jeshernandez/PiTrac/docs/hardware/hardware.md

---
title: Hardware
layout: default
nav_order: 4
has_children: true
description: Complete hardware build guide for PiTrac golf launch monitor including parts list, PCB assembly, 3D printing enclosure, and final assembly instructions.
keywords: DIY golf hardware, launch monitor parts, raspberry pi golf components, PCB assembly golf, 3D print golf enclosure
og_image: /assets/images/logos/PiTrac_Square.png
last_modified_date: 2026-02-20
---

# Hardware

This section covers all the physical components you'll need to build PiTrac, from individual parts to complete assembly guides.

## What you'll find here:

- **[Parts List]({% link hardware/parts-list.md %})** - Complete list of components and supplies needed
- **[Assembly Guide]({% link hardware/assembly-guide.md %})** - Step-by-step instructions for building the V1 enclosure
- **[3D Printing]({% link hardware/3d-printing.md %})** - Guide to printing the V1 and V2 enclosure components
- **[PCB Assembly]({% link hardware/pcb-assembly.md %})** - Instructions for building the connector and led boards
- **[V3 Enclosure Print and Assembly]({% link hardware/V3 Enclosure.md %})** - Instructions for printing and assembly of the V3 Enclosure

<div style="display: flex; gap: 10px; justify-content: center;">
  <div style="text-align: center;">
    <strong>V1</strong><br>
    
  </div>
  <div style="text-align: center;">
    <strong>V2</strong><br>
    
  </div>
  <div style="text-align: center;">
    <strong>V3</strong><br>
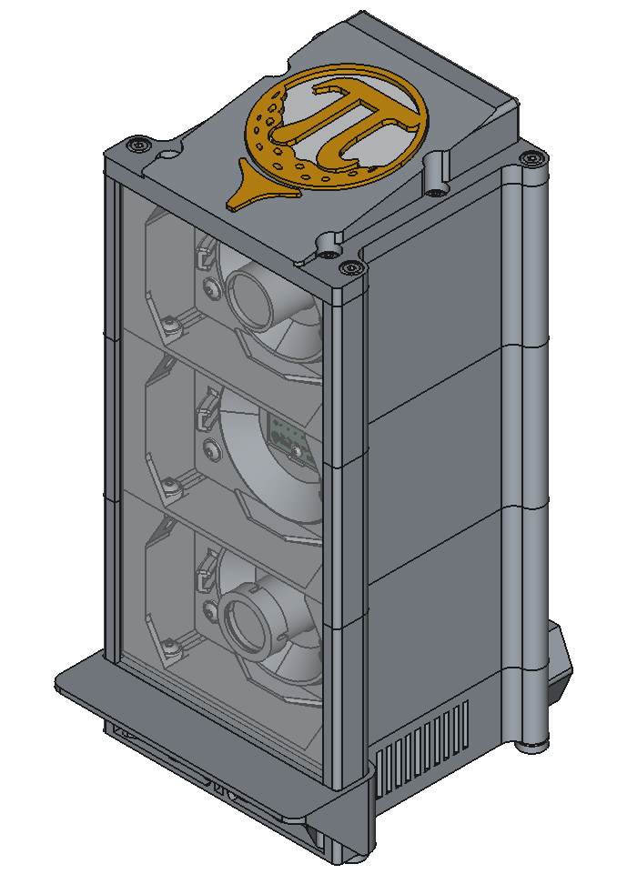
[picture p1: docs/assets/images/V3_Enclosure/PiTrac_V3-Enclosure_crop.png]
    
  </div>
</div>

Before ordering parts, make sure to check the [Roadmap]({% link roadmap.md %}) to understand which version you should build.
