jeshernandez/PiTrac/docs/software/software.md

---
title: Software
layout: default
nav_order: 5
has_children: true
description: Complete software setup guide for PiTrac including Raspberry Pi OS installation, PiTrac software installation, web dashboard configuration, and camera calibration.
keywords: raspberry pi golf software, launch monitor software install, pitrac setup, golf tracker configuration, raspberry pi OS setup
og_image: /assets/images/logos/PiTrac_Square.png
last_modified_date: 2025-01-04
---

# Software

This section covers the software setup and operation of PiTrac, from initial Raspberry Pi configuration to running the system and connecting to simulators.

## What you'll find here:

- **[Raspberry Pi Setup]({% link software/pi-setup.md %})** - Imaging and initial configuration of the Raspberry Pi
- **[PiTrac Installation]({% link software/pitrac-install.md %})** - Building and installing PiTrac software
- **[Using PiTrac]({% link software/using-pitrac.md %})** - Web interface, configuration, and calibration

Before starting software setup, ensure you have completed the [Hardware Assembly]({% link hardware/assembly-guide.md %}) and have all required parts from the [Parts List]({% link hardware/parts-list.md %}).
