jeshernandez/PiTrac/Hardware/Connector Board v2/Design/Pi Connector Strobe Capacitance.xlsx

C | 101.5 | uF
V | 36 | V
Vdroop | 0.25 | V
T | 8 | us
If boost zero duty cycle DOES work
Strobe | Voltage | Joules | DeltaJoules | Power
 | 36 | 0.065772
1 | 35.75 | 0.06486167187 | 0.000910328125 | 113.7910156 | This should be approximately your intended power level
 |  |  |  |  | For example at time of writing we want 36V x 3A = ~108W
If boost zero duty cycle control does NOT work
Strobe | Voltage | Joules | DeltaJoules | Power
 | 36 | 0.065772
1 | 35.75 | 0.06486167187 | 0.000910328125 | 113.7910156
2 | 35.5 | 0.0639576875 | 0.000903984375 | 112.9980469
3 | 35.25 | 0.06306004687 | 0.000897640625 | 112.2050781
4 | 35 | 0.06216875 | 0.000891296875 | 111.4121094
5 | 34.75 | 0.06128379687 | 0.000884953125 | 110.6191406
6 | 34.5 | 0.0604051875 | 0.000878609375 | 109.8261719
7 | 34.25 | 0.05953292187 | 0.000872265625 | 109.0332031
8 | 34 | 0.058667 | 0.000865921875 | 108.2402344
9 | 33.75 | 0.05780742188 | 0.000859578125 | 107.4472656
10 | 33.5 | 0.0569541875 | 0.000853234375 | 106.6542969
