jeshernandez/PiTrac/Hardware/Connector Board v2/Design/Pi Connector Boost Converter.xlsx

Vin | 5 | V
Vout | 42 | V
D | 0.8928571429 | %
Iout | 0.1 | A
Fs | 750 | kHz
deltaI | 0.252 | A
Lest | 2.330561854e-05 | H
L | 33 | uH
deltaIL | 0.1803751804 | A
Ipk | 1.023520924 | A
Vrip | 0.1 | V
Coutmin | 1.19047619e-06 | F
Coutmin2 | 2.836879433e-05 | F
Cout | 101.5 | uF
ESR | 3.3 | mohm | 0.004 || 0.02
Voutesr | 0.003377619048 | V
Mc | 7.637558938
Rcs | 0.2 | ohm
Sn | 30.3030303 | mV/us
Se | 201.1381496 | mV/us
SRC | 1800 | mV/us
Rcsf | 3.132440695 | kohm
wesrz | 2985520.227 | rad/s
fesrz | 475.1603018 | khz
CFB | 3.3495e-05 | uF
