jeshernandez/PiTrac/Hardware/Archive/Connector Board v0.2/README.md

**Description:**

A small PCB that supports:

1. high-speed (up to 1MHz), isolated switching of a high-power signal (12V, 100W) to a device such as an LED strobe; and
2. connecting a GPIO camera shutter signal from one Raspberry Pi to the external trigger (XTR) of a Pi Global Shutter (GS) Camera that is connected to a _second_ Raspberry Pi.

The board uses high-speed opto-isolators to keep the power plane of the two Pi’s isolated from each other and from the 12V switching circuit.

The PCB itself can be manufactured fairly inexpensively from the fabrication outputs at place like <https://jlcpcb.com/> and <https://pcbway.com> .

The [PiTrac DIY golf launch monitor project](https://hackaday.io/project/195042-diy-golf-launch-monitor) is using this board to drive its infrared strobe light and to allow one Pi to trigger the shutter of a second Pi. This is all used to capture the stop-motion images for the monitor.

Please consider supporting this work and the DIY LM project here: <https://ko-fi.com/PiTrac>  

**Parts Needed for Assembly:**

| **Item** | **Qty** | **Reference(s)** | **Value** | **LibPart** | **Footprint / Details** |
| --- | --- | --- | --- | --- | --- |
| 1 | 1 | J3  | ~ | [USB B Micro Female Pinboard](https://www.amazon.com/Pinboard-MELIFE-Interface-Adapter-Breakout/dp/B07W6T97HZ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) | The included pin headers can be used for the parts below |
| 2 | 2 | R1, R4 | 330 ohm R | Resistor (1/4 Watt)<br><br>A decent assortment kit is [here](https://www.amazon.com/gp/product/B003UC4FSS/ref=ppx_yo_dt_b_search_asin_title?ie=UTF8&psc=1) | Resistor_THT:R_Axial_DIN0207_L6.3mm_D2.5mm_P10.16mm_Horizontal |
| 3 | 2 | R2, R3 | 270 ohm R | Resistor (1/4 Watt)| Resistor_THT:R_Axial_DIN0207_L6.3mm_D2.5mm_P10.16mm_Horizontal |
| 4 | 3 | Shutter1, Strobe1, Sys1_GND1 | ~ | &lt;These are just test-point holes to solder test wires into&gt; | TestPoint:TestPoint_THTPad_2.5x2.5mm_Drill1.2mm |
| 5 | 1 | Sys1_Conn1 | ~ | 4 Pin Header | Connector_PinHeader_2.54mm:PinHeader_1x04_P2.54mm_Vertical |
| 6 | 1 | Sys2_Conn1 | ~ | 3 Pin Header | Connector_PinHeader_2.54mm:PinHeader_1x03_P2.54mm_Vertical |
| 7 | 2 | U2, U3 | H11L1 | [Isolator:H11L1](https://www.amazon.com/dp/B09KM2BJCF?ref_=pe_386300_442618370_TE_sc_as_ri_0) | Package_DIP:DIP-6_W7.62mm |
| 8 | 1 | U4  | 74HC04 | 74xx:74HC04 | Package_DIP:DIP-14_W7.62mm_Socket |
| 9 | 1 | U5  | ~ | [Dual_Mos_Driver_Module](https://www.amazon.com/Anmbest-High-Power-Adjustment-Electronic-Brightness/dp/B07NWD8W26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) | Verdant_Custom_Footprint_Library:PCB Dual MOS Driver Module |
| | 2 | 2.5M Bolt<br><br>2.5M Nut | | | These help mechanically tie down the USB-B power connector to the board |
| | 2 | 6 - pin DIP socket | | &lt;Optional&gt;<br><br>A decent assortment kit is [here](https://www.amazon.com/dp/B01GOLSUAU?ref=ppx_yo2ov_dt_b_fed_asin_title) | The opto-isolators and the hex inverter chip are the most likely to be blown up or injured by solder over-temps.  So best to put them in sockets. |
| | 1 | 14 - pin DIP socket<br><br>&lt;Optional&gt; | | &lt;Optional&gt; | |

**Note:** A 5V USB-B power supply with a male micro-USB connector is currently necessary to run the board. The supply is used as an isolated, independent (downstream of a transformer) power plane to try to keep the Pi’s and the Pi Camera safe.

**Final view of top/bottom of completed PCB:**





**NOTE:** Don’t be like the people who made the above boards. For example, use flux-cleaner to get rid of the excess flux when you are done!

**Assembly Notes (see supporting images of the board):**

1. If desired (we suggest it), solder the two 6-Pin DIP sockets and one 14 pin DIP socket for the H11 opto-isolators and the 740s4 hex inverter.
2. Use the two 2.5M bolts and nuts (nuts on the bottom of the PCB) to secure the USB board to the lower-left corner. Strip 1” of a thin wire bare and cut in two half-inch pieces that will fit through the VCC and GND holes of the USB board and through the back of the Connector Board PCB. Bend the ends to hold the wires in place and solder and trim.
3. Solder a header pin post (see picture) into the GND and TRIG holes on the left side of the Dual MOS Driver Module so that at least 2mm of pin sticks out the bottom. Using these headers makes it easier to test-probe the trigger signal. Then insert the lower parts of the pins (as well as the four parts of the pins sticking out below the screw terminals) into the Connector Board PCB and solder. Alternatively, the same wire-through-the component-and-board technique used for the USB board can be used here. The four terminals below the screw terminals are not electrically important for the PCB, but soldering them helps mechanically secure the Dual-MOS switching component.
4. It is useful (but not necessary) to solder three wires to the test ports on the left of the PCB. When something is not working, the ability to hook an oscilloscope up to these ports is important. If you strip the wires on the other end away from the board, make sure you protect them from accidentally contacting other component. [These plugs](https://github.com/jamespilgrim/Wire-end-Plug) can be used for that purpose.
5. Attach the 12V input and output wire pairs to the Dual MOS component’s screw terminals. It’s best NOT to tin the ends, as the terminals seem to make better contact that way. Add some plugs (e.g.,  [Ideal Industries 30-102 Power Plug](https://www.amazon.com/Ideal-Industries-30-102-Power-72427/dp/B01LYF1WV9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).) to the ends of the leads to make it easier to connect/disconnect them later to the strobe and the LED power supply. The use of different ends for input and output (e.g., one male, one female) may make it more difficult to later plug these in wrong (output to input)!
