jeshernandez/PiTrac/Dev/img/menu.png

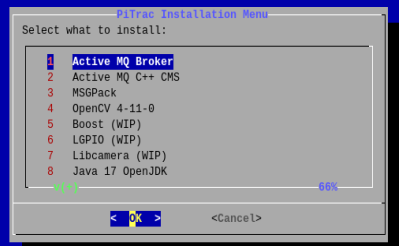
Dev/img/menu.png
