jeshernandez/PiTrac/docs/assets/images/hardware/0805.png

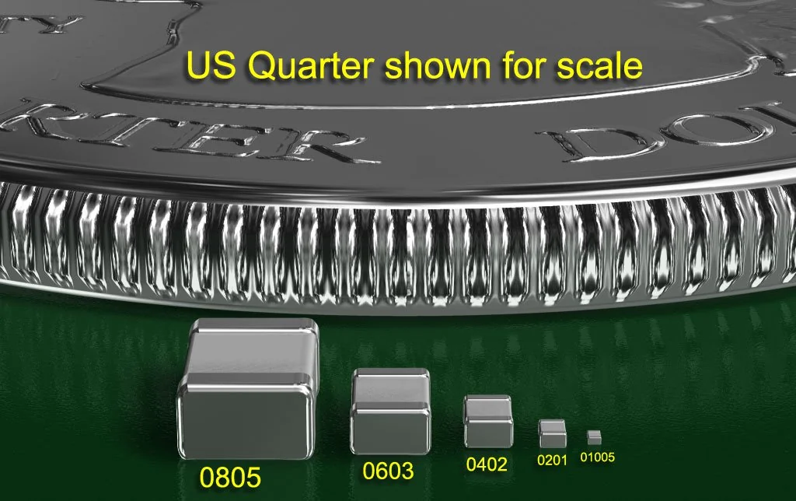
docs/assets/images/hardware/0805.png
