jeshernandez/PiTrac/docs/assets/images/index_replace_name.png

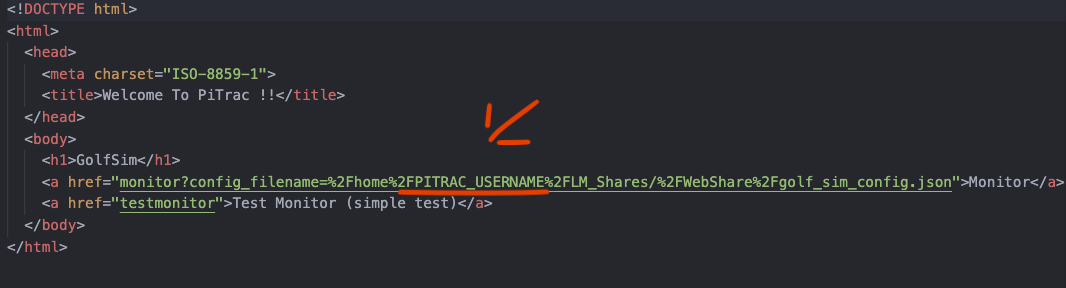
docs/assets/images/index_replace_name.png
