jeshernandez/PiTrac/docs/assets/images/interface/dashboard_dark.png

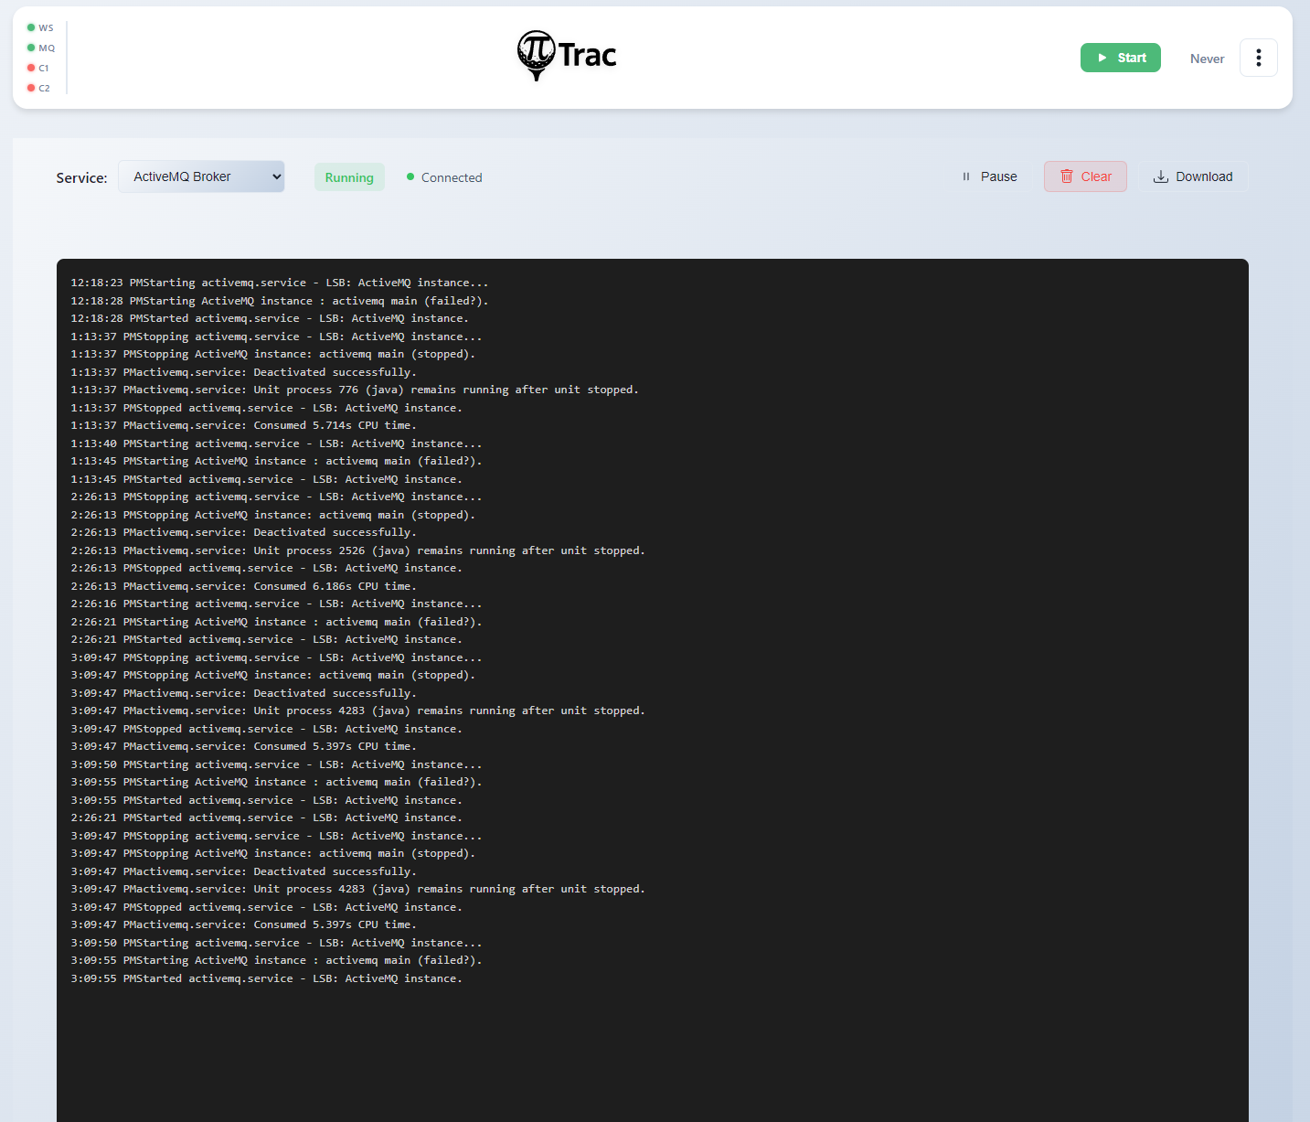
docs/assets/images/interface/dashboard_dark.png
