jeshernandez/PiTrac/Hardware/Connector Board v2/Board Bottomside.png

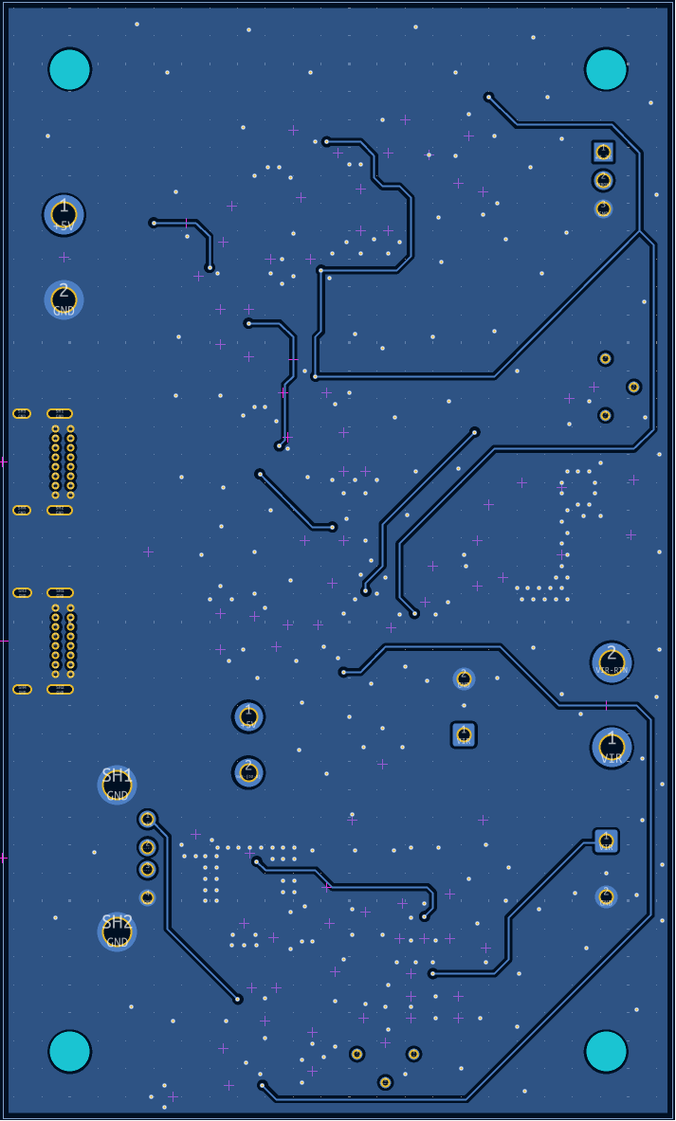
Hardware/Connector Board v2/Board Bottomside.png
