jeshernandez/PiTrac/Hardware/Connector Board v2/Board Topside.png

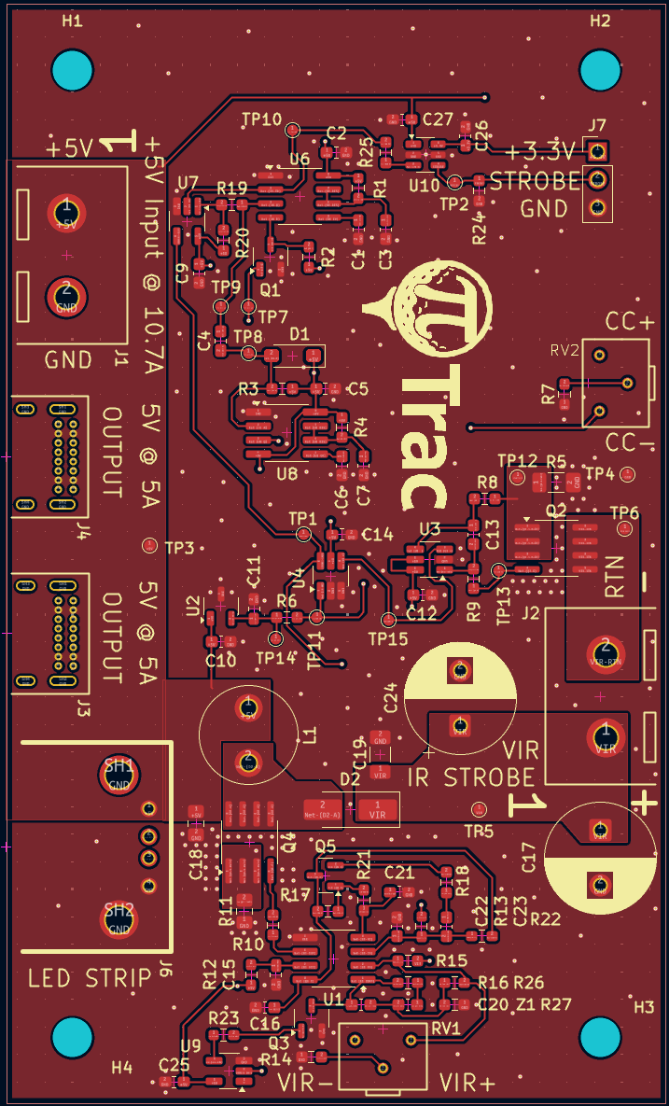
Hardware/Connector Board v2/Board Topside.png
