jeshernandez/PiTrac/Software/LMSourceCode/Images/strobed.png

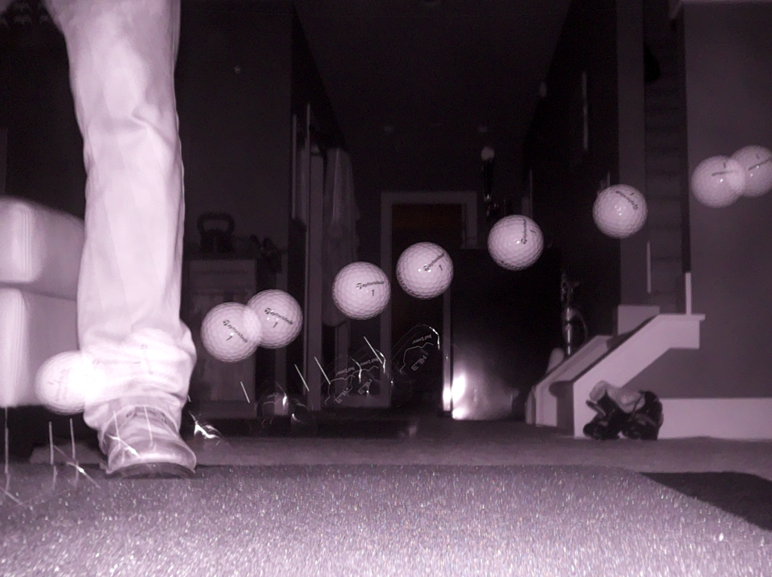
Software/LMSourceCode/Images/strobed.png
