jeshernandez/PiTrac/Software/LMSourceCode/Images/teed-ball.png

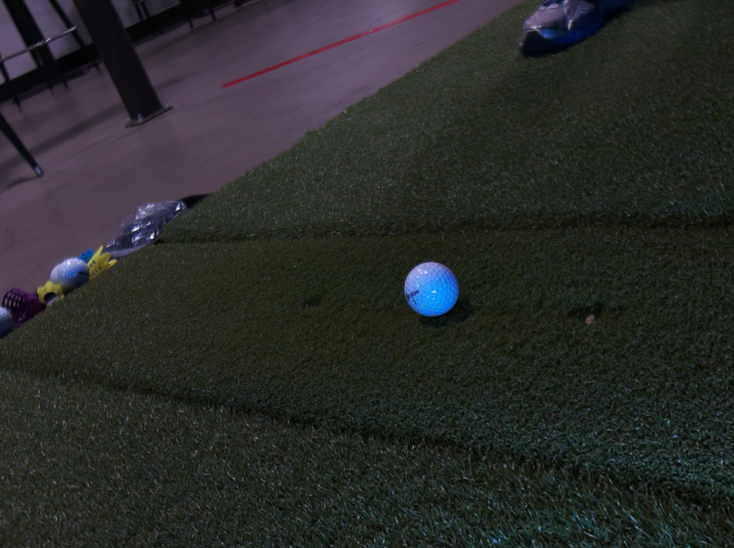
Software/LMSourceCode/Images/teed-ball.png
