jeshernandez/PiTrac/Hardware/Assembly Files/IRLED2 Only PCB/IRLED2 Only Assembly/IRLED2 Only Bill of Materials.csv

Reference | Qty | Manufacturer | Part Number | Footprint
D6,D7,D8,D9,D10,D11,D12,D13,D14,D15 | 10 | Vishay Semiconductor Opto Division | VSMA1085400 | Pi Connector Parts:VSMA1085400
