jeshernandez/PiTrac/Hardware/Connector Board v2/Design/Pi Connector Adjustable Constant Current.xlsx

Vin | 2.5 | V
R1 | 24 | kohm
R2 | 0.25 | kohm | This is the adjustable resistor
R3 | 0.75 | kohm
Vout | 0.1 | V
Rcs | 33 | mohm
Iout | 3.03030303 | A
PR | 0.303030303 | W
