jeshernandez/PiTrac/Hardware/Connector Board v2/Design/Pi Connector Adjustable Strobe Voltage.xlsx

Vfb | 2 | V
Ifbmin | 0.0002 | A
R1 | 4990 | ohm
R2 | 44 | ohm | This is the adjustable resistor
R3 | 249 | ohm
Vout | 36.06143345 | V
Ifbr | 0.0003972983711 | A | Must be greater than Ifbmin
