jeshernandez/PiTrac/3D Printed Parts/Enclosure Version 3/Assets/Part pictures/5x2IRLED_Eyeball.png

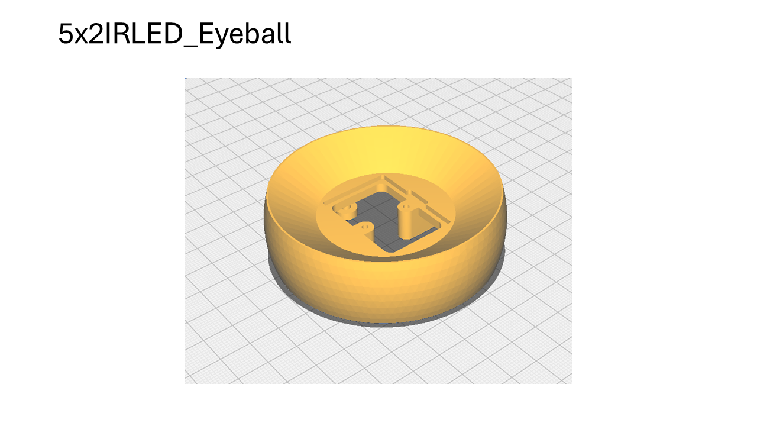
3D Printed Parts/Enclosure Version 3/Assets/Part pictures/5x2IRLED_Eyeball.png
