jeshernandez/PiTrac/3D Printed Parts/Enclosure Version 3/Assets/Part pictures/Ambient_LED_Screen.PNG

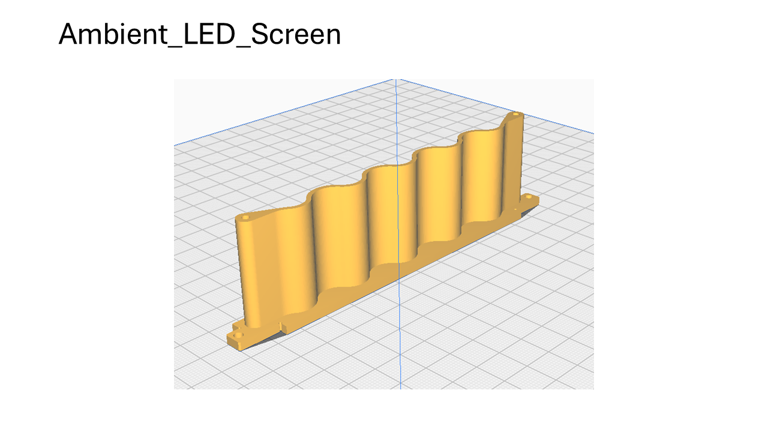
3D Printed Parts/Enclosure Version 3/Assets/Part pictures/Ambient_LED_Screen.PNG
