jeshernandez/PiTrac/3D Printed Parts/Enclosure Version 3/Assets/Part pictures/Ambient_Led_Visor.PNG

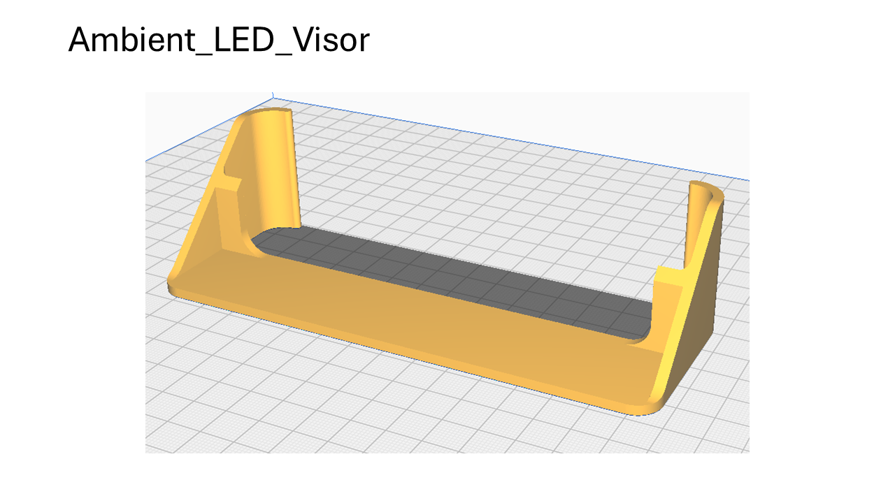
3D Printed Parts/Enclosure Version 3/Assets/Part pictures/Ambient_Led_Visor.PNG
