jeshernandez/PiTrac/3D Printed Parts/Enclosure Version 3/Assets/Part pictures/Back_Interface_Plate.PNG

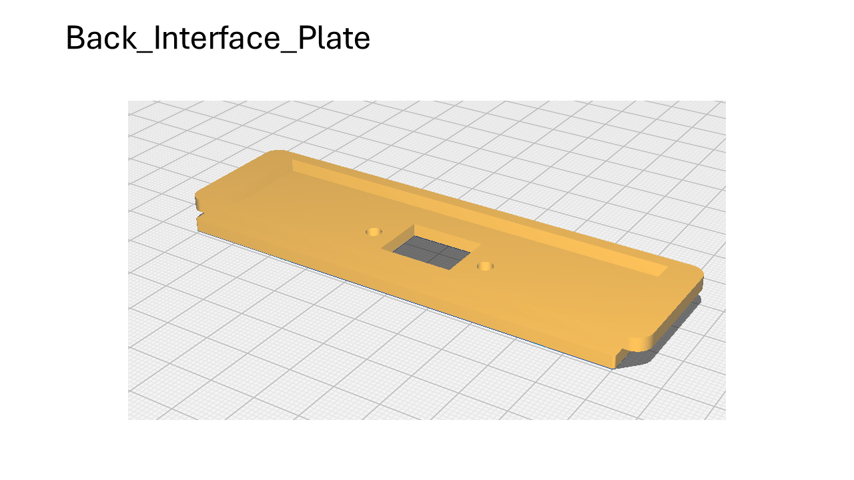
3D Printed Parts/Enclosure Version 3/Assets/Part pictures/Back_Interface_Plate.PNG
