jeshernandez/PiTrac/3D Printed Parts/Enclosure Version 3/Assets/Part pictures/Carrier_Clamps.PNG

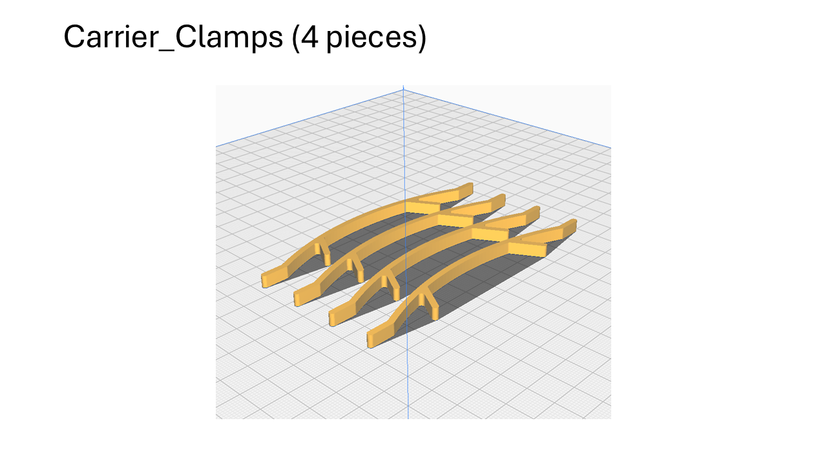
3D Printed Parts/Enclosure Version 3/Assets/Part pictures/Carrier_Clamps.PNG
