jeshernandez/PiTrac/3D Printed Parts/Enclosure Version 3/Assets/Part pictures/ConnectorBoardv2-Mod_Carrier.PNG

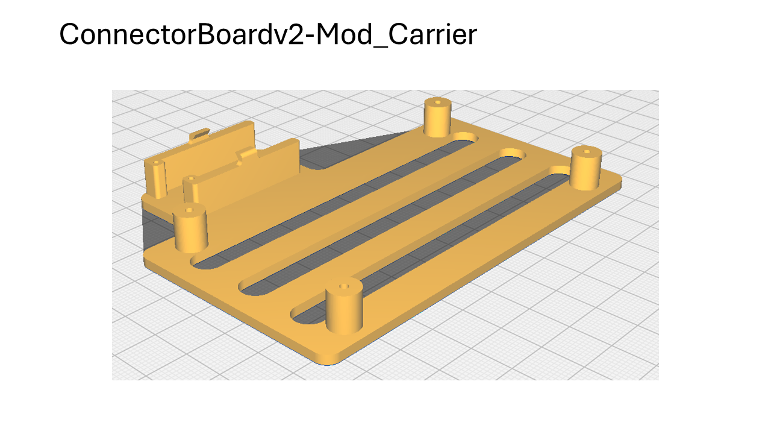
3D Printed Parts/Enclosure Version 3/Assets/Part pictures/ConnectorBoardv2-Mod_Carrier.PNG
