jeshernandez/PiTrac/3D Printed Parts/Enclosure Version 3/Assets/Part pictures/ConnectorBoardv3_Carrier.png

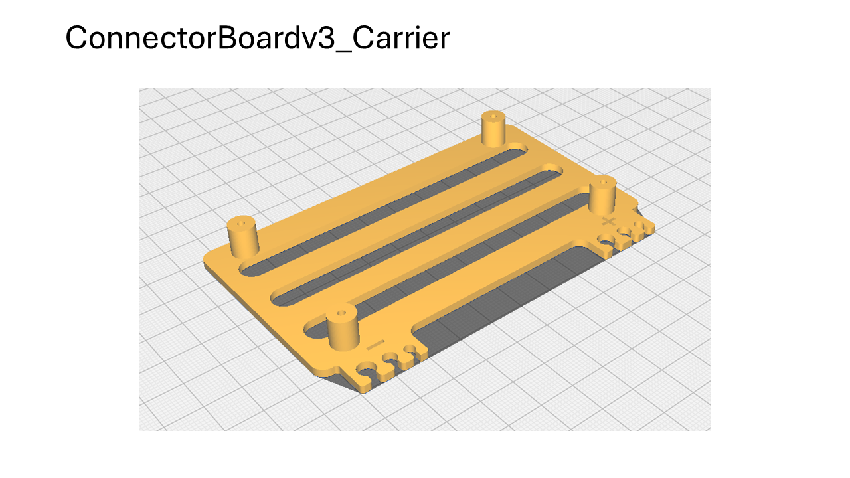
3D Printed Parts/Enclosure Version 3/Assets/Part pictures/ConnectorBoardv3_Carrier.png
