jeshernandez/PiTrac/3D Printed Parts/Enclosure Version 3/Assets/Part pictures/EyeScreen.PNG

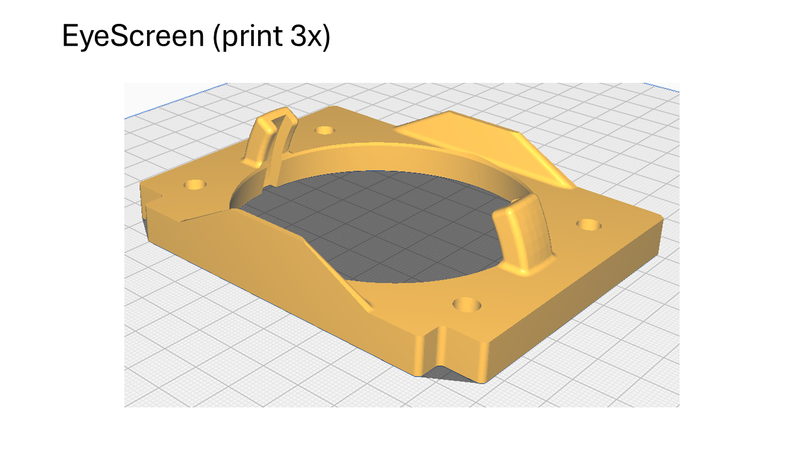
3D Printed Parts/Enclosure Version 3/Assets/Part pictures/EyeScreen.PNG
