jeshernandez/PiTrac/3D Printed Parts/Enclosure Version 3/Assets/Part pictures/Foot.PNG

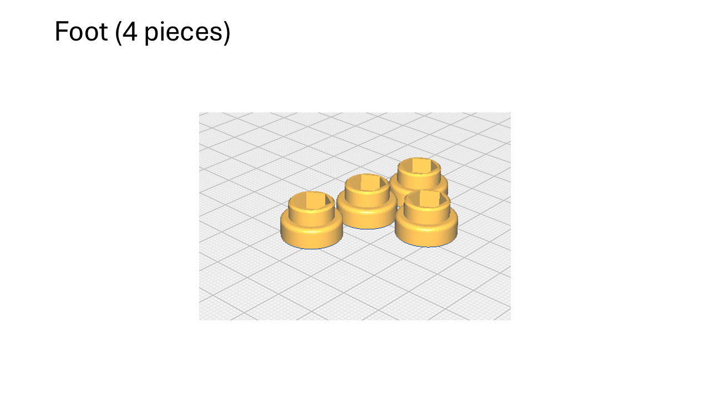
3D Printed Parts/Enclosure Version 3/Assets/Part pictures/Foot.PNG
