jeshernandez/PiTrac/3D Printed Parts/Enclosure Version 3/Assets/Part pictures/IMX296-MPI_Eyeball_6mm.PNG

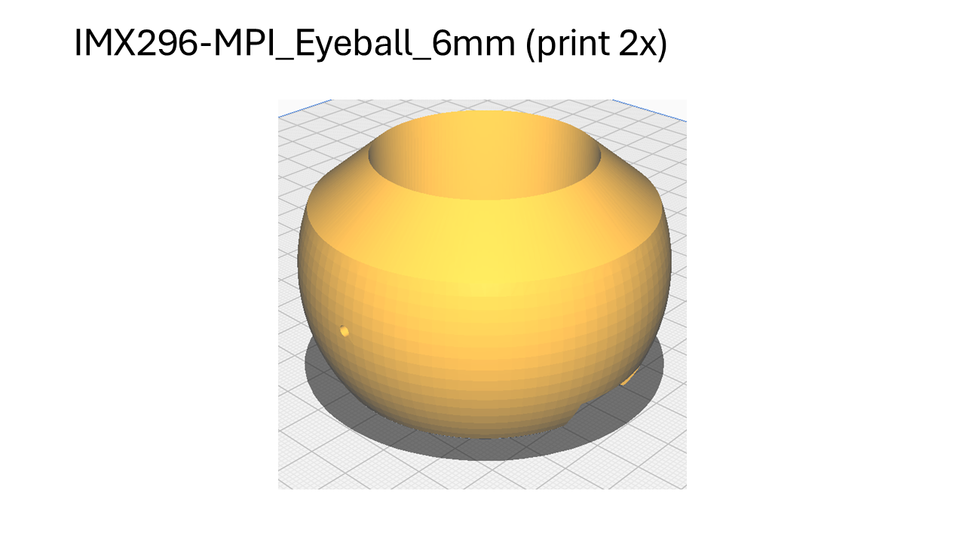
3D Printed Parts/Enclosure Version 3/Assets/Part pictures/IMX296-MPI_Eyeball_6mm.PNG
