jeshernandez/PiTrac/3D Printed Parts/Enclosure Version 3/Assets/Part pictures/LED_Clamp.PNG

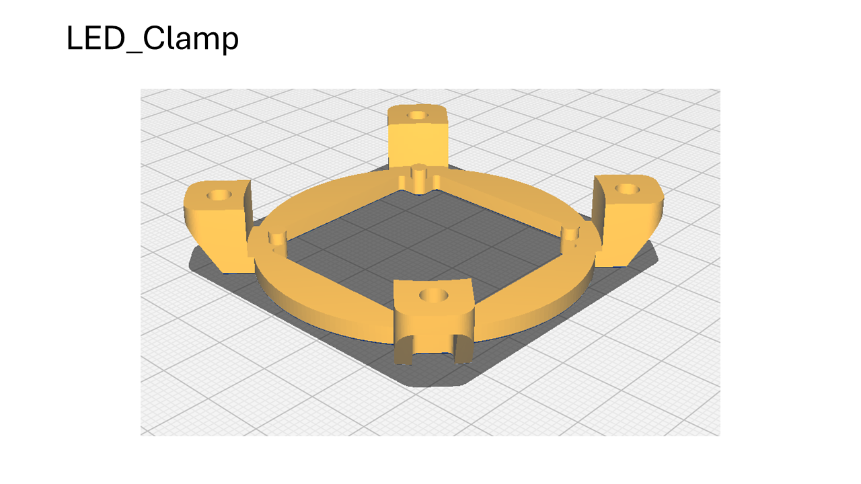
3D Printed Parts/Enclosure Version 3/Assets/Part pictures/LED_Clamp.PNG
