jeshernandez/PiTrac/3D Printed Parts/Enclosure Version 3/Assets/Part pictures/LED_Eyeball.PNG

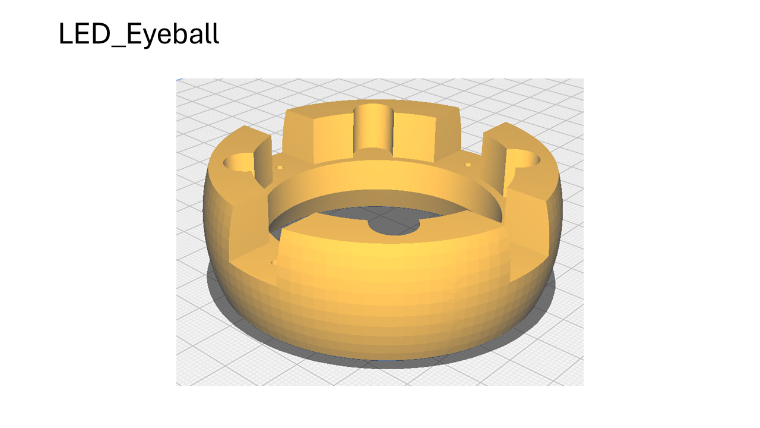
3D Printed Parts/Enclosure Version 3/Assets/Part pictures/LED_Eyeball.PNG
