jeshernandez/PiTrac/3D Printed Parts/Enclosure Version 3/Assets/Part pictures/LinePower_Cover.PNG

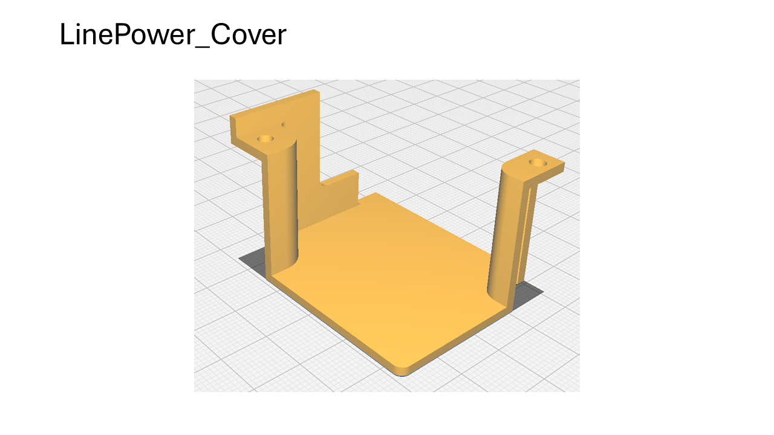
3D Printed Parts/Enclosure Version 3/Assets/Part pictures/LinePower_Cover.PNG
