jeshernandez/PiTrac/3D Printed Parts/Enclosure Version 3/Assets/Part pictures/Pi5_Bagpack _top _bottom.png

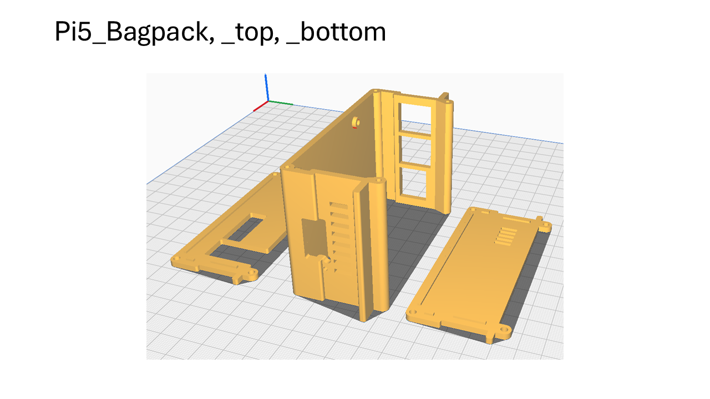
3D Printed Parts/Enclosure Version 3/Assets/Part pictures/Pi5_Bagpack _top _bottom.png
