jeshernandez/PiTrac/3D Printed Parts/Enclosure Version 3/Assets/Part pictures/Pi5_Carrier_vertical_3mm.PNG

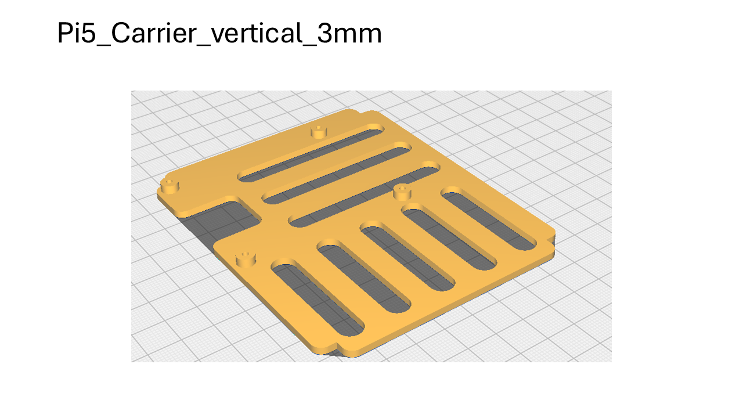
3D Printed Parts/Enclosure Version 3/Assets/Part pictures/Pi5_Carrier_vertical_3mm.PNG
