jeshernandez/PiTrac/3D Printed Parts/Enclosure Version 3/Assets/Part pictures/Spacer.PNG

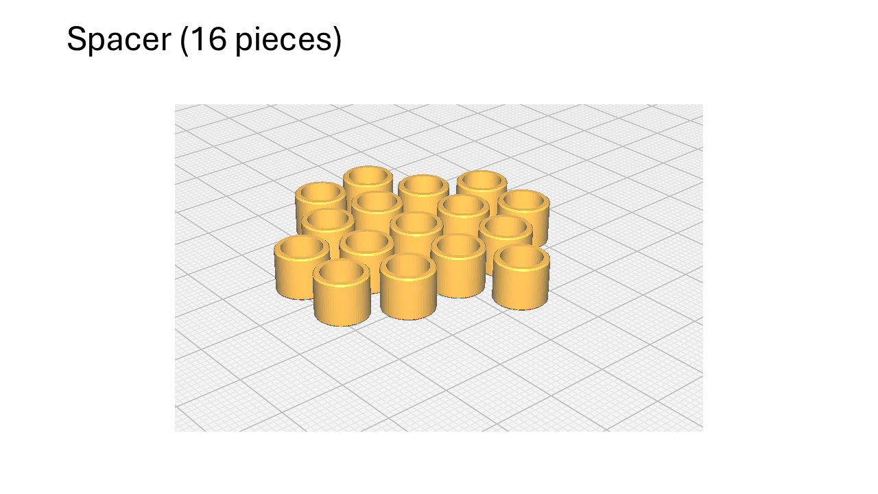
3D Printed Parts/Enclosure Version 3/Assets/Part pictures/Spacer.PNG
