jeshernandez/PiTrac/3D Printed Parts/Enclosure Version 3/Assets/Part pictures/Stack_Module_PSU.PNG

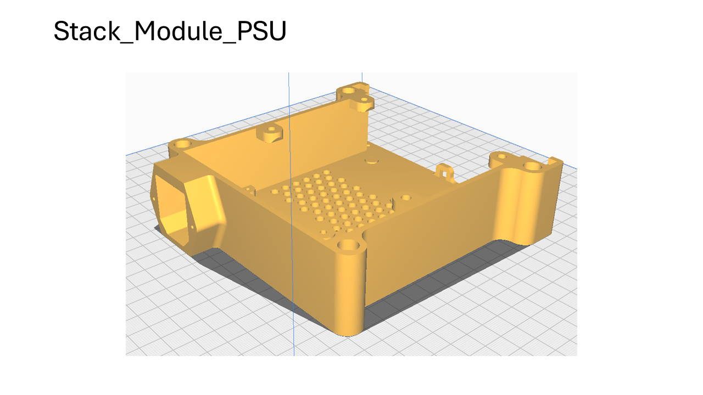
3D Printed Parts/Enclosure Version 3/Assets/Part pictures/Stack_Module_PSU.PNG
