jeshernandez/PiTrac/3D Printed Parts/Enclosure Version 3/Assembly/Assembly4/Assy_Camera_Eyeball.FCStd

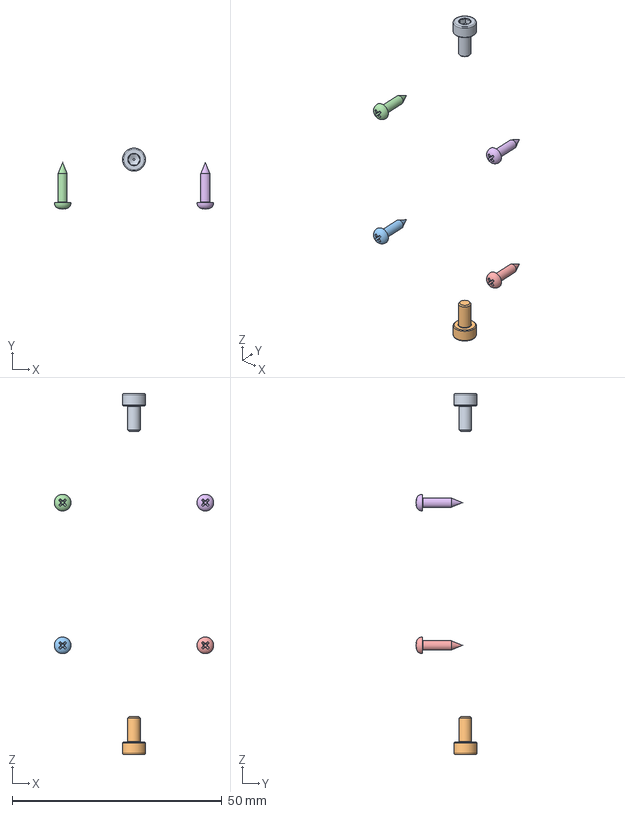
[picture p55: CAD file, 2026-04-10]
3D Printed Parts/Enclosure Version 3/Assembly/Assembly4/Assy_Camera_Eyeball.FCStd
38.0 x 14.5 x 86.0 mm
M3x6-Screw
M3x6-Screw001
ST2.2x9.5-Screw013
ST2.2x9.5-Screw
ST2.2x9.5-Screw014
ST2.2x9.5-Screw015
