jeshernandez/PiTrac/3D Printed Parts/Enclosure Version 3/Assembly/Assembly4/Assy_PiTracIRLED.FCStd

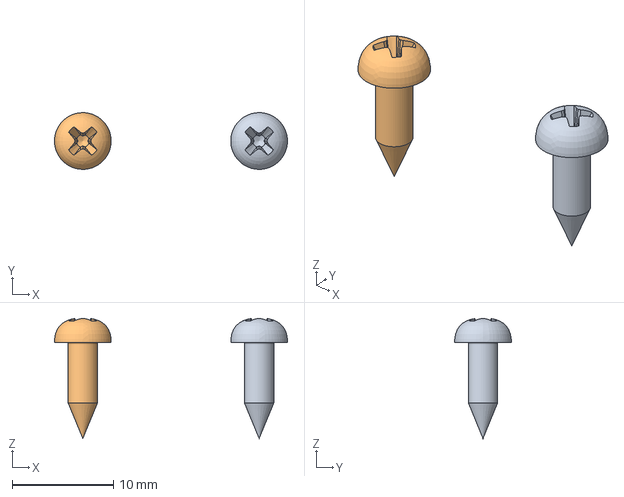
[picture p56: CAD file, 2026-04-10]
3D Printed Parts/Enclosure Version 3/Assembly/Assembly4/Assy_PiTracIRLED.FCStd
23.0 x 5.60 x 11.8 mm
ST2.9x9.5-Screw
ST2.9x9.5-Screw001
