jeshernandez/PiTrac/3D Printed Parts/Enclosure Version 3/Assembly/Assembly4/Assy_Stack_Module.FCStd

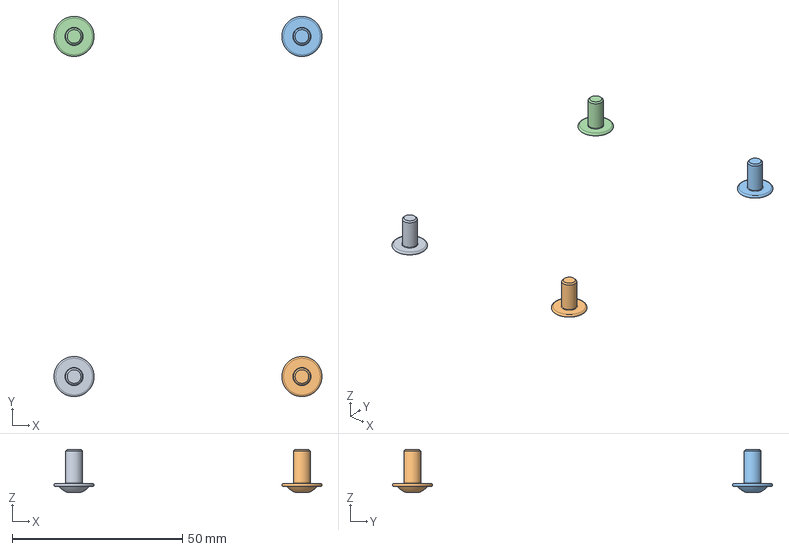
[picture p57: CAD file, 2026-04-10]
3D Printed Parts/Enclosure Version 3/Assembly/Assembly4/Assy_Stack_Module.FCStd
78.8 x 111.8 x 12.8 mm
M5x10-Screw
M5x10-Screw007
M5x10-Screw008
M5x10-Screw009
