jeshernandez/PiTrac/3D Printed Parts/Enclosure Version 3/Assembly/Assembly4/Assy_EyeScreen_Clamp.FCStd

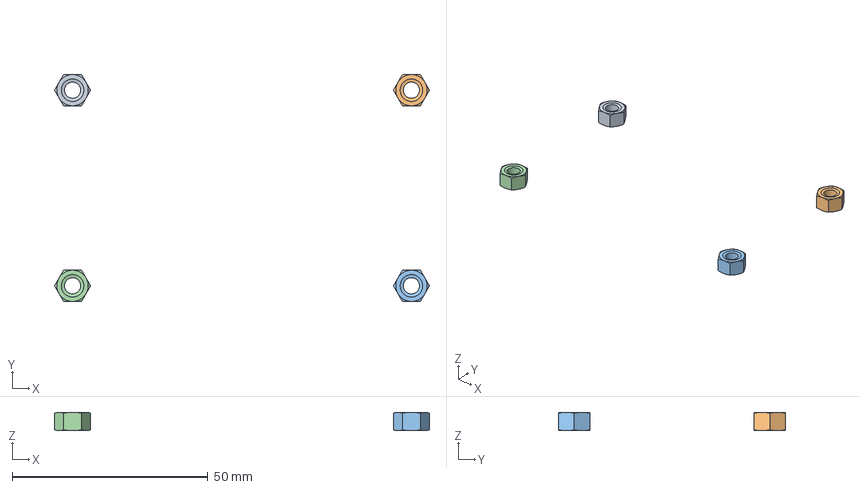
[picture p58: CAD file, 2026-04-10]
3D Printed Parts/Enclosure Version 3/Assembly/Assembly4/Assy_EyeScreen_Clamp.FCStd
95.8 x 58.0 x 4.70 mm
M5-Nut
M5-Nut004
M5-Nut005
M5-Nut006
