jeshernandez/PiTrac/3D Printed Parts/Enclosure Version 3/Assembly/Assembly4/Assy_RaspberryPi5_carrier.FCStd

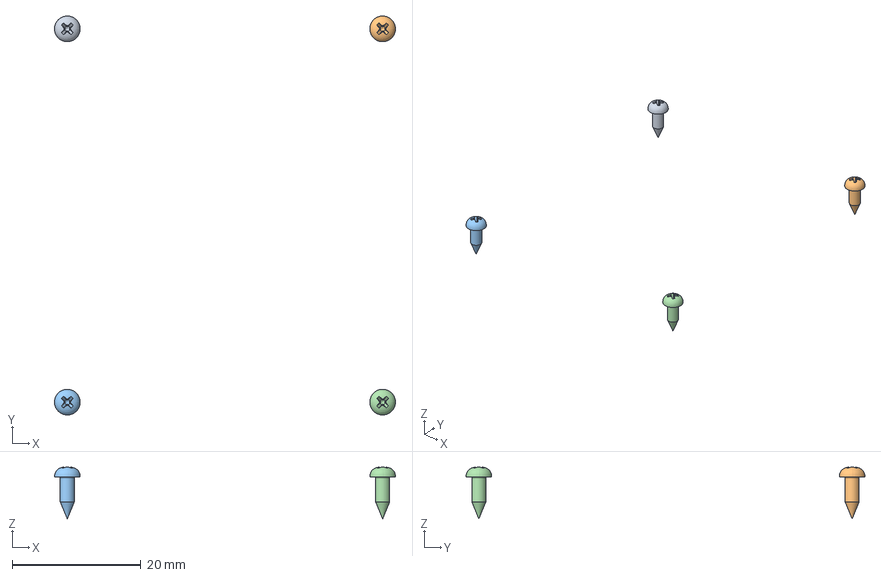
[picture p59: CAD file, 2026-04-10]
3D Printed Parts/Enclosure Version 3/Assembly/Assembly4/Assy_RaspberryPi5_carrier.FCStd
53.0 x 62.0 x 8.07 mm
ST2.2x6.5-Screw
ST2.2x6.5-Screw004
ST2.2x6.5-Screw005
ST2.2x6.5-Screw006
