jeshernandez/PiTrac/3D Printed Parts/Enclosure Version 3/Assembly/Assembly_Pi_Bagpack.FCStd

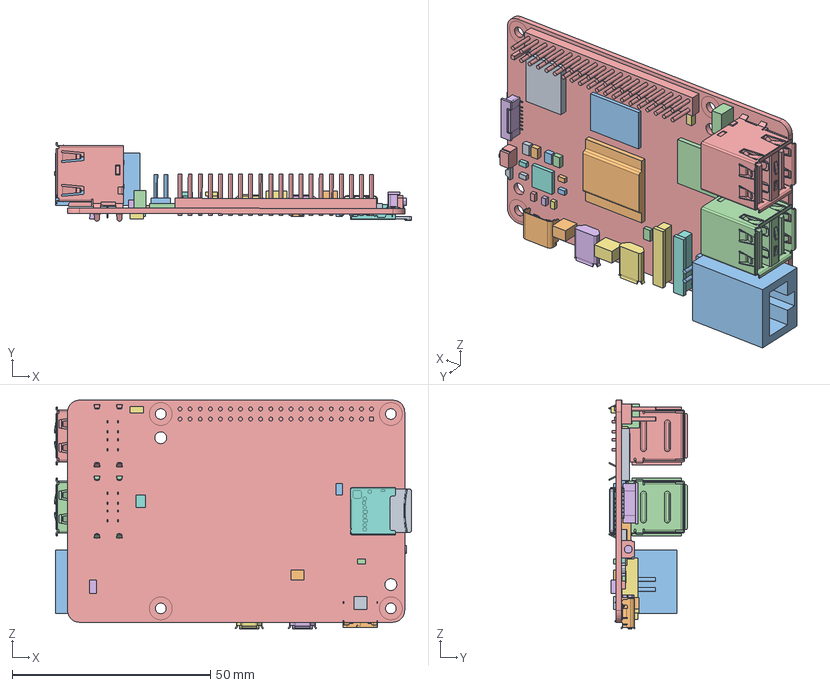
[picture p60: CAD file, 2026-04-10]
3D Printed Parts/Enclosure Version 3/Assembly/Assembly_Pi_Bagpack.FCStd
90.0 x 19.8 x 57.7 mm
PCB_for REF 060923
PCB_for REF 060924
PCB_for REF 060925
PCB_for REF 060926
PCB_for REF 060927
PCB_for REF 060928
PCB_for REF 060929
PCB_for REF 060930
PCB_for REF 060931
PCB_for REF 060932
PCB_for REF 060933
PCB_for REF 060934
PCB_for REF 060935
PCB_for REF 060936
PCB_for REF 060937
PCB_for REF 060938
PCB_for REF 060939
PCB_for REF 060940
PCB_for REF 060941
PCB_for REF 060942
PCB_for REF 060943
PCB_for REF 060944
PCB_for REF 060945
PCB_for REF 060946
PCB_for REF 060947
PCB_for REF 060948
PCB_for REF 060949
PCB_for REF 060950
GPIO Header for REF
Micro HDMI for REF
Micro HDMI for REF001
SD CARD for REF
SD CARD for REF001
USB-C for REF
RJ45 for REF
USB for REF
USB for REF001
PCIe for REF
CAM-DISP for REF
CAM-DISP for REF001
LED for REF
BAT Header for REF
PoE Header for REF
FAN Header for REF
SWITCH for REF
SWITCH for REF001
UART for REF
