jeshernandez/PiTrac/3D Printed Parts/Enclosure Version 3/Assembly/Assembly4/Assy_EyeScreen.FCStd

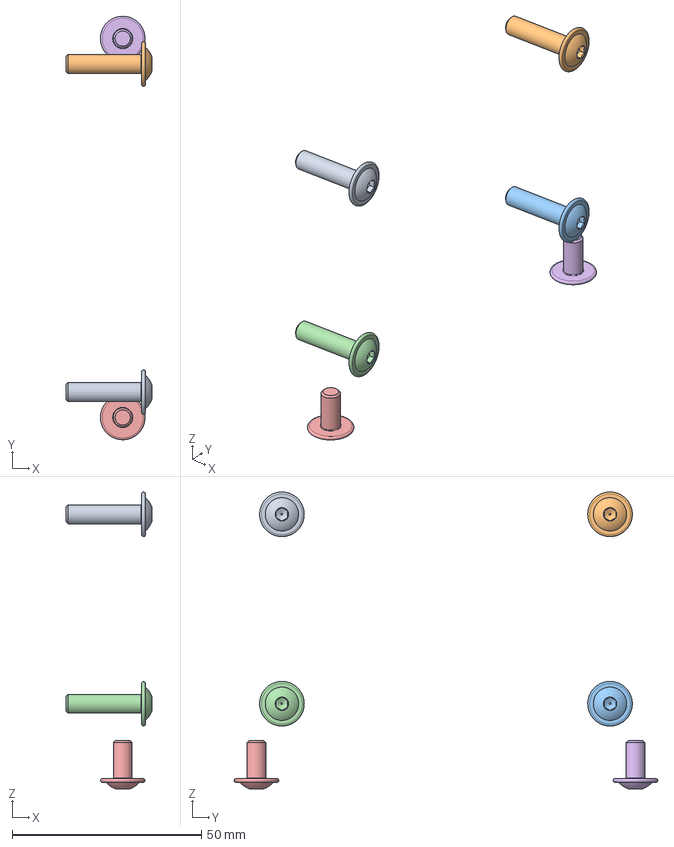
[picture p61: CAD file, 2026-04-10]
3D Printed Parts/Enclosure Version 3/Assembly/Assembly4/Assy_EyeScreen.FCStd
22.8 x 111.8 x 78.4 mm
M5x20-Screw
M5x20-Screw012
M5x20-Screw013
M5x20-Screw014
M5x10-Screw
M5x10-Screw001
