jeshernandez/PiTrac/3D Printed Parts/Enclosure Version 3/Assembly/Assembly4/Assy_M5_rod.FCStd

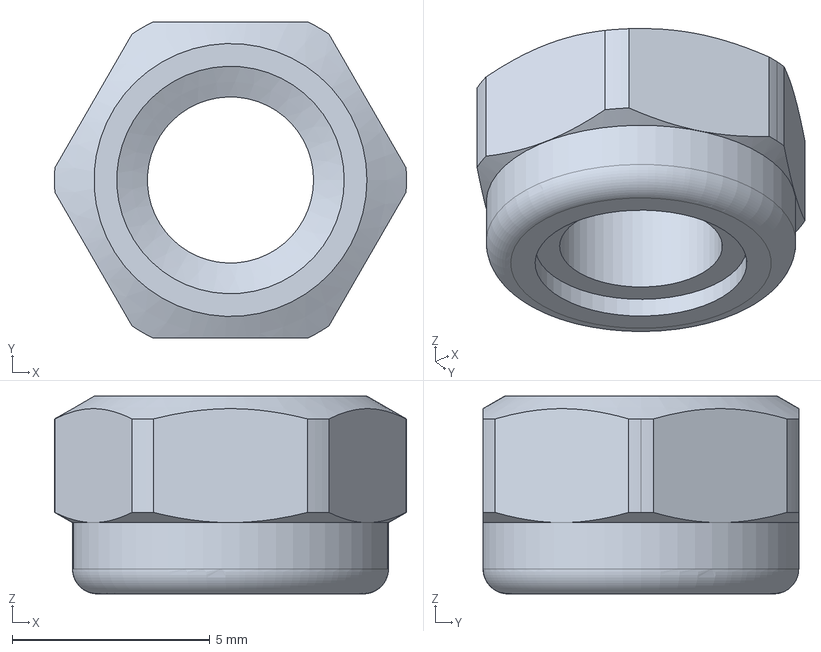
[picture p62: CAD file, 2026-04-10]
3D Printed Parts/Enclosure Version 3/Assembly/Assembly4/Assy_M5_rod.FCStd
8.90 x 8.00 x 5.00 mm
