jeshernandez/PiTrac/3D Printed Parts/Enclosure Version 3/Assembly/Assembly4/Assy_Stack_Module_PSU.FCStd

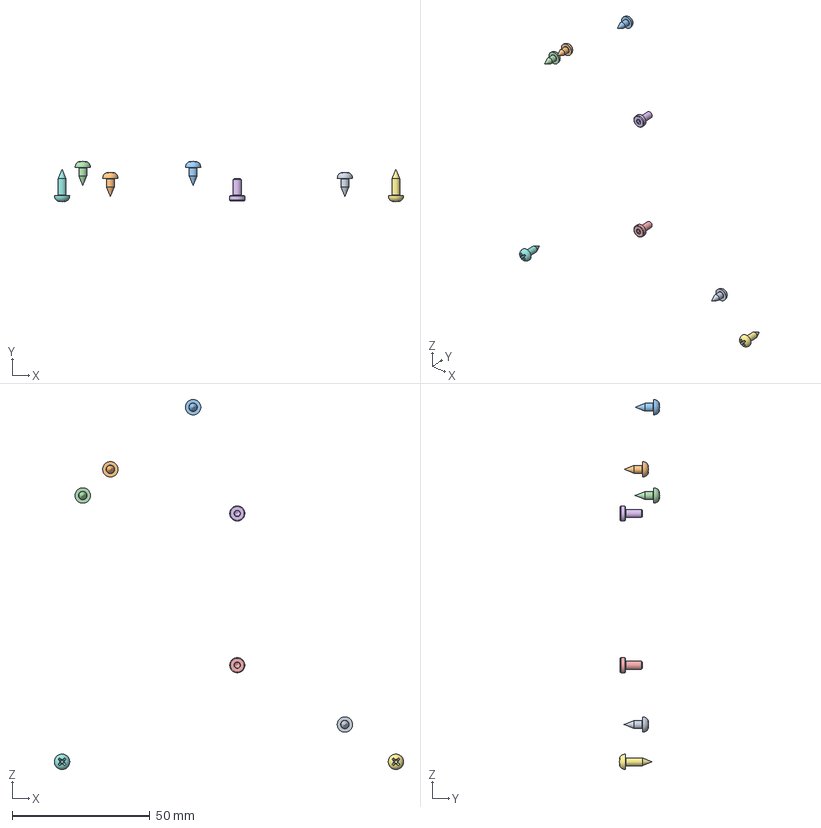
[picture p63: CAD file, 2026-04-10]
3D Printed Parts/Enclosure Version 3/Assembly/Assembly4/Assy_Stack_Module_PSU.FCStd
126.6 x 14.7 x 134.1 mm
ST2.9x6.5-Screw013
ST2.9x6.5-Screw
ST2.9x6.5-Screw014
ST2.9x6.5-Screw015
M3x6-Screw
M3x6-Screw001
ST2.9x9.5-Screw
ST2.9x9.5-Screw001
