jeshernandez/PiTrac/3D Printed Parts/Enclosure Version 3/Assembly/Assembly4/Assy_V3Connector_Board.FCStd

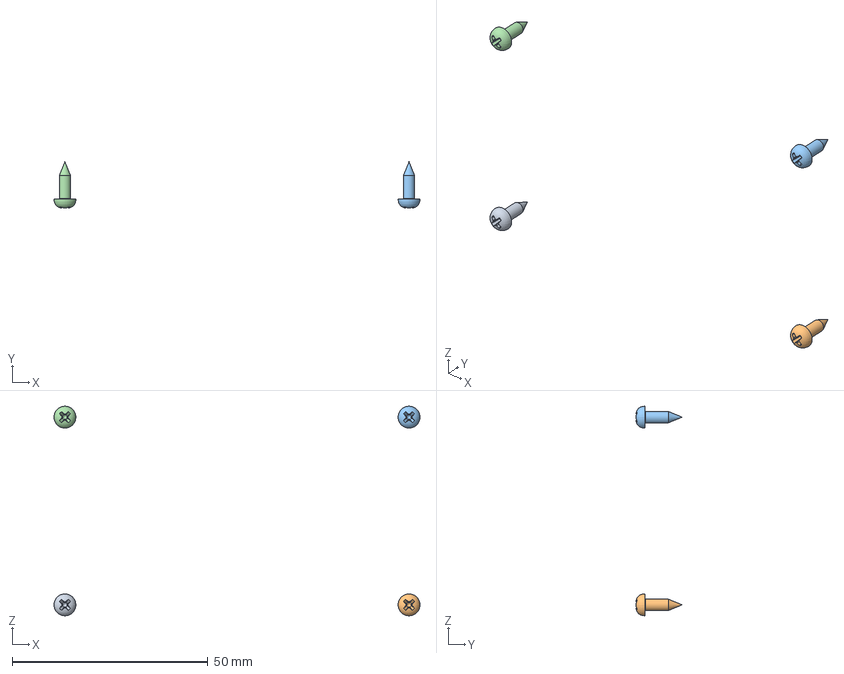
[picture p64: CAD file, 2026-04-10]
3D Printed Parts/Enclosure Version 3/Assembly/Assembly4/Assy_V3Connector_Board.FCStd
93.6 x 11.8 x 53.6 mm
ST2.9x9.5-Screw
ST2.9x9.5-Screw004
ST2.9x9.5-Screw005
ST2.9x9.5-Screw006
