jeshernandez/PiTrac/3D Printed Parts/Enclosure Version 3/Assembly/Assembly4/Assy_Foot.FCStd

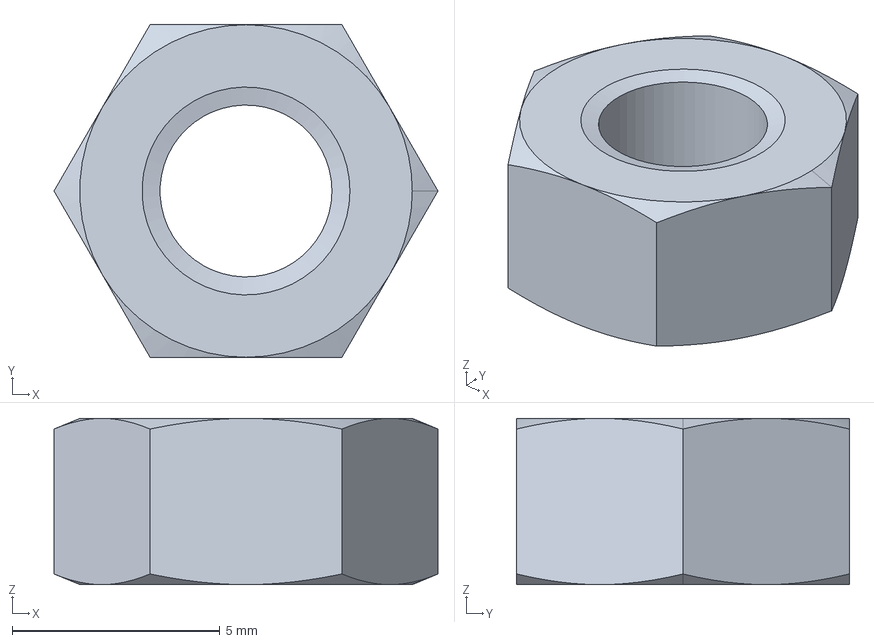
[picture p65: CAD file, 2026-04-10]
3D Printed Parts/Enclosure Version 3/Assembly/Assembly4/Assy_Foot.FCStd
9.24 x 8.00 x 4.00 mm
