jeshernandez/PiTrac/3D Printed Parts/Enclosure Version 3/Assembly/Assembly4/Assy_Stack_Module_Cover_forInserts.FCStd

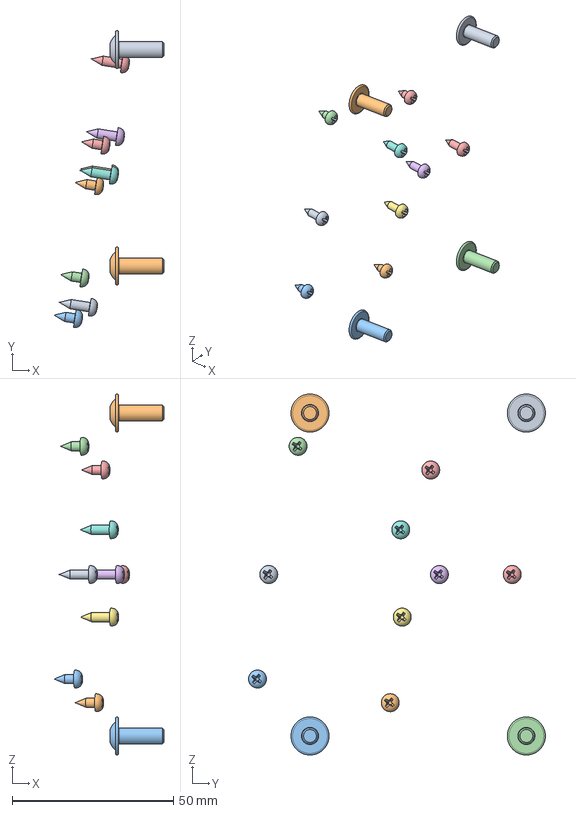
[picture p66: CAD file, 2026-04-10]
3D Printed Parts/Enclosure Version 3/Assembly/Assembly4/Assy_Stack_Module_Cover_forInserts.FCStd
34.0 x 91.9 x 111.8 mm
M5x14-Screw
M5x14-Screw007
M5x14-Screw008
M5x14-Screw009
ST2.9x9.5-Screw
ST2.9x9.5-Screw009
ST2.9x9.5-Screw010
ST2.9x9.5-Screw011
ST2.9x9.5-Screw012
ST2.9x6.5-Screw
ST2.9x6.5-Screw012
ST2.9x6.5-Screw013
ST2.9x6.5-Screw014
