jeshernandez/PiTrac/3D Printed Parts/Enclosure Version 3/Assets/PiTrac_Square_R14_simplified.dxf

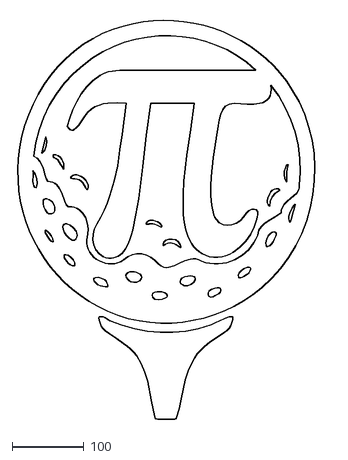
[picture p67: CAD file, 2026-04-10]
3D Printed Parts/Enclosure Version 3/Assets/PiTrac_Square_R14_simplified.dxf
440.1 x 562.7
