jeshernandez/PiTrac/3D Printed Parts/Enclosure Version 3/Part/Calibration Rig/Z Axis Leg.step

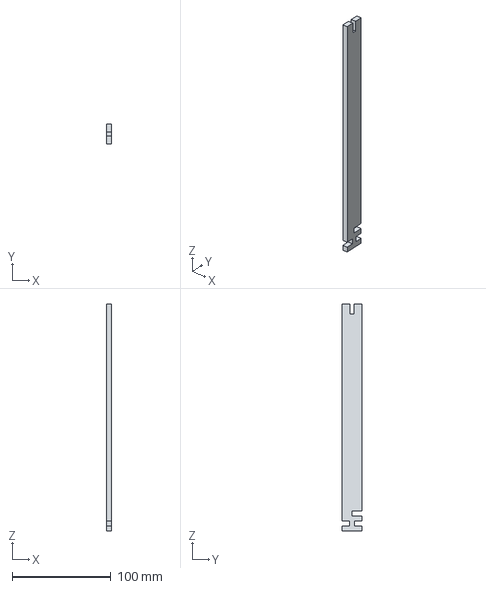
[picture p68: CAD file, 2026-04-10]
3D Printed Parts/Enclosure Version 3/Part/Calibration Rig/Z Axis Leg.step
5.00 x 20.0 x 230.0 mm
