jeshernandez/PiTrac/3D Printed Parts/Enclosure Version 3/Part/Misc/Golfball.FCStd

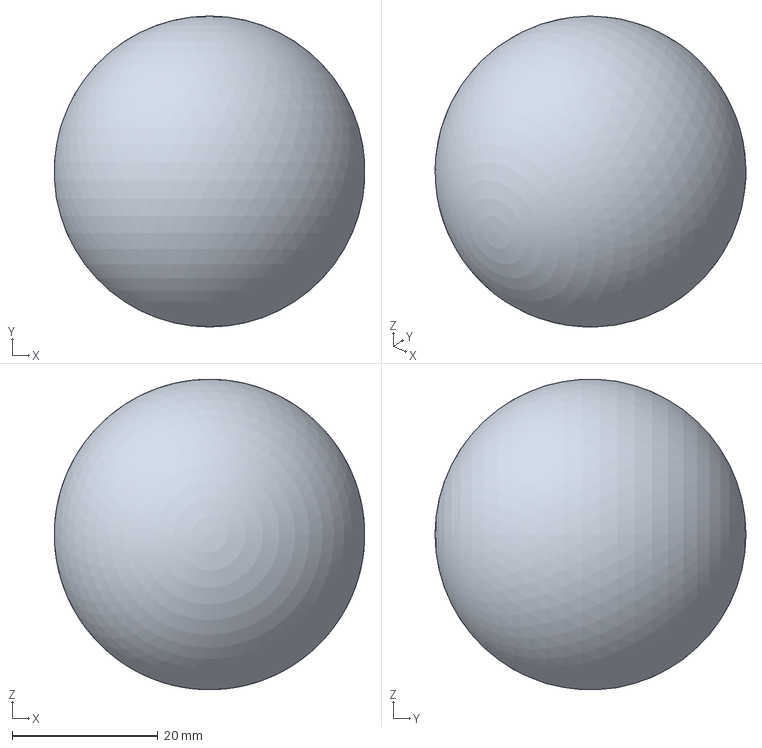
[picture p69: CAD file, 2026-04-10]
3D Printed Parts/Enclosure Version 3/Part/Misc/Golfball.FCStd
42.6 x 42.7 x 42.6 mm
