jeshernandez/PiTrac/3D Printed Parts/Enclosure Version 3/Part/Print/Stack_Module_PSU_vent.step

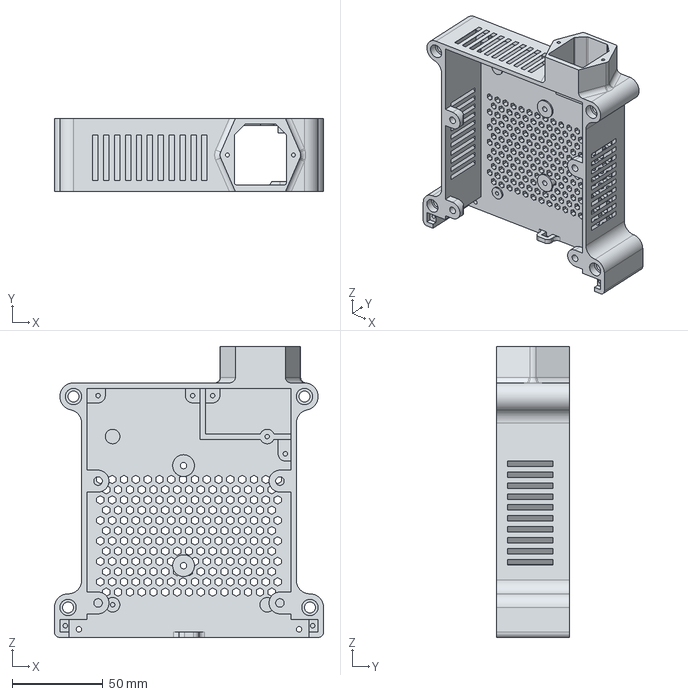
[picture p70: CAD file, 2026-04-10]
3D Printed Parts/Enclosure Version 3/Part/Print/Stack_Module_PSU_vent.step
148.0 x 40.3 x 160.0 mm
