jeshernandez/PiTrac/3D Printed Parts/Enclosure Version 3/Part/Purchase/LRS-75.FCStd

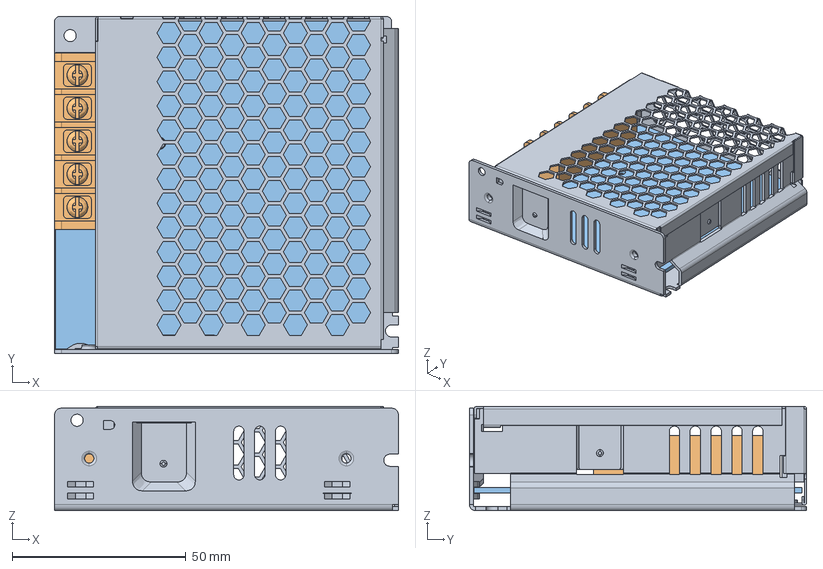
[picture p72: CAD file, 2026-04-10]
3D Printed Parts/Enclosure Version 3/Part/Purchase/LRS-75.FCStd
99.0 x 97.0 x 30.0 mm
TY_2
TN_1_1_1_1_1
PCB
