jeshernandez/PiTrac/3D Printed Parts/Enclosure Version 3/Assets/Stack_Module_Cover_Logo.FCStd

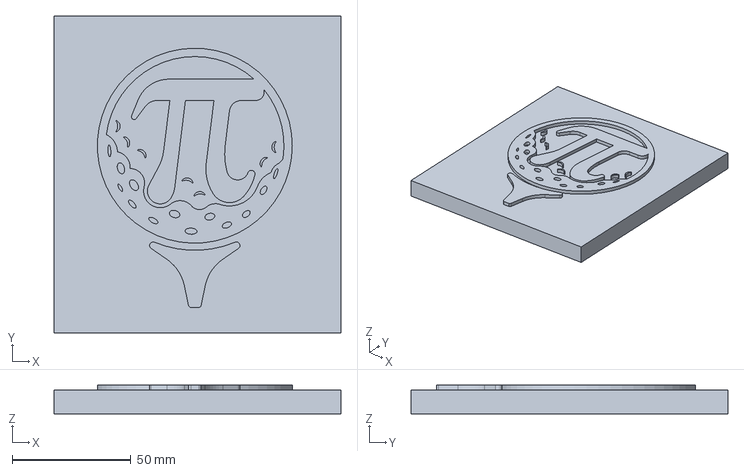
[picture p73: CAD file, 2026-04-10]
3D Printed Parts/Enclosure Version 3/Assets/Stack_Module_Cover_Logo.FCStd
120.7 x 133.4 x 12.0 mm
