jeshernandez/PiTrac/3D Printed Parts/Enclosure Version 3/Part/Calibration Rig/X Axis Far Leg.step

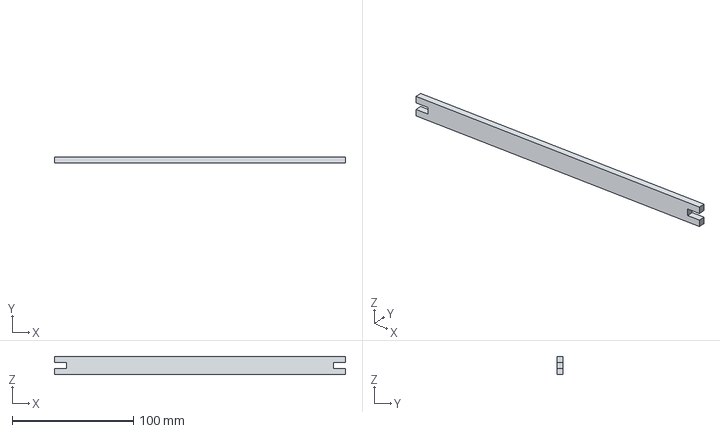
[picture p74: CAD file, 2026-04-10]
3D Printed Parts/Enclosure Version 3/Part/Calibration Rig/X Axis Far Leg.step
240.0 x 5.00 x 15.0 mm
