jeshernandez/PiTrac/3D Printed Parts/Enclosure Version 3/Part/Misc/Floor.FCStd

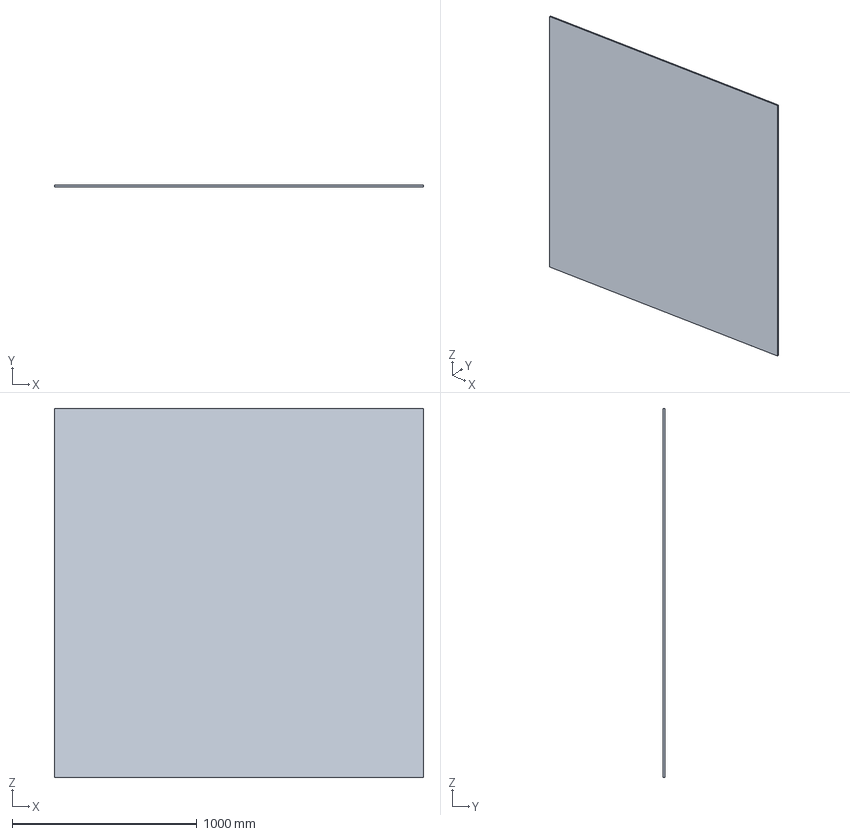
[picture p75: CAD file, 2026-04-10]
3D Printed Parts/Enclosure Version 3/Part/Misc/Floor.FCStd
2000.0 x 10.0 x 2000.0 mm
