jeshernandez/PiTrac/3D Printed Parts/Enclosure Version 3/Part/Print/IMX296-MPI_Eyeball_6mm_camfered.step

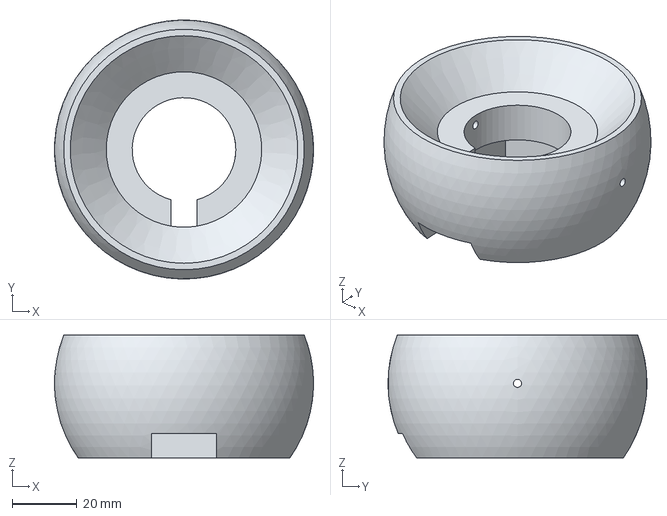
[picture p76: CAD file, 2026-04-10]
3D Printed Parts/Enclosure Version 3/Part/Print/IMX296-MPI_Eyeball_6mm_camfered.step
80.0 x 80.0 x 37.9 mm
