jeshernandez/PiTrac/3D Printed Parts/Enclosure Version 3/Part/Print/Variants/Pi5_Carrier_9mm.stp

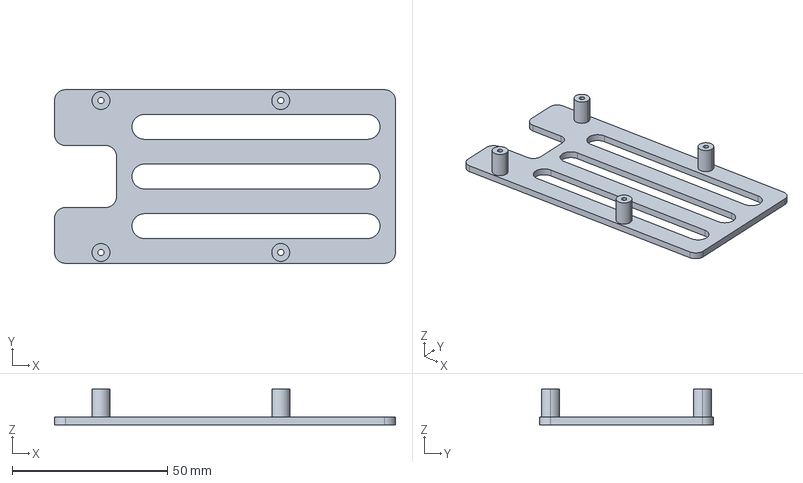
[picture p77: CAD file, 2026-04-10]
3D Printed Parts/Enclosure Version 3/Part/Print/Variants/Pi5_Carrier_9mm.stp
110.0 x 56.0 x 11.5 mm
