jeshernandez/PiTrac/3D Printed Parts/Enclosure Version 3/Part/Purchase/V3_Connector_board.FCStd

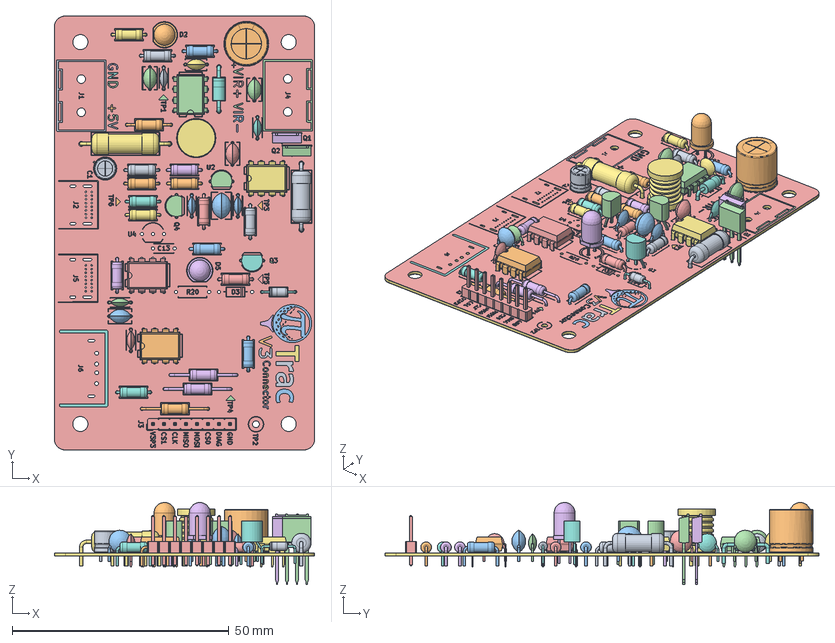
[picture p78: CAD file, 2026-04-10]
3D Printed Parts/Enclosure Version 3/Part/Purchase/V3_Connector_board.FCStd
60.0 x 100.0 x 18.9 mm
CP_Radial_D5.0mm_P2.00mm
LED_D5.0mm
R_Axial_DIN0207_L6.3mm_D2.5mm_P7.62mm_Horizontal
DIP-8_W7.62mm
DIP-8_W7.62mm001
R_Axial_DIN0207_L6.3mm_D2.5mm_P7.62mm_Horizontal001
R_Axial_DIN0207_L6.3mm_D2.5mm_P7.62mm_Horizontal002
D_DO-35_SOD27_P7.62mm_Horizontal
D_DO-35_SOD27_P7.62mm_Horizontal001
R_Axial_DIN0207_L6.3mm_D2.5mm_P7.62mm_Horizontal003
C_Disc_D5.1mm_W3.2mm_P5.00mm
TO-251-3_Vertical
C_Disc_D5.1mm_W3.2mm_P5.00mm001
R_Axial_DIN0207_L6.3mm_D2.5mm_P7.62mm_Horizontal004
C_Disc_D4.7mm_W2.5mm_P5.00mm
D_DO-41_SOD81_P10.16mm_Horizontal
R_Axial_DIN0207_L6.3mm_D2.5mm_P7.62mm_Horizontal005
R_Axial_DIN0207_L6.3mm_D2.5mm_P10.16mm_Horizontal
C_Disc_D4.3mm_W1.9mm_P5.00mm
TO-92_Inline_Wide
R_Axial_DIN0207_L6.3mm_D2.5mm_P7.62mm_Horizontal006
R_Axial_DIN0207_L6.3mm_D2.5mm_P15.24mm_Horizontal
R_Axial_DIN0516_L15.5mm_D5.0mm_P20.32mm_Horizontal
TO-92_Inline_Wide001
R_Axial_DIN0414_L11.9mm_D4.5mm_P15.24mm_Horizontal
R_Axial_DIN0207_L6.3mm_D2.5mm_P7.62mm_Horizontal007
R_Axial_DIN0207_L6.3mm_D2.5mm_P7.62mm_Horizontal008
TO-92_Inline_Wide002
C_Disc_D4.3mm_W1.9mm_P5.00mm001
R_Axial_DIN0207_L6.3mm_D2.5mm_P15.24mm_Horizontal001
L_Radial_D8.7mm_P5.00mm_Fastron_07HCP
R_Axial_DIN0207_L6.3mm_D2.5mm_P7.62mm_Horizontal009
R_Axial_DIN0207_L6.3mm_D2.5mm_P7.62mm_Horizontal010
R_Axial_DIN0207_L6.3mm_D2.5mm_P15.24mm_Horizontal002
C_Disc_D4.3mm_W1.9mm_P5.00mm002
C_Disc_D5.1mm_W3.2mm_P5.00mm002
PinHeader_1x08_P2.54mm_Vertical
TO-251-3_Vertical001
DIP-8_W7.62mm002
R_Axial_DIN0207_L6.3mm_D2.5mm_P7.62mm_Horizontal011
R_Axial_DIN0207_L6.3mm_D2.5mm_P7.62mm_Horizontal012
DIP-8_W7.62mm003
C_Disc_D6.0mm_W4.4mm_P5.00mm
C_Disc_D5.1mm_W3.2mm_P5.00mm003
R_Axial_DIN0207_L6.3mm_D2.5mm_P7.62mm_Horizontal013
LED_D5.0mm001
R_Axial_DIN0207_L6.3mm_D2.5mm_P7.62mm_Horizontal014
C_Disc_D4.3mm_W1.9mm_P5.00mm003
C_Disc_D4.3mm_W1.9mm_P5.00mm004
CP_Radial_D10.0mm_P5.00mm
R_Axial_DIN0207_L6.3mm_D2.5mm_P7.62mm_Horizontal015
C_Disc_D4.3mm_W1.9mm_P5.00mm005
V3 Connector Only_silkscreen
V3 Connector Only_silkscreen001
V3 Connector Only_silkscreen002
V3 Connector Only_silkscreen003
V3 Connector Only_silkscreen004
V3 Connector Only_silkscreen005
V3 Connector Only_silkscreen006
V3 Connector Only_silkscreen007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
