jeshernandez/PiTrac/3D Printed Parts/Enclosure Version 3/Part/Calibration Rig/X Axis Near Leg.step

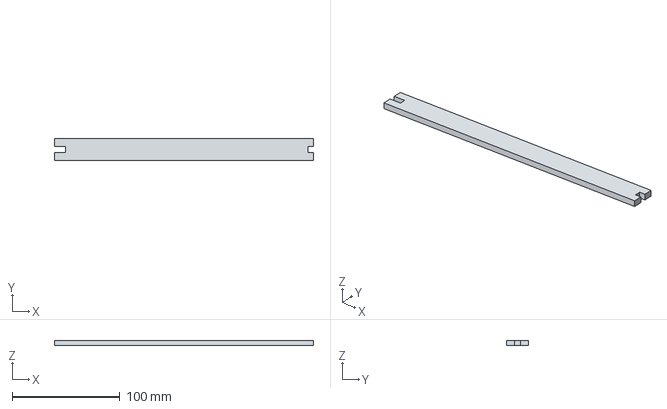
[picture p79: CAD file, 2026-04-10]
3D Printed Parts/Enclosure Version 3/Part/Calibration Rig/X Axis Near Leg.step
240.0 x 20.0 x 5.00 mm
