jeshernandez/PiTrac/3D Printed Parts/Enclosure Version 3/Part/Misc/CalibrationRig.FCStd

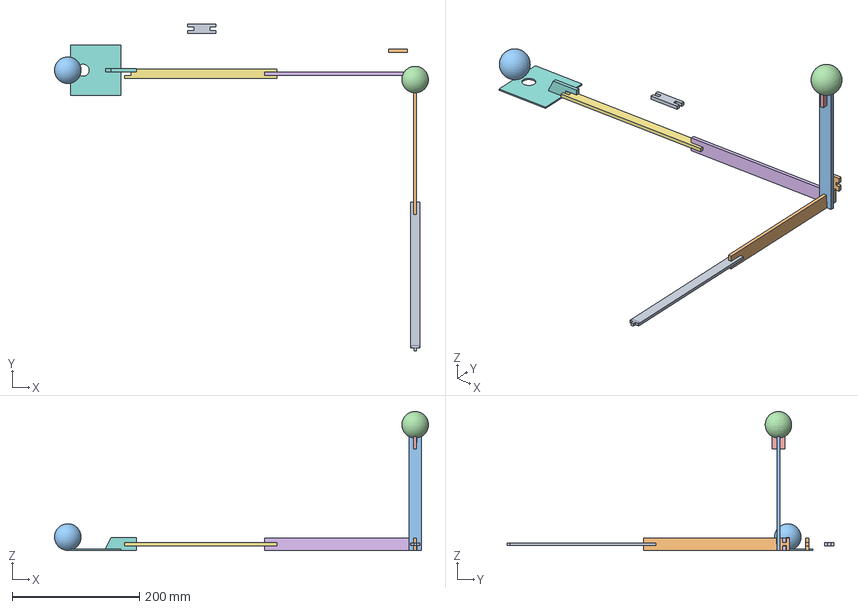
[picture p80: CAD file, 2026-04-10]
3D Printed Parts/Enclosure Version 3/Part/Misc/CalibrationRig.FCStd
588.7 x 514.5 x 218.9 mm
Base Connection Leg Body
Z-Axis Leg Body
High Ball Holder Body
Test Golf Ball 1
High Ball Holder Cross Body
X Axis Near Leg
X Axis Far Leg
X-Axis Ball Holder Body
X Axis Far Leg Short Version
X Axis Near Leg Short Version
Test Golf Ball 2
