jeshernandez/PiTrac/3D Printed Parts/Enclosure Version 3/Part/Print/LinePower_Cover.stp

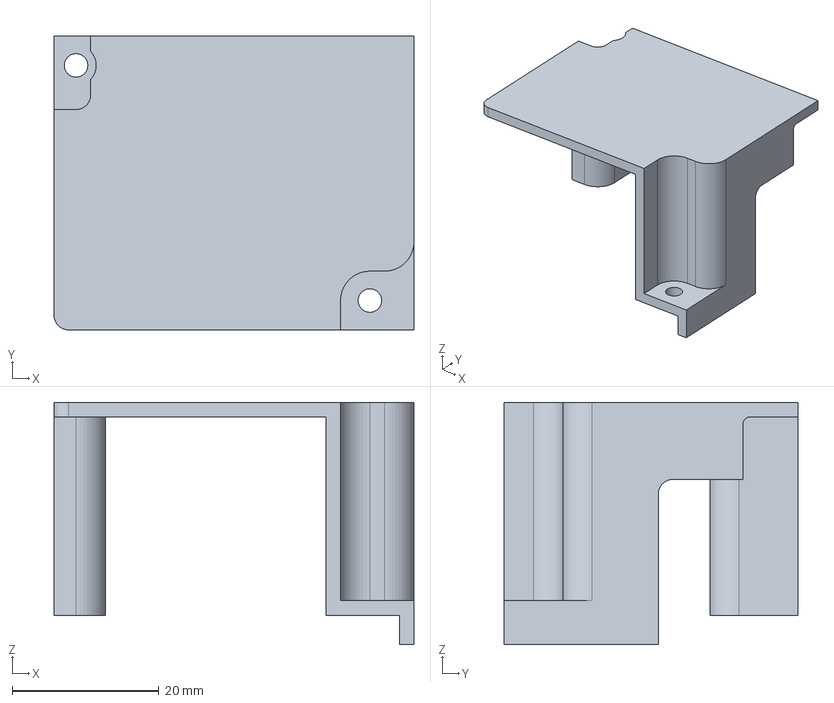
[picture p81: CAD file, 2026-04-10]
3D Printed Parts/Enclosure Version 3/Part/Print/LinePower_Cover.stp
49.0 x 40.0 x 33.0 mm
