jeshernandez/PiTrac/3D Printed Parts/Enclosure Version 3/Part/Print/Variants/IRFilter_Mount_1inchround.stp

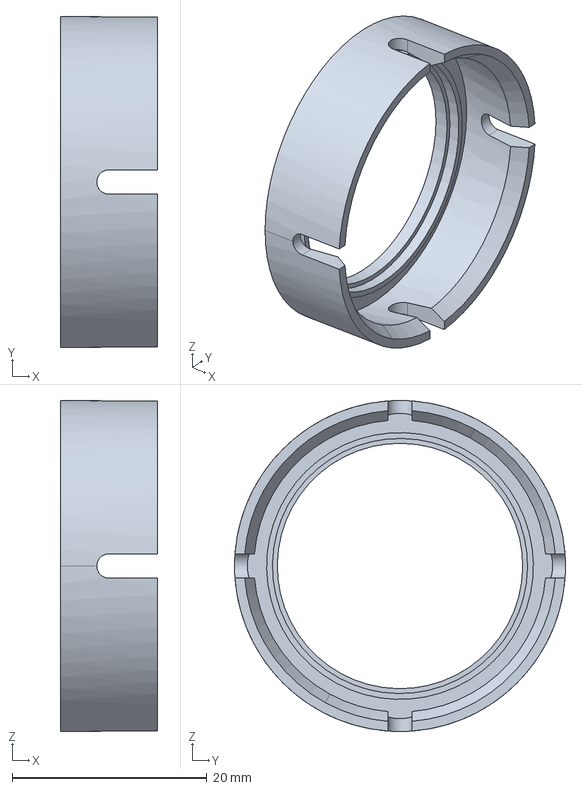
[picture p82: CAD file, 2026-04-10]
3D Printed Parts/Enclosure Version 3/Part/Print/Variants/IRFilter_Mount_1inchround.stp
10.0 x 34.0 x 34.0 mm
