jeshernandez/PiTrac/3D Printed Parts/Enclosure Version 3/Part/Purchase/IMX296 With CS.stp

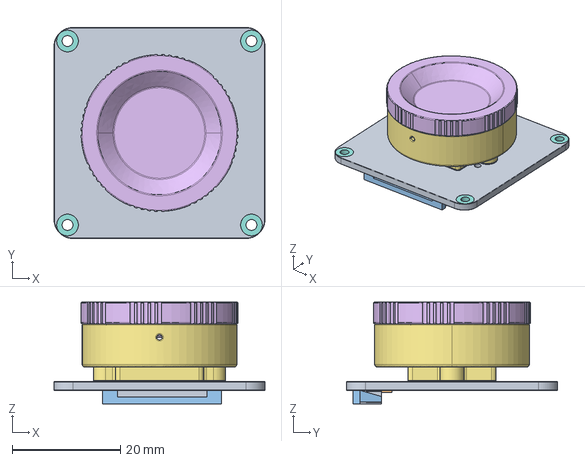
[picture p83: CAD file, 2026-04-10]
3D Printed Parts/Enclosure Version 3/Part/Purchase/IMX296 With CS.stp
39.0 x 39.0 x 18.8 mm
