jeshernandez/PiTrac/3D Printed Parts/Enclosure Version 3/Part/Calibration Rig/Base Connection Leg.step

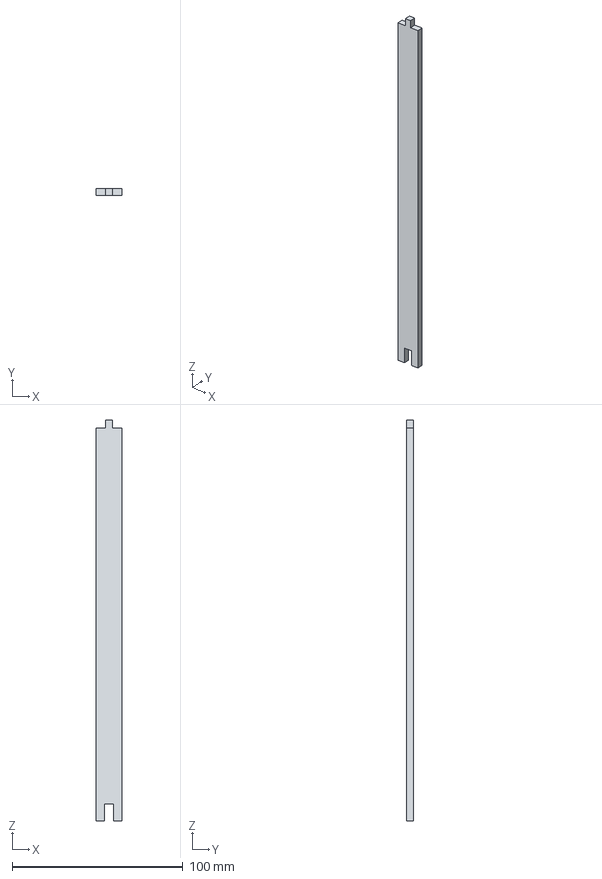
[picture p84: CAD file, 2026-04-10]
3D Printed Parts/Enclosure Version 3/Part/Calibration Rig/Base Connection Leg.step
15.0 x 4.00 x 234.8 mm
