jeshernandez/PiTrac/3D Printed Parts/Enclosure Version 3/Part/Print/5x2IRLED_Eyeball.step

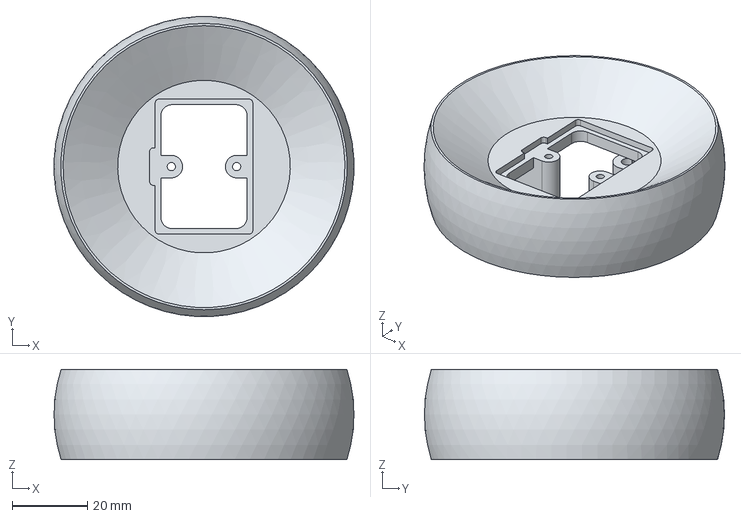
[picture p85: CAD file, 2026-04-10]
3D Printed Parts/Enclosure Version 3/Part/Print/5x2IRLED_Eyeball.step
79.9 x 79.9 x 24.0 mm
