jeshernandez/PiTrac/3D Printed Parts/Enclosure Version 3/Part/Print/Variants/Pi5_Carrier_vertical_0p2mmTroughHole.step

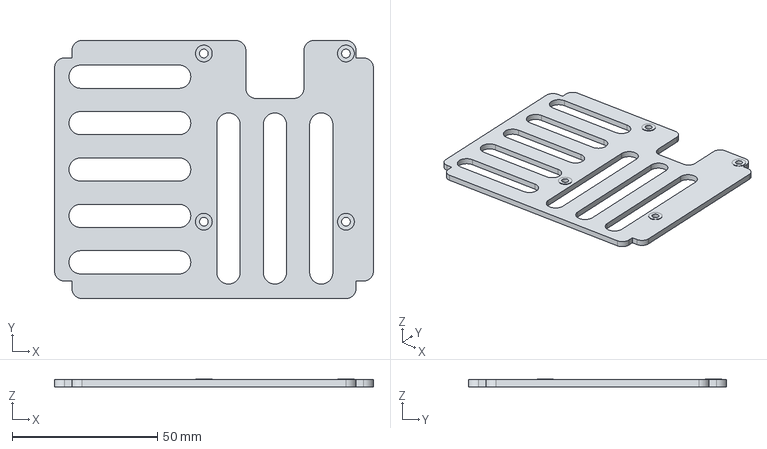
[picture p86: CAD file, 2026-04-10]
3D Printed Parts/Enclosure Version 3/Part/Print/Variants/Pi5_Carrier_vertical_0p2mmTroughHole.step
110.0 x 89.0 x 2.70 mm
