jeshernandez/PiTrac/3D Printed Parts/Enclosure Version 3/Part/Purchase/M5_rod.FCStd

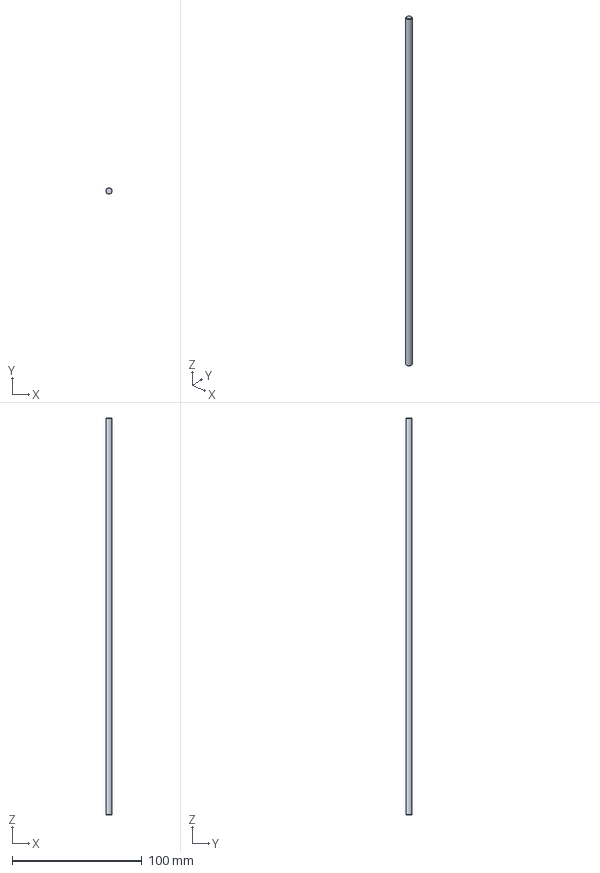
[picture p87: CAD file, 2026-04-10]
3D Printed Parts/Enclosure Version 3/Part/Purchase/M5_rod.FCStd
5.00 x 5.00 x 306.0 mm
