jeshernandez/PiTrac/3D Printed Parts/Enclosure Version 3/Part/Calibration Rig/High Ball Holder Cross.step

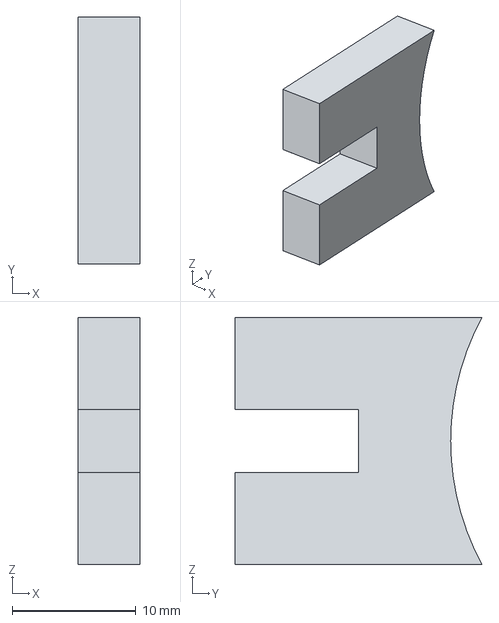
[picture p88: CAD file, 2026-04-10]
3D Printed Parts/Enclosure Version 3/Part/Calibration Rig/High Ball Holder Cross.step
5.00 x 20.0 x 20.0 mm
