jeshernandez/PiTrac/3D Printed Parts/Enclosure Version 3/Part/Print/Spacer.stp

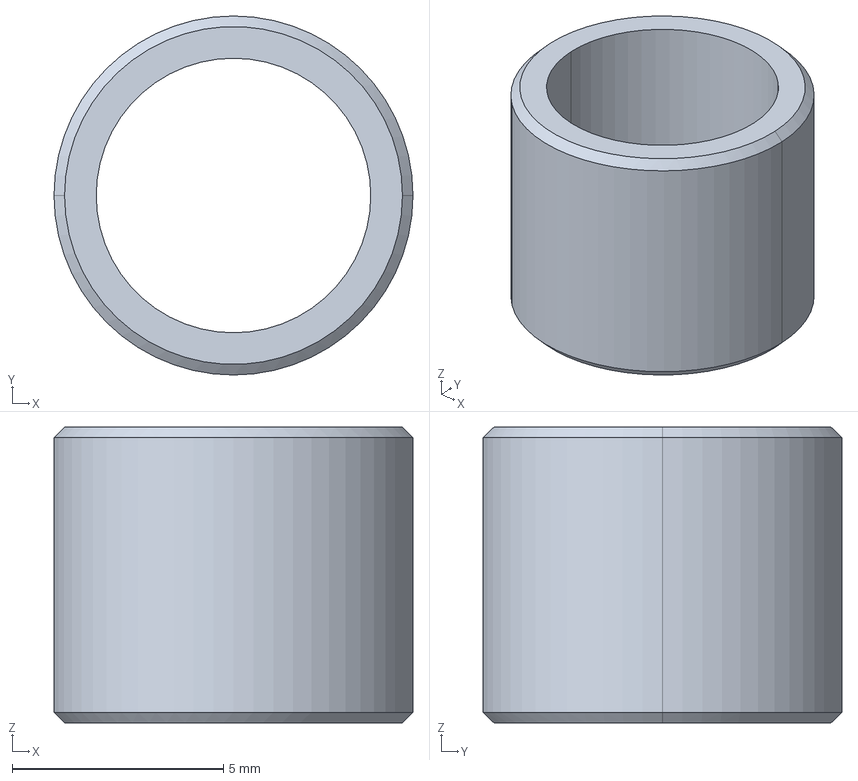
[picture p89: CAD file, 2026-04-10]
3D Printed Parts/Enclosure Version 3/Part/Print/Spacer.stp
8.50 x 8.50 x 7.00 mm
