jeshernandez/PiTrac/3D Printed Parts/Enclosure Version 3/Part/Print/Variants/Stack_Module_PSU.step

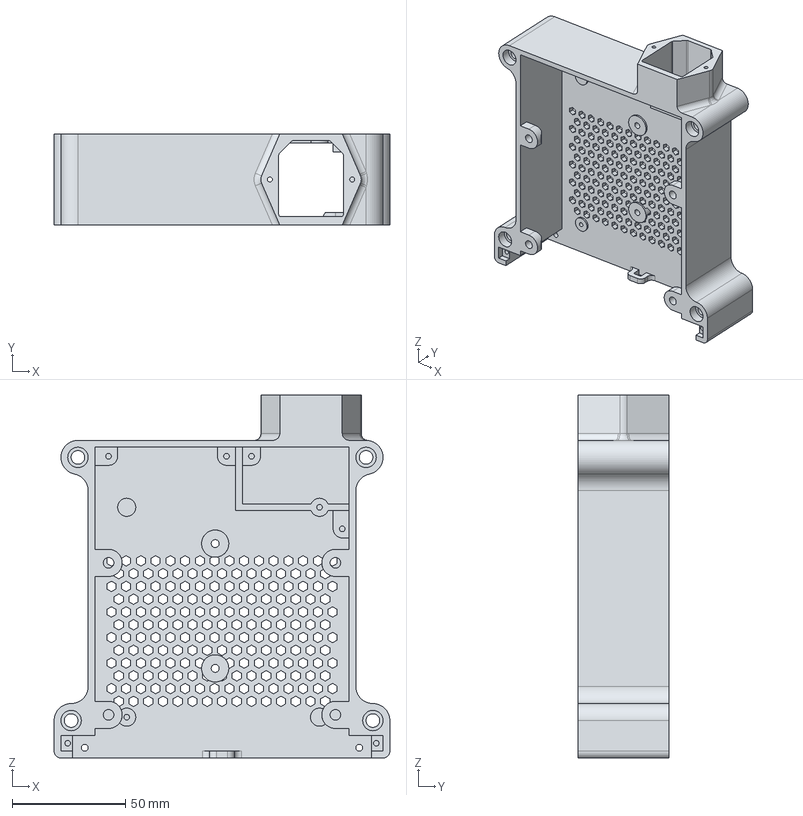
[picture p90: CAD file, 2026-04-10]
3D Printed Parts/Enclosure Version 3/Part/Print/Variants/Stack_Module_PSU.step
148.0 x 40.3 x 160.0 mm
