jeshernandez/PiTrac/3D Printed Parts/Enclosure Version 3/Part/Purchase/IRLED Only.step

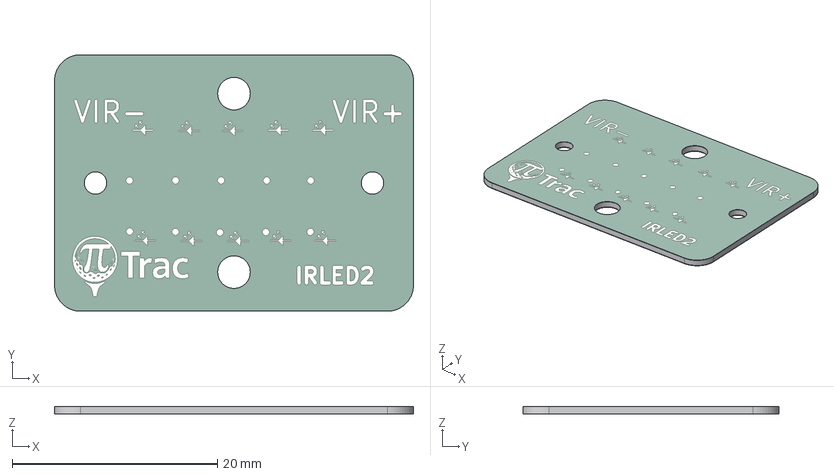
[picture p91: CAD file, 2026-04-10]
3D Printed Parts/Enclosure Version 3/Part/Purchase/IRLED Only.step
35.0 x 25.0 x 0.837 mm
IRLED Only_silkscreen
IRLED Only_soldermask x 2
IRLED Only_PCB
