jeshernandez/PiTrac/3D Printed Parts/Enclosure Version 3/Part/Calibration Rig/X Axis Far Leg Short Version.step

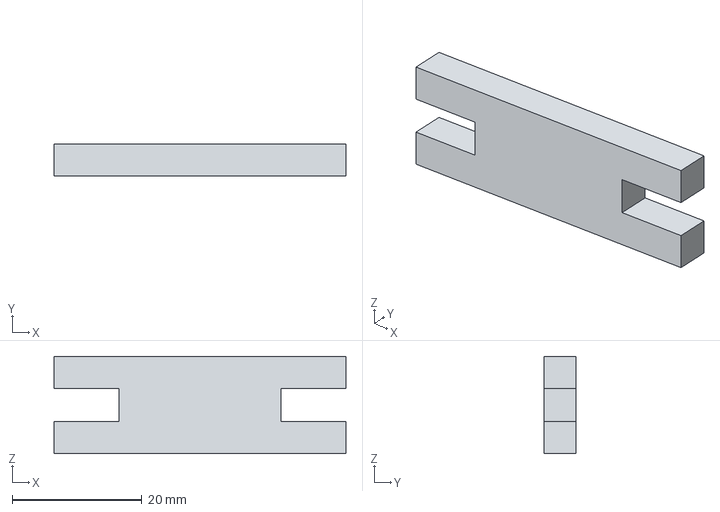
[picture p92: CAD file, 2026-04-10]
3D Printed Parts/Enclosure Version 3/Part/Calibration Rig/X Axis Far Leg Short Version.step
45.0 x 5.00 x 15.0 mm
