jeshernandez/PiTrac/3D Printed Parts/Enclosure Version 3/Part/Print/EyeScreen_Clamp.stp

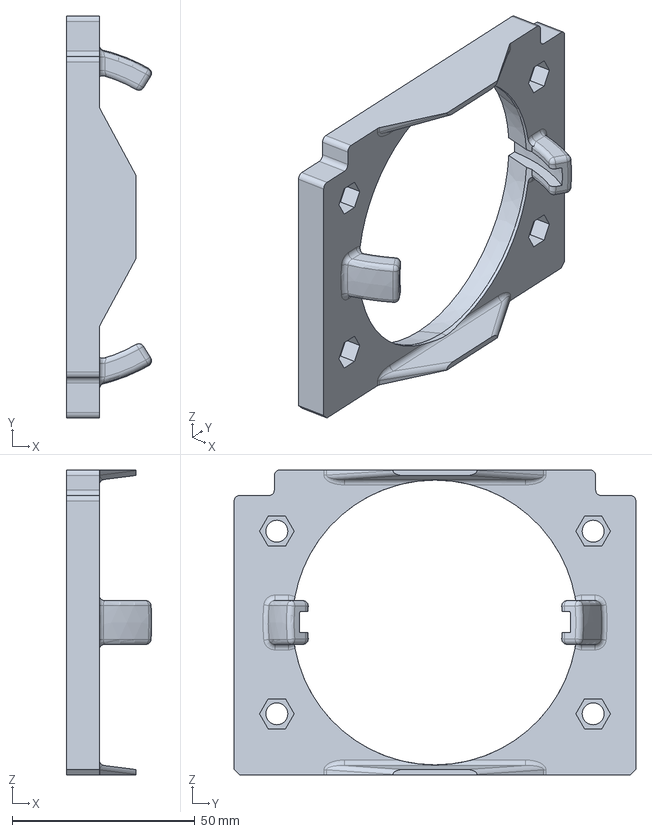
[picture p93: CAD file, 2026-04-10]
3D Printed Parts/Enclosure Version 3/Part/Print/EyeScreen_Clamp.stp
23.3 x 110.0 x 83.5 mm
