jeshernandez/PiTrac/3D Printed Parts/Enclosure Version 3/Part/Print/Variants/Pi5_Bagpack_bottom.step

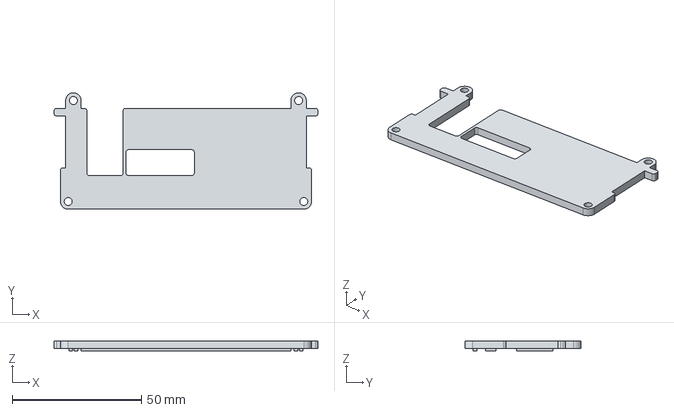
[picture p94: CAD file, 2026-04-10]
3D Printed Parts/Enclosure Version 3/Part/Print/Variants/Pi5_Bagpack_bottom.step
102.0 x 45.0 x 4.00 mm
