jeshernandez/PiTrac/3D Printed Parts/Enclosure Version 3/Part/Calibration Rig/X-Axis Ball Holder.step

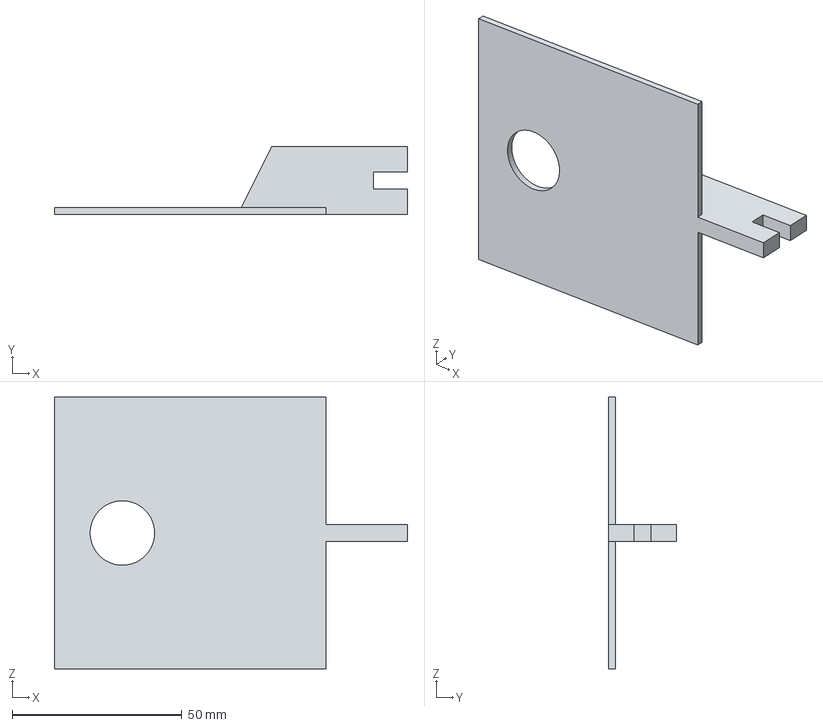
[picture p95: CAD file, 2026-04-10]
3D Printed Parts/Enclosure Version 3/Part/Calibration Rig/X-Axis Ball Holder.step
104.0 x 20.0 x 80.0 mm
