jeshernandez/PiTrac/3D Printed Parts/Enclosure Version 3/Part/Print/Variants/IMX296-MPI_Eyeball_6mm.stp

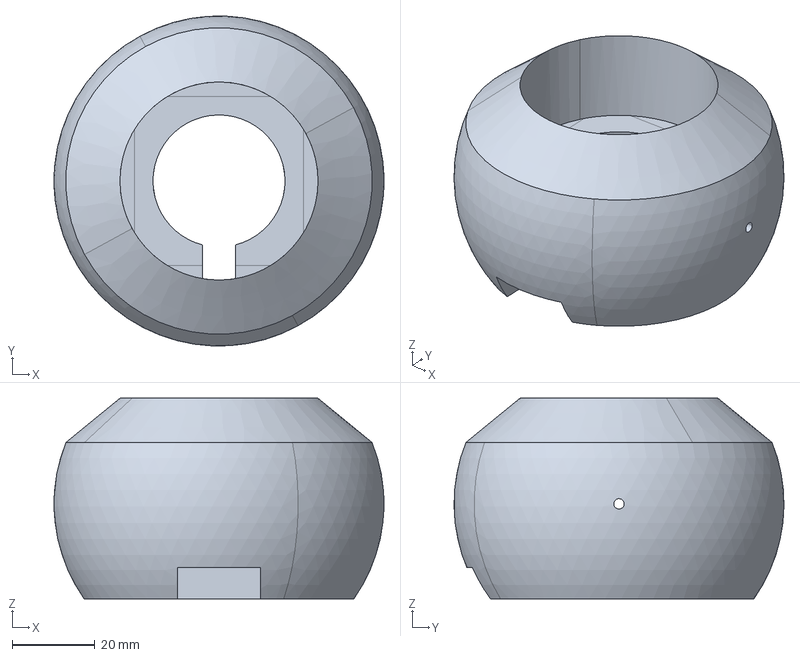
[picture p96: CAD file, 2026-04-10]
3D Printed Parts/Enclosure Version 3/Part/Print/Variants/IMX296-MPI_Eyeball_6mm.stp
80.0 x 79.9 x 48.6 mm
