jeshernandez/PiTrac/3D Printed Parts/Enclosure Version 3/Part/Calibration Rig/X Axis Near Leg Short Version.step

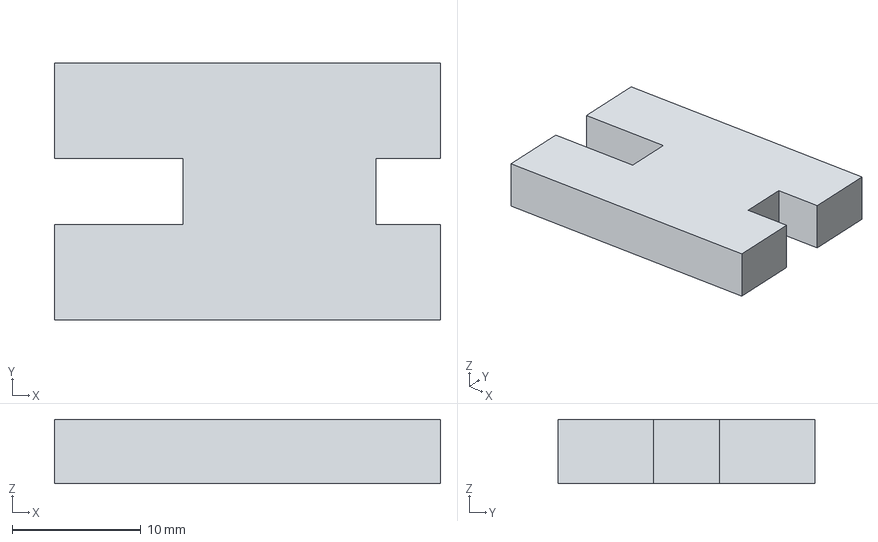
[picture p97: CAD file, 2026-04-10]
3D Printed Parts/Enclosure Version 3/Part/Calibration Rig/X Axis Near Leg Short Version.step
30.0 x 20.0 x 5.00 mm
