jeshernandez/PiTrac/3D Printed Parts/Enclosure Version 3/Part/Print/Stack_Module_Cover_insert.step

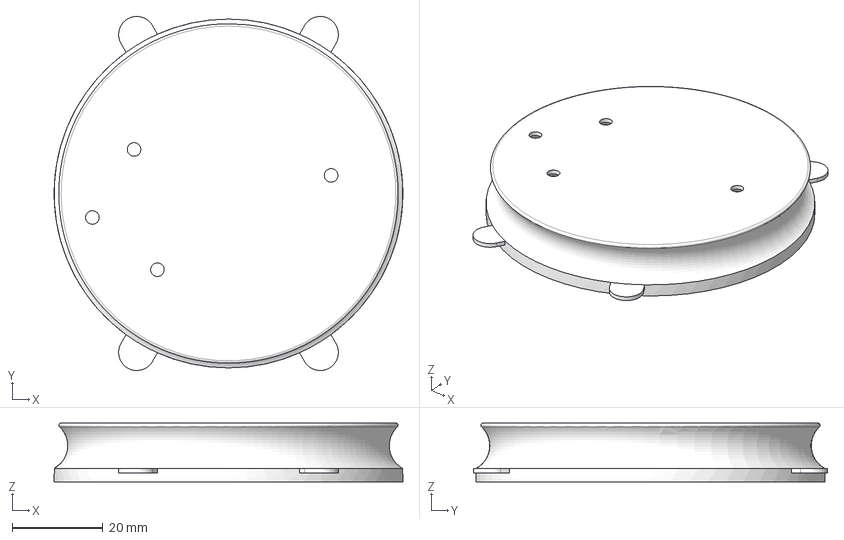
[picture p98: CAD file, 2026-04-10]
3D Printed Parts/Enclosure Version 3/Part/Print/Stack_Module_Cover_insert.step
77.0 x 78.1 x 13.0 mm
