jeshernandez/PiTrac/3D Printed Parts/Enclosure Version 3/Part/Print/Variants/Stack_Module_Cover_light.step

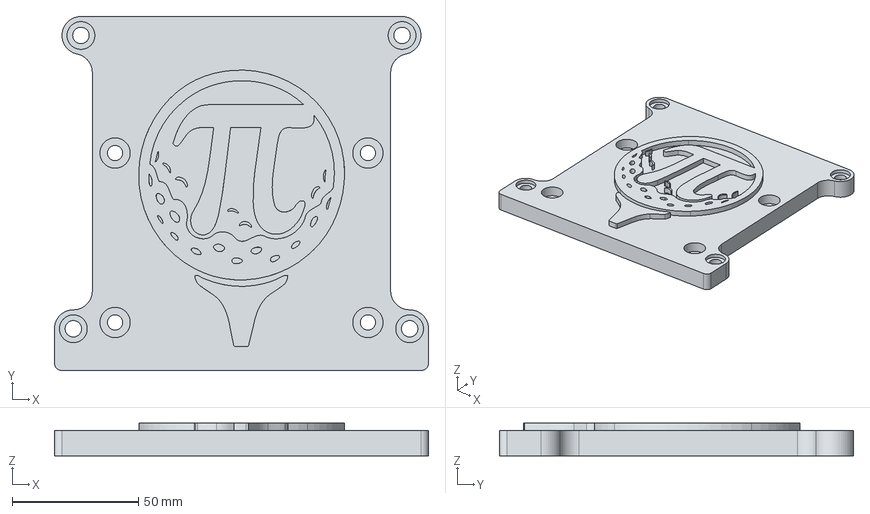
[picture p99: CAD file, 2026-04-10]
3D Printed Parts/Enclosure Version 3/Part/Print/Variants/Stack_Module_Cover_light.step
148.0 x 140.0 x 13.0 mm
