jeshernandez/PiTrac/3D Printed Parts/Enclosure Version 3/Part/Calibration Rig/High Ball Holder.step

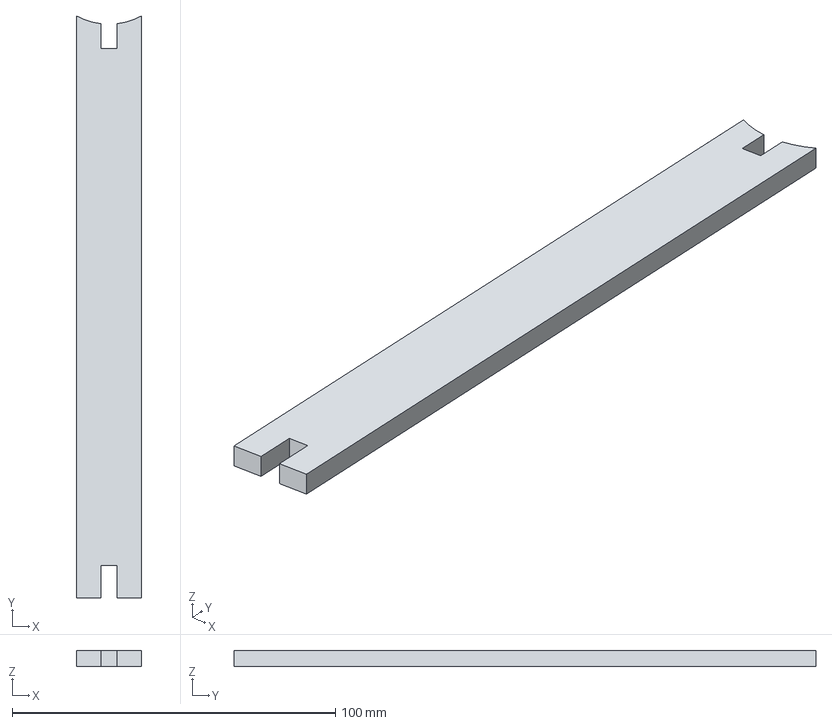
[picture p100: CAD file, 2026-04-10]
3D Printed Parts/Enclosure Version 3/Part/Calibration Rig/High Ball Holder.step
20.0 x 180.0 x 5.00 mm
