jeshernandez/PiTrac/3D Printed Parts/Enclosure Version 3/Part/Print/Stack_Module.stp

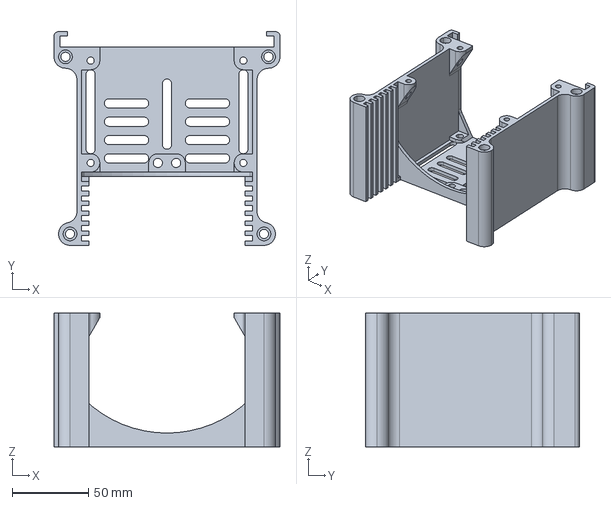
[picture p101: CAD file, 2026-04-10]
3D Printed Parts/Enclosure Version 3/Part/Print/Stack_Module.stp
148.0 x 140.0 x 87.5 mm
