jeshernandez/PiTrac/3D Printed Parts/Enclosure Version 3/Part/Print/Variants/pan-tilt_Innomaker-mount-6mm.step

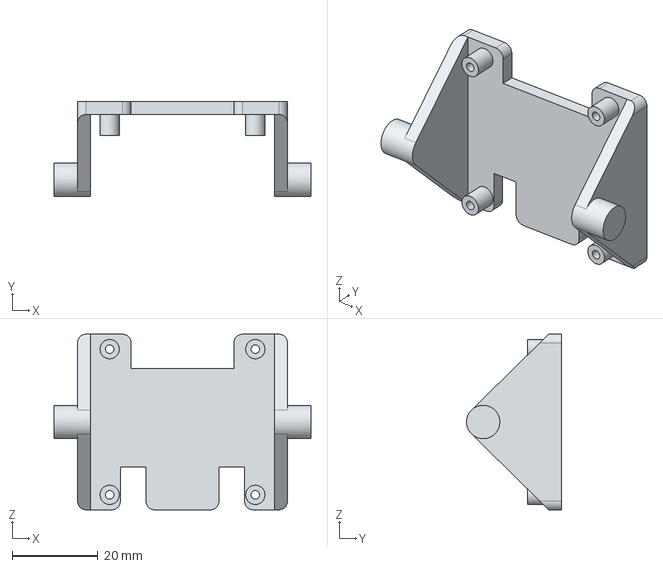
[picture p102: CAD file, 2026-04-10]
3D Printed Parts/Enclosure Version 3/Part/Print/Variants/pan-tilt_Innomaker-mount-6mm.step
60.0 x 22.2 x 41.0 mm
