jeshernandez/PiTrac/3D Printed Parts/Enclosure Version 3/Part/Purchase/Lens_PT361060M3MP12.FCStd

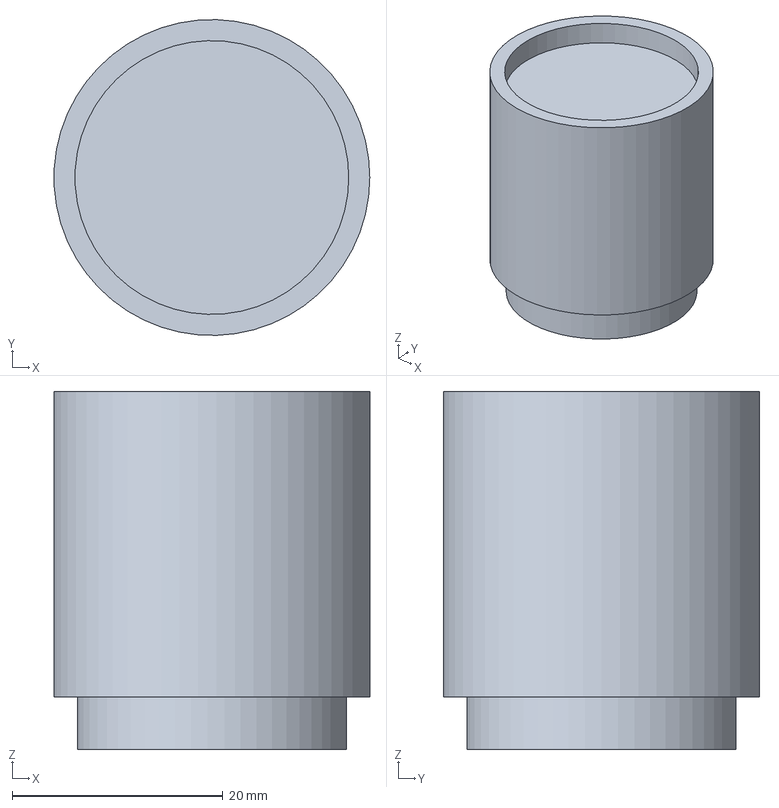
[picture p103: CAD file, 2026-04-10]
3D Printed Parts/Enclosure Version 3/Part/Purchase/Lens_PT361060M3MP12.FCStd
30.0 x 30.0 x 34.0 mm
