jeshernandez/PiTrac/3D Printed Parts/Enclosure Version 3/Part/Print/Carrier_Clamp.FCStd

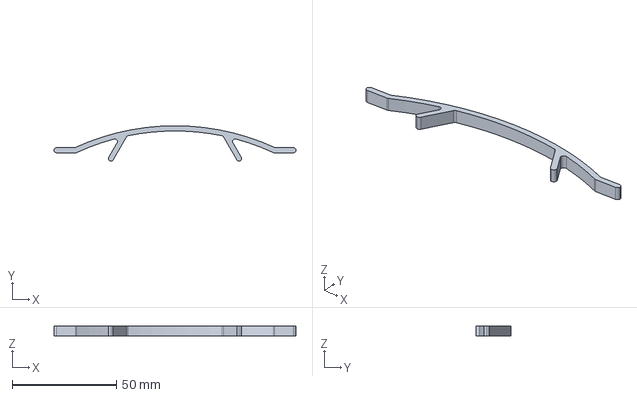
[picture p104: CAD file, 2026-04-10]
3D Printed Parts/Enclosure Version 3/Part/Print/Carrier_Clamp.FCStd
116.0 x 17.0 x 5.00 mm
