jeshernandez/PiTrac/3D Printed Parts/Enclosure Version 3/Part/Print/Variants/Stack_Module_Cover.step

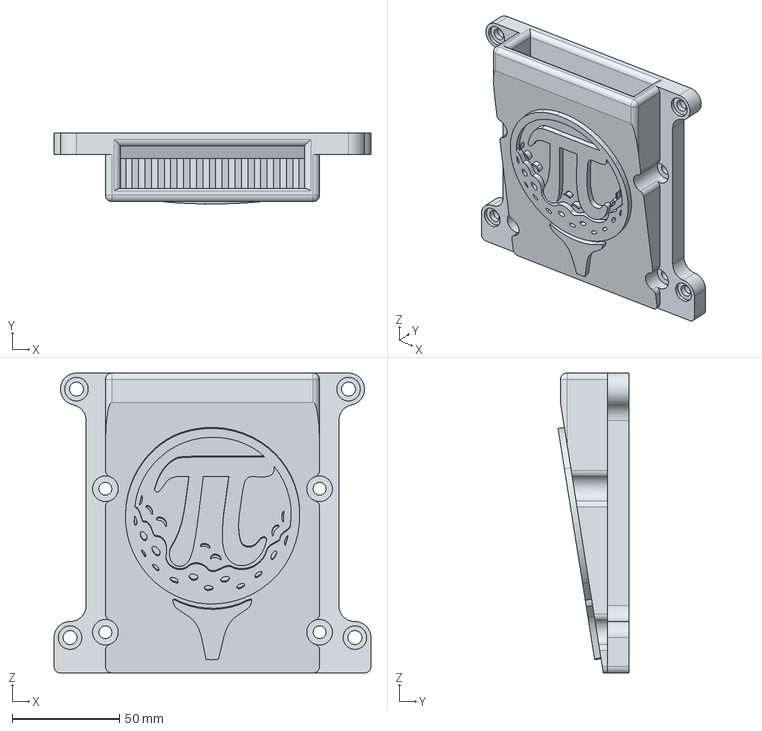
[picture p105: CAD file, 2026-04-10]
3D Printed Parts/Enclosure Version 3/Part/Print/Variants/Stack_Module_Cover.step
148.0 x 33.1 x 140.0 mm
