jeshernandez/PiTrac/3D Printed Parts/Enclosure Version 3/Part/Purchase/Acrylic_Backplate.FCStd

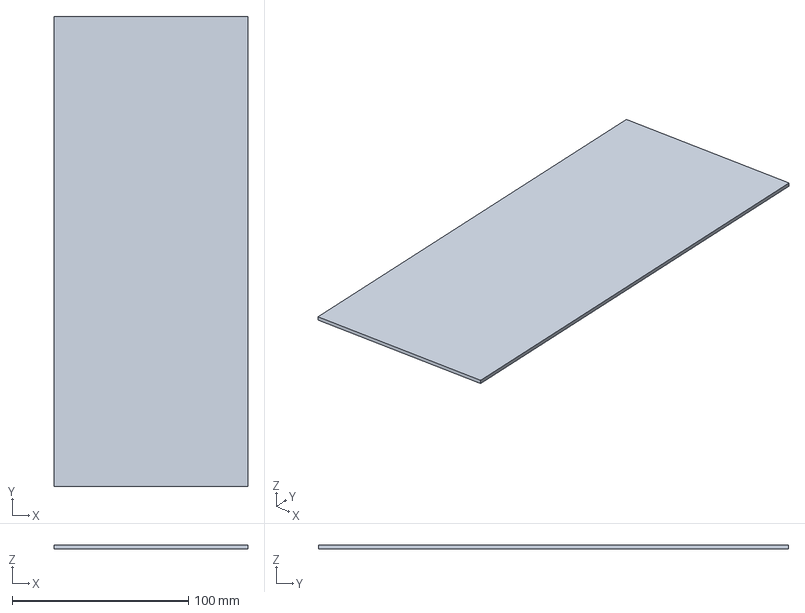
[picture p106: CAD file, 2026-04-10]
3D Printed Parts/Enclosure Version 3/Part/Purchase/Acrylic_Backplate.FCStd
110.0 x 267.0 x 2.00 mm
