jeshernandez/PiTrac/3D Printed Parts/Enclosure Version 3/Part/Print/Ambient_LED_Visor.step

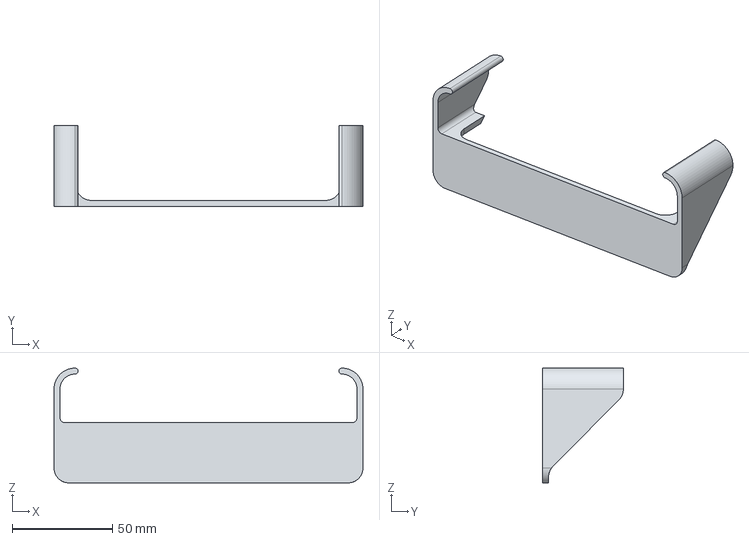
[picture p107: CAD file, 2026-04-10]
3D Printed Parts/Enclosure Version 3/Part/Print/Ambient_LED_Visor.step
154.0 x 40.3 x 57.2 mm
