jeshernandez/PiTrac/3D Printed Parts/Enclosure Version 3/Part/Print/Variants/Pi5_Bagpack.step

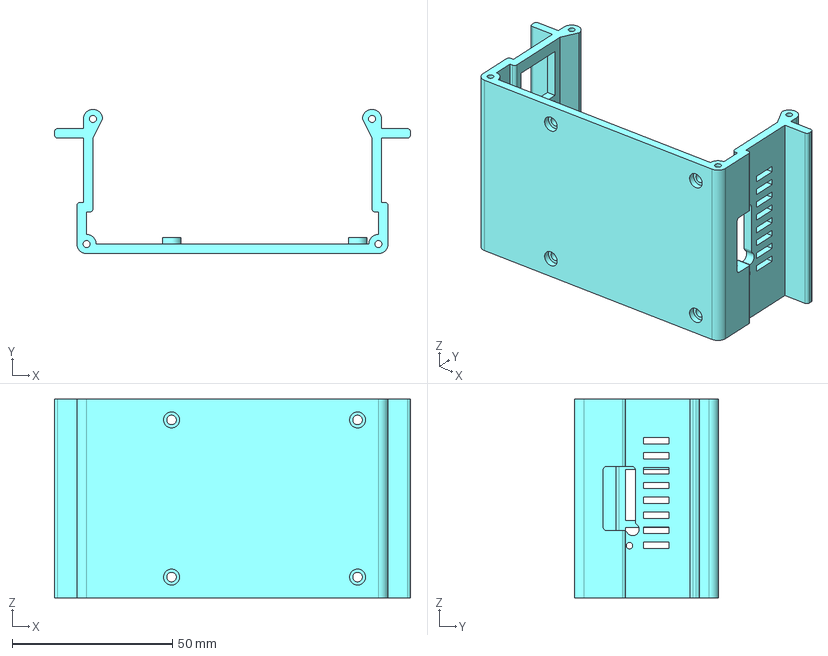
[picture p108: CAD file, 2026-04-10]
3D Printed Parts/Enclosure Version 3/Part/Print/Variants/Pi5_Bagpack.step
111.0 x 45.0 x 62.0 mm
