jeshernandez/PiTrac/3D Printed Parts/Enclosure Version 3/Part/Print/Stack_Module_Cover_forInserts.step

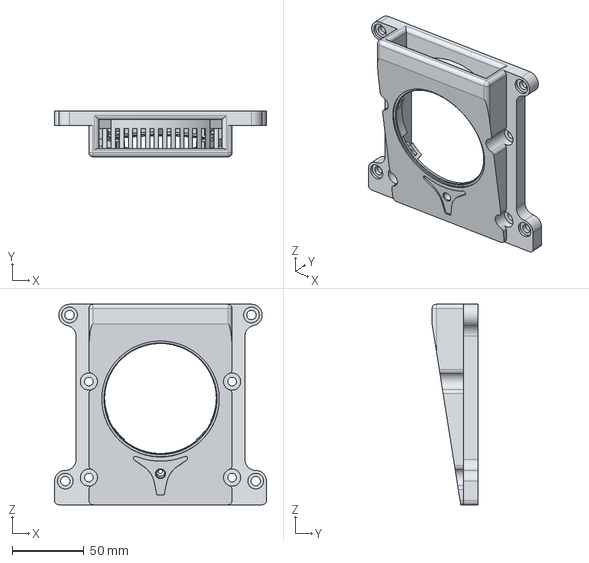
[picture p109: CAD file, 2026-04-10]
3D Printed Parts/Enclosure Version 3/Part/Print/Stack_Module_Cover_forInserts.step
148.0 x 32.0 x 140.0 mm
