jeshernandez/PiTrac/3D Printed Parts/Enclosure Version 3/Part/Purchase/Shank_Shield.FCStd

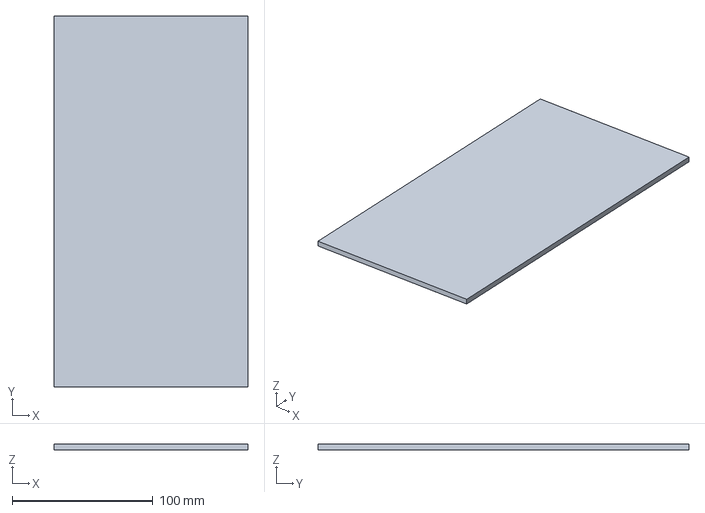
[picture p110: CAD file, 2026-04-10]
3D Printed Parts/Enclosure Version 3/Part/Purchase/Shank_Shield.FCStd
138.0 x 264.0 x 4.00 mm
