jeshernandez/PiTrac/3D Printed Parts/Enclosure Version 3/Part/Print/Foot.stp

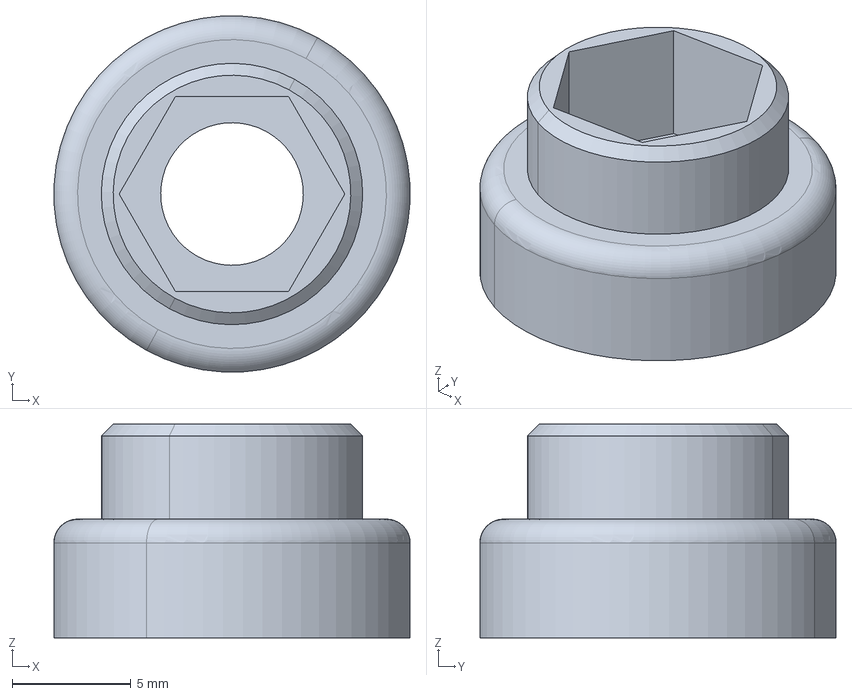
[picture p111: CAD file, 2026-04-10]
3D Printed Parts/Enclosure Version 3/Part/Print/Foot.stp
15.0 x 15.0 x 9.00 mm
