jeshernandez/PiTrac/3D Printed Parts/Enclosure Version 3/Part/Print/Variants/Pi5_Carrier_3mmTroughHole.stp

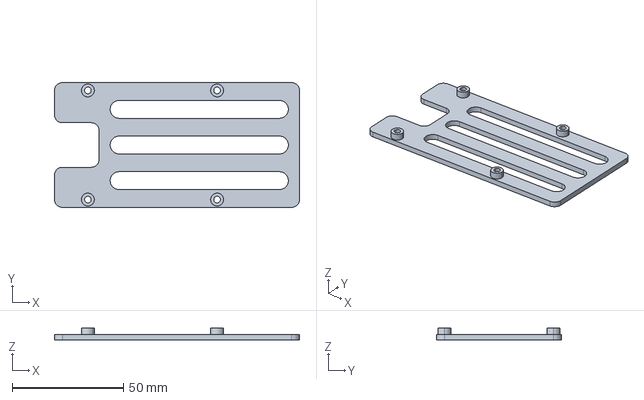
[picture p112: CAD file, 2026-04-10]
3D Printed Parts/Enclosure Version 3/Part/Print/Variants/Pi5_Carrier_3mmTroughHole.stp
110.0 x 56.0 x 5.50 mm
