jeshernandez/PiTrac/3D Printed Parts/Enclosure Version 3/Part/Print/Stack_Module_Cover_LogoBall.step

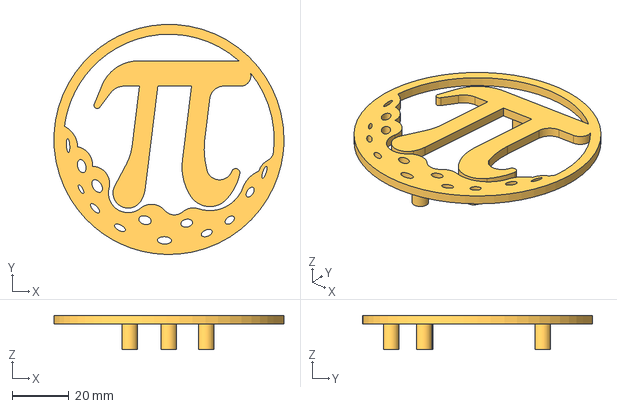
[picture p113: CAD file, 2026-04-10]
3D Printed Parts/Enclosure Version 3/Part/Print/Stack_Module_Cover_LogoBall.step
81.1 x 81.1 x 12.0 mm
