jeshernandez/PiTrac/3D Printed Parts/Enclosure Version 3/Part/Print/Variants/pan-tilt_Innomaker-mount-2p8mm.step

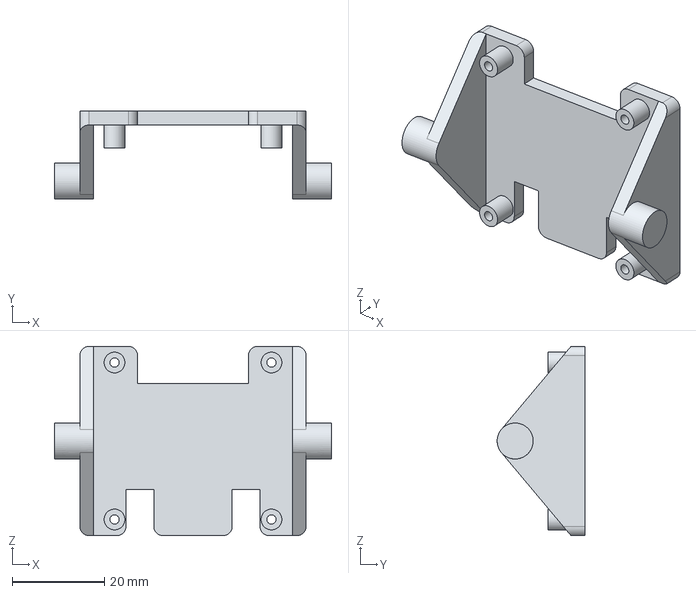
[picture p114: CAD file, 2026-04-10]
3D Printed Parts/Enclosure Version 3/Part/Print/Variants/pan-tilt_Innomaker-mount-2p8mm.step
60.0 x 19.0 x 41.0 mm
