jeshernandez/PiTrac/3D Printed Parts/Enclosure Version 3/Part/Print/Pi5_Carrier_vertical_3mm.step

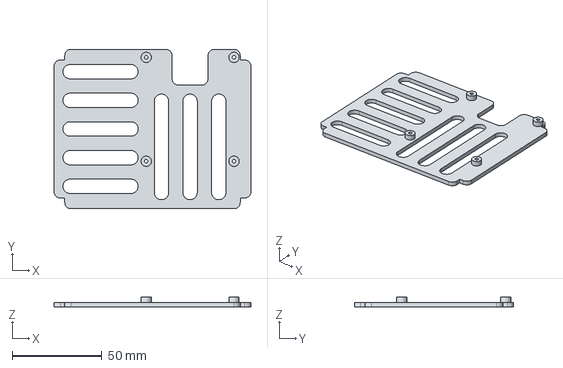
[picture p115: CAD file, 2026-04-10]
3D Printed Parts/Enclosure Version 3/Part/Print/Pi5_Carrier_vertical_3mm.step
110.0 x 89.0 x 5.50 mm
