jeshernandez/PiTrac/3D Printed Parts/Enclosure Version 3/Part/Print/Variants/pan-tilt_base.step

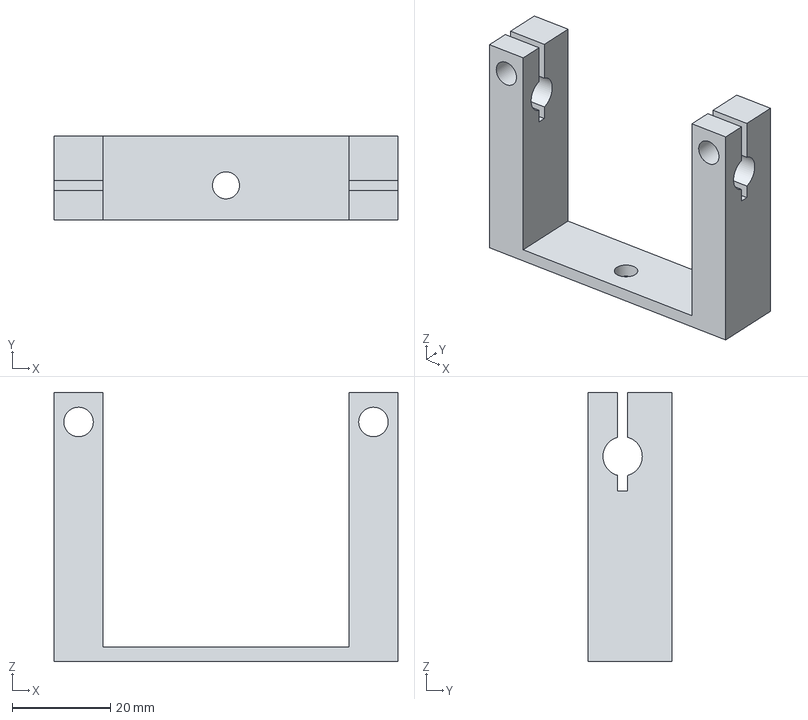
[picture p116: CAD file, 2026-04-10]
3D Printed Parts/Enclosure Version 3/Part/Print/Variants/pan-tilt_base.step
70.0 x 17.0 x 54.8 mm
