jeshernandez/PiTrac/3D Printed Parts/Enclosure Version 3/Part/Print/EyeScreen.stp

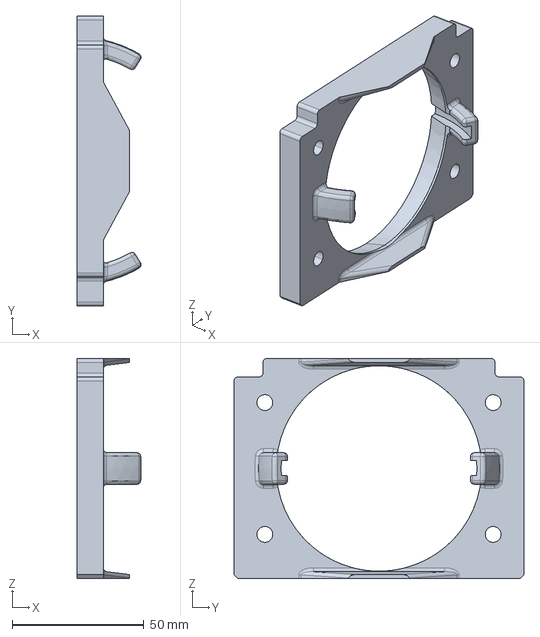
[picture p117: CAD file, 2026-04-10]
3D Printed Parts/Enclosure Version 3/Part/Print/EyeScreen.stp
24.3 x 110.0 x 83.5 mm
