jeshernandez/PiTrac/3D Printed Parts/Enclosure Version 3/Part/Print/ConnectorBoardv3_Carrier.step

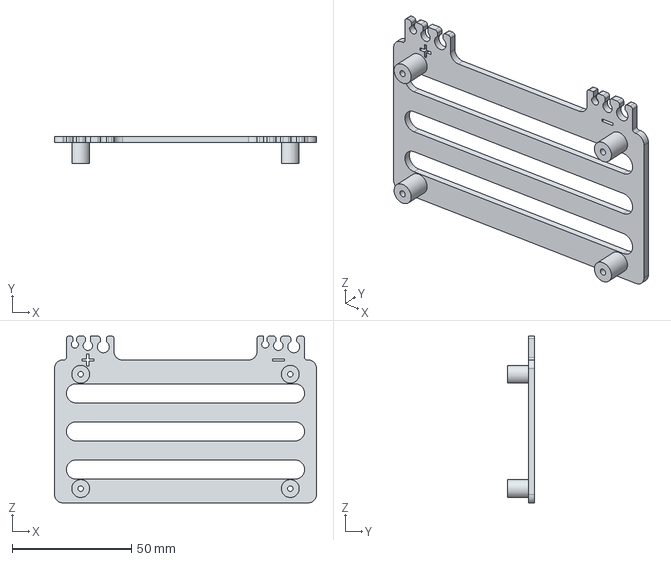
[picture p118: CAD file, 2026-04-10]
3D Printed Parts/Enclosure Version 3/Part/Print/ConnectorBoardv3_Carrier.step
110.0 x 11.5 x 70.0 mm
