jeshernandez/PiTrac/3D Printed Parts/Enclosure Version 3/Part/Print/Variants/Back_Interface_Plate.step

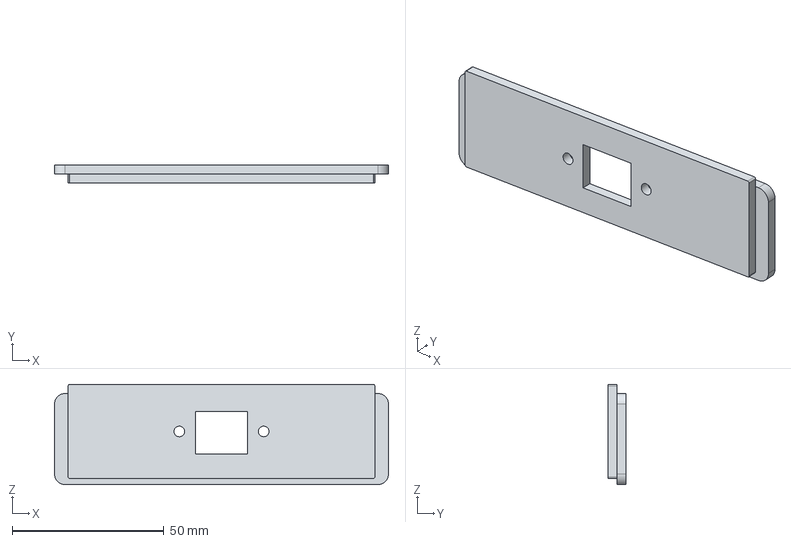
[picture p119: CAD file, 2026-04-10]
3D Printed Parts/Enclosure Version 3/Part/Print/Variants/Back_Interface_Plate.step
110.0 x 6.00 x 33.0 mm
