jeshernandez/PiTrac/3D Printed Parts/Enclosure Version 3/Part/Print/Ambient_LED_Screen.stp

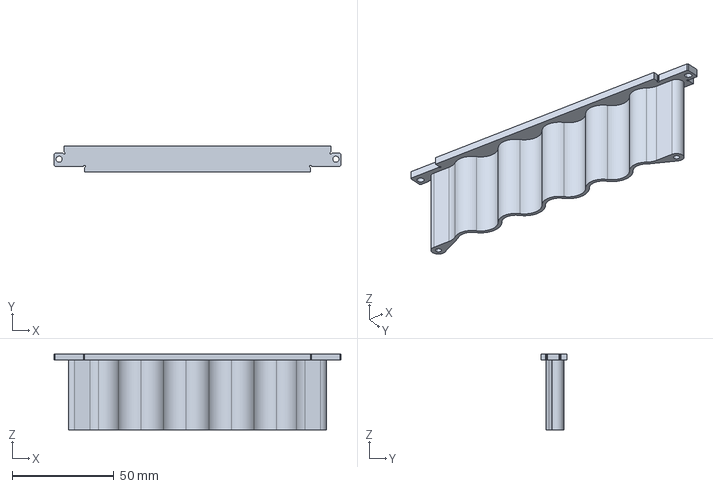
[picture p120: CAD file, 2026-04-10]
3D Printed Parts/Enclosure Version 3/Part/Print/Ambient_LED_Screen.stp
141.0 x 12.8 x 37.2 mm
