jeshernandez/PiTrac/3D Printed Parts/Enclosure Version 3/Part/Print/Variants/Back_Interface_Plate_Type_D_Bulkhead.step

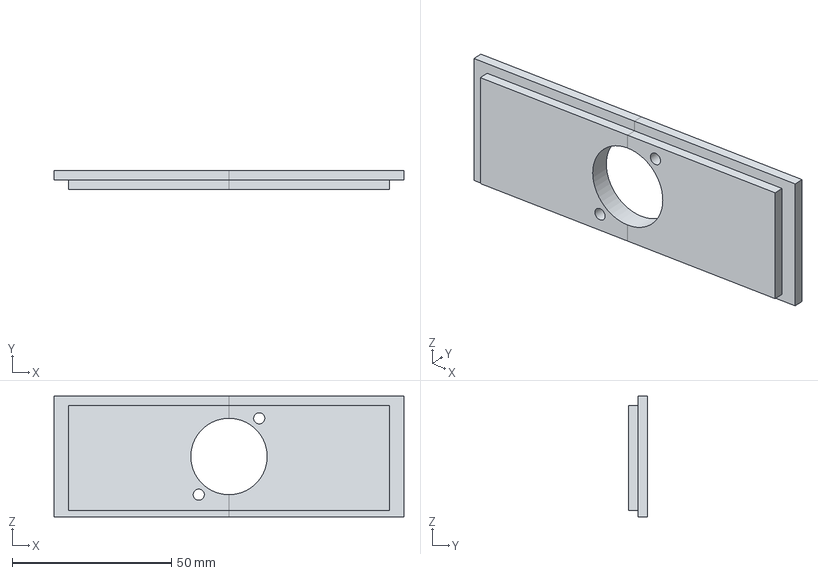
[picture p121: CAD file, 2026-04-10]
3D Printed Parts/Enclosure Version 3/Part/Print/Variants/Back_Interface_Plate_Type_D_Bulkhead.step
110.0 x 6.00 x 38.0 mm
