jeshernandez/PiTrac/3D Printed Parts/Enclosure Version 3/Part/Print/Stack_Module_Cover_LogoTee.step

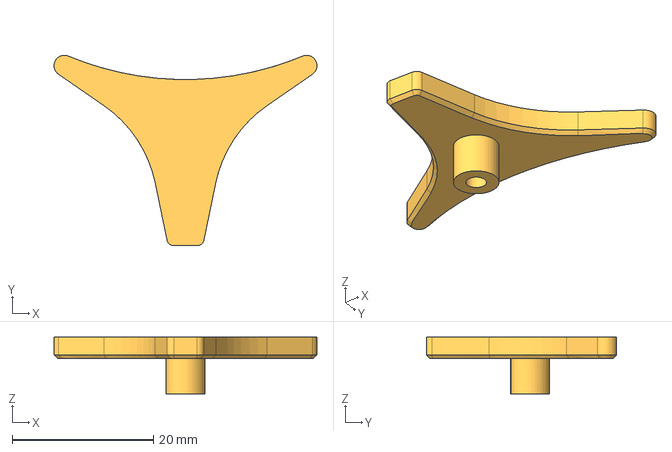
[picture p122: CAD file, 2026-04-10]
3D Printed Parts/Enclosure Version 3/Part/Print/Stack_Module_Cover_LogoTee.step
37.2 x 26.9 x 8.00 mm
