jeshernandez/PiTrac/3D Printed Parts/Enclosure Version 3/Part/Print/Variants/pan-tilt_LED-mount.step

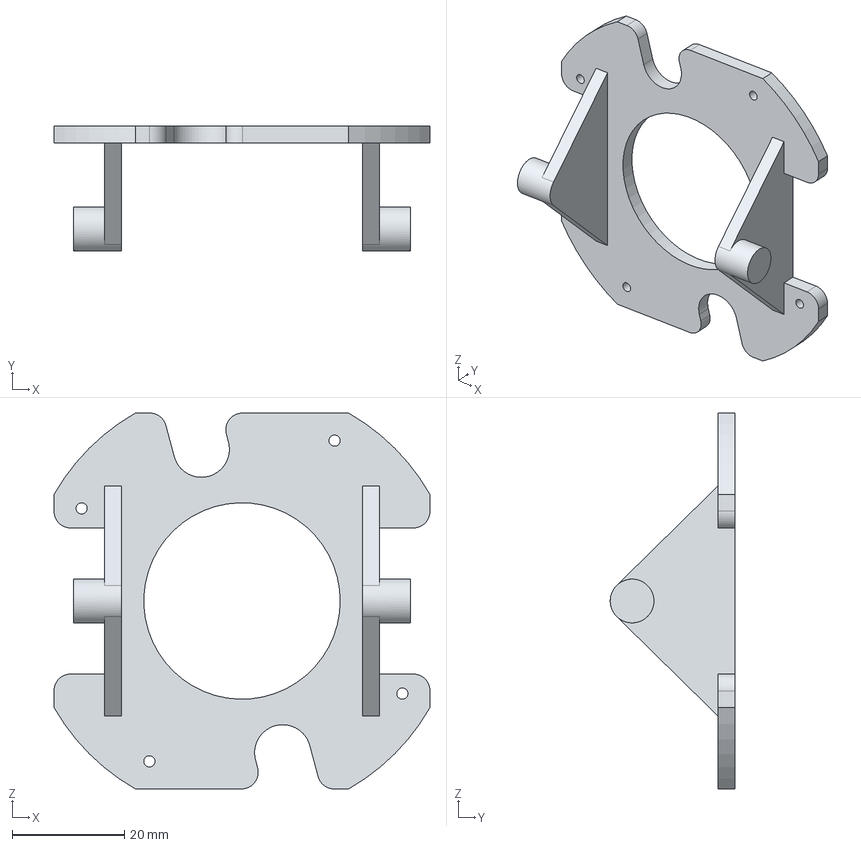
[picture p123: CAD file, 2026-04-10]
3D Printed Parts/Enclosure Version 3/Part/Print/Variants/pan-tilt_LED-mount.step
67.0 x 22.2 x 67.0 mm
