jeshernandez/PiTrac/(list of files, cad)

Other CAD files:
3D Printed Parts/Enclosure Version 3/Assembly/Assembly4/Assy_Stack_Module_Tee_Cam.FCStd
3D Printed Parts/Enclosure Version 3/Assembly/Assembly_Tee-Cam-Screen.FCStd
3D Printed Parts/Enclosure Version 3/Assembly/Assembly_Stack_Module_Cover_twoInserts.FCStd
3D Printed Parts/Enclosure Version 3/Assembly/Assembly4/Assy_IMX296.FCStd
3D Printed Parts/Enclosure Version 3/Assembly/Assembly_Flight-Cam-Stack.FCStd
3D Printed Parts/Enclosure Version 3/Assembly/Assembly4/Assy_Flight_Cam.FCStd
3D Printed Parts/Enclosure Version 3/Assembly/Assembly_Stack_Module_Cover_insert.FCStd
3D Printed Parts/Enclosure Version 3/Assembly/Assembly_Tee-Cam-Stack.FCStd
3D Printed Parts/Enclosure Version 3/Assembly/Assembly_Flight-Cam-Screen.FCStd
3D Printed Parts/Enclosure Version 3/Assembly/Assembly_PSU-Stack.FCStd
3D Printed Parts/Enclosure Version 3/Assembly/Assembly4/Assy_Tee_Cam.FCStd
3D Printed Parts/Enclosure Version 3/Assembly/Assembly_Flight-Cam.FCStd
3D Printed Parts/Enclosure Version 3/Assembly/Assembly4/Assy_Simulator_Mockup.FCStd
3D Printed Parts/Enclosure Version 3/Assembly/Assembly_pan-tilt_LED.FCStd
3D Printed Parts/Enclosure Version 3/Assembly/Assembly4/Assy_Screen_PiTracIRLED.FCStd
3D Printed Parts/Enclosure Version 3/Assembly/Assembly_Stack_Module_Cover_light_insert.FCStd
3D Printed Parts/Enclosure Version 3/Assembly/Assembly4/Assy_Stack_Module_Flight_Cam.FCStd
3D Printed Parts/Enclosure Version 3/Assembly/Assembly_LED.FCStd
3D Printed Parts/Enclosure Version 3/Assembly/Assembly4/Assy_Stack_Module_LED.FCStd
3D Printed Parts/Enclosure Version 3/Assembly/Assembly_LED-Screen.FCStd
3D Printed Parts/Enclosure Version 3/Assembly/Assembly_Tee-Cam.FCStd
3D Printed Parts/Enclosure Version 3/Assembly/Assembly4/Assy_PiTrac.FCStd
3D Printed Parts/Enclosure Version 3/Assembly/Assembly4/Assy_Calibration_Rig.FCStd
3D Printed Parts/Enclosure Version 3/Assembly/Assembly_Launch-Monitor.FCStd
3D Printed Parts/Enclosure Version 3/Assembly/Assembly_pan-tilt_Innomaker.FCStd
3D Printed Parts/Enclosure Version 3/Assembly/Assembly_LED-Stack.FCStd
3D Printed Parts/Enclosure Version 3/Part/Purchase/RaspberryPi5.FCStd
3D Printed Parts/Enclosure Version 3/Part/Print/Parameters.FCStd
3D Printed Parts/Enclosure Version 3/Part/Purchase/IRLED.FCStd
3D Printed Parts/Enclosure Version 3/Part/Purchase/LRS-75-3D.stp
3D Printed Parts/Enclosure Version 3/Part/Print/Variants/IMX296-MPI_Eyeball_2p8mm_camfered.step
3D Printed Parts/Enclosure Version 3/Part/Print/Variants/Pi5_Carrier_3mm.stp
3D Printed Parts/Enclosure Version 3/Part/Print/Variants/IMX296-MPI_Eyeball_2p8mm.step
3D Printed Parts/Enclosure Version 3/Part/Print/Carrier_Clamps.stp
3D Printed Parts/Enclosure Version 2/BaseBox/BaseBox- Light Shield Body.3mf
3D Printed Parts/Enclosure Version 2/BaseBox/BaseBox- Light Shield Body.stl
3D Printed Parts/Enclosure Version 2/BaseBox/BaseBox- Main Body.3mf
3D Printed Parts/Enclosure Version 2/BaseBox/BaseBox- Main Body.stl
3D Printed Parts/Enclosure Version 2/BaseBox/BaseBox-End Cap.3mf
3D Printed Parts/Enclosure Version 2/BaseBox/BaseBox-End Cap.stl
3D Printed Parts/Enclosure Version 2/BaseBox/BaseBox.FCStd
3D Printed Parts/Enclosure Version 2/BaseBox/C14 Panel Mount Power Plug Adapter w Fuse - JR-101-1F.FCStd
3D Printed Parts/Enclosure Version 2/BaseBox/Meanwell LRS-75.FCStd
3D Printed Parts/Enclosure Version 2/Integrated Enclosure (DO NOT PRINT)/LRS-150 Meanwell.FCStd
3D Printed Parts/Enclosure Version 2/Master Document.FCStd
3D Printed Parts/Enclosure Version 2/Tower-Single-Pi-V2-Connector-Board-Variant/ConnectorBoard_V2.FCStd
3D Printed Parts/Enclosure Version 2/Tower-Single-Pi-V2-Connector-Board-Variant/PiTrac Pi Connector.step
3D Printed Parts/Enclosure Version 2/Tower-Single-Pi-V2-Connector-Board-Variant/Tower-Backplate - Pieces Separated For Printing.stl
3D Printed Parts/Enclosure Version 2/Tower-Single-Pi-V2-Connector-Board-Variant/Tower-Backplate.3mf
3D Printed Parts/Enclosure Version 2/Tower-Single-Pi-V2-Connector-Board-Variant/Tower-Backplate.stl
3D Printed Parts/Enclosure Version 2/Tower-Single-Pi-V2-Connector-Board-Variant/Tower-Frontplate - Pieces Separated For Printing.stl
3D Printed Parts/Enclosure Version 2/Tower-Single-Pi-V2-Connector-Board-Variant/Tower-Frontplate.3mf
3D Printed Parts/Enclosure Version 2/Tower-Single-Pi-V2-Connector-Board-Variant/Tower-Frontplate.stl
3D Printed Parts/Enclosure Version 2/Tower-Single-Pi-V2-Connector-Board-Variant/Tower.FCStd
3D Printed Parts/Enclosure Version 2/Tower/Tower.FCStd
3D Printed Parts/Enclosure Version 3/Part/Calibration Rig/Base Connection Leg.FCStd
3D Printed Parts/Enclosure Version 3/Part/Calibration Rig/Base Connection Leg.stl
3D Printed Parts/Enclosure Version 3/Part/Calibration Rig/High Ball Holder Cross.FCStd
3D Printed Parts/Enclosure Version 3/Part/Calibration Rig/High Ball Holder Cross.stl
3D Printed Parts/Enclosure Version 3/Part/Calibration Rig/High Ball Holder.FCStd
3D Printed Parts/Enclosure Version 3/Part/Calibration Rig/High Ball Holder.stl
3D Printed Parts/Enclosure Version 3/Part/Calibration Rig/X Axis Far Leg Short Version.FCStd
3D Printed Parts/Enclosure Version 3/Part/Calibration Rig/X Axis Far Leg Short Version.stl
3D Printed Parts/Enclosure Version 3/Part/Calibration Rig/X Axis Far Leg.FCStd
3D Printed Parts/Enclosure Version 3/Part/Calibration Rig/X Axis Far Leg.stl
3D Printed Parts/Enclosure Version 3/Part/Calibration Rig/X Axis Near Leg Short Version.FCStd
3D Printed Parts/Enclosure Version 3/Part/Calibration Rig/X Axis Near Leg Short Version.stl
3D Printed Parts/Enclosure Version 3/Part/Calibration Rig/X Axis Near Leg.FCStd
3D Printed Parts/Enclosure Version 3/Part/Calibration Rig/X Axis Near Leg.stl
3D Printed Parts/Enclosure Version 3/Part/Calibration Rig/X-Axis Ball Holder.FCStd
3D Printed Parts/Enclosure Version 3/Part/Calibration Rig/X-Axis Ball Holder.stl
3D Printed Parts/Enclosure Version 3/Part/Calibration Rig/Z Axis Leg.FCStd
3D Printed Parts/Enclosure Version 3/Part/Calibration Rig/Z Axis Leg.stl
3D Printed Parts/Enclosure Version 3/Part/Print/5x2IRLED_Eyeball.FCStd
3D Printed Parts/Enclosure Version 3/Part/Print/5x2IRLED_Eyeball.stl
3D Printed Parts/Enclosure Version 3/Part/Print/Ambient_LED_Screen.FCStd
3D Printed Parts/Enclosure Version 3/Part/Print/Ambient_LED_Screen.stl
3D Printed Parts/Enclosure Version 3/Part/Print/Ambient_LED_Visor.FCStd
3D Printed Parts/Enclosure Version 3/Part/Print/Ambient_LED_Visor.stl
3D Printed Parts/Enclosure Version 3/Part/Print/Carrier_Clamps.stl
3D Printed Parts/Enclosure Version 3/Part/Print/ConnectorBoardv3_Carrier.FCStd
3D Printed Parts/Enclosure Version 3/Part/Print/ConnectorBoardv3_Carrier.stl
3D Printed Parts/Enclosure Version 3/Part/Print/EyeScreen.FCStd
3D Printed Parts/Enclosure Version 3/Part/Print/EyeScreen.stl
3D Printed Parts/Enclosure Version 3/Part/Print/EyeScreen_Clamp.FCStd
3D Printed Parts/Enclosure Version 3/Part/Print/EyeScreen_Clamp.stl
3D Printed Parts/Enclosure Version 3/Part/Print/Foot.FCStd
3D Printed Parts/Enclosure Version 3/Part/Print/Foot.stl
3D Printed Parts/Enclosure Version 3/Part/Print/IMX296-MPI_Eyeball_6mm_camfered.FCStd
3D Printed Parts/Enclosure Version 3/Part/Print/IMX296-MPI_Eyeball_6mm_camfered.stl
3D Printed Parts/Enclosure Version 3/Part/Print/Legacy/ConnectorBoardv0p2_Carrier.stl
3D Printed Parts/Enclosure Version 3/Part/Print/Legacy/ConnectorBoardv0p2_Carrier.stp
3D Printed Parts/Enclosure Version 3/Part/Print/Legacy/ConnectorBoardv2-Mod_Carrier.FCStd
3D Printed Parts/Enclosure Version 3/Part/Print/Legacy/ConnectorBoardv2-Mod_Carrier.step
3D Printed Parts/Enclosure Version 3/Part/Print/Legacy/ConnectorBoardv2-Mod_Carrier.stl
3D Printed Parts/Enclosure Version 3/Part/Print/Legacy/ConnectorBoardv2_Carrier.FCStd
3D Printed Parts/Enclosure Version 3/Part/Print/Legacy/ConnectorBoardv2_Carrier.stl
3D Printed Parts/Enclosure Version 3/Part/Print/Legacy/ConnectorBoardv2_Carrier.stp
3D Printed Parts/Enclosure Version 3/Part/Print/Legacy/LED_Clamp.FCStd
3D Printed Parts/Enclosure Version 3/Part/Print/Legacy/LED_Clamp.stl
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
