jeshernandez/PiTrac/docs/hardware/V3 Enclosure/3D-printing.md

---
title: Enclosure Version 3 Printing
layout: default
nav_order: 1
parent: V3 Enclosure
grand_parent: Hardware
description: Overview of the printable parts with slicer recommendations for preffered parts, variants and legacy parts.
keywords: DIY golf hardware, launch monitor parts, raspberry pi golf components, 3D print golf enclosure
og_image: /assets/images/logos/PiTrac_Square.png
last_modified_date: 2026.03.30
---

# Enclosure Version 3 / Printing

---

## Parts List

| Number | Maturity | Part | Amount | Build Plate Face* | Build Plate Adhesion | Support | Infill | Layer height | Wall Line Count |  Top/Bottom Line Count | Mass Per Part |
|---|---|---|---|---|---|---|---|---|---|---|---|
| 1 | R1 | EyeScreen.stl | 3 | inner plane face | none | none | 25 % | 0.2 | 3 | 7 | 33 g |
| 2 | R1 | 5x2IRLED_Eyeball.stl | 1 | bottom ring face | none | tree - everywhere  | 25 % | 0.2 | 3 | 7 | ? |
| 3 | R1 | Stack_Module_PSU_vent.stl | 1 | bottom face | brim | tree - everywhere | 25 % | 0.3 | 3 | 7 | ? |
| 4 | R1 | Pi5_Carrier_vertical_3mm.stl | 1 | flat face | none | none | 25 % | 0.2 | 3 | 7 | ? |
| 5 | R1 | IMX296-MPI_Eyeball_6mm_camfered.stl | 2 | back ring face | none | tree - touching buildplate | 25 % | 0.2 | 3 | 7 | 62 |
| 6 | R1 | Carrier_Clamps.stl | 4 | plane face | none | none | 25 % | 0.2 | 3 | 7 | 2.5 g |
| 7 | R1 | ConnectorBoardv3_Carrier.stl | 1 | plane face | none | none | 25 % | 0.2 | 3 | 7 | ? |
| 8 | R1 | Foot.stl | 4 | bottom face | none | none | 25 % | 0.2 | 3 | 7 | 1 g |
| 9 | R1 | LinePower_Cover.stl | 1 | top face | none | normal - touching buildplate | 25 % | 0.2 | 3 | 7 | 10 g |
| 10 | R1 | Stack_Module.stl | 3 | bottom face | brim | none | 25 % | 0.3 | 3 | 7 | 185 g |
| 11 | R1 | EyeScreen_Clamp.stl | 3 | inner plane face | none | none | 25 % | 0.2 | 3 | 7 | 30 g |
| 12 | R1 | Ambient_LED_Screen.stl | 1 | top face | brim | none | 25 % | 0.2 | 3 | 7 | ? |
| 13 | R1 | Spacer.stl | 16 | bottom face | none | none | 25 % | 0.2 | 3 | 7 | 0.2 g |
| 14 | R1 | Stack_Module_Cover_forInserts.stl | 1 | bottom face | brim | tree - everywhere | 25 % | 0.3 | 3 | 7 | ? |
| 15 | R1 | Stack_Module_Cover_insert.stl | 1 | bottom face | none | tree - everywhere | 25 % | 0.2 | 3 | 7 | ? |
| 16 | R1 | Stack_Module_Cover_LogoTee.stl | 1 | flat face | none | none | 25 % | 0.2 | 3 | 7 | ? |
| 17 | R1 | Stack_Module_Cover_LogoBall.stl | 1 | flat face | none | none | 25 % | 0.2 | 3 | 7 | ? |
| 18 | R1 | Ambient_LED_Visor.stl | 1 | flat face | none | none | 25 % | 0.3 | 3 | 7 | 27 g |

## Variants

| Number | Maturity | Part | Amount | Build Plate Face | Build Plate Adhesion | Support | Infill | Layer height | Wall Line Count |  Top/Bottom Line Count | Mass Per Part |
|---|---|---|---|---|---|---|---|---|---|---|---|
| 1 | F2 | IRFilter_Mount_1inchround.stl | 1 | frontal face | none | none | 25 % | 0.2 | 3 | 7 | 3 g |
| 2 | A1 | Pi5_Carrier_3mmTroughHole.stl | 1 | plane face | none | none | 25 % | 0.2 | 3 | 7 | 13 g |
| 3 | P1 | Pi5_Carrier_9mm.stl | 1 | plane face | none | none | 25 % | 0.2 | 3 | 7 | 14 g |
| 4 | P1 | pan-tilt_base.stl | 3 | layed flat, hexagon facing up | none | normal | 25 % | 0.2 | 3 | 7 | ? |
| 5 | P1 | pan-tilt_Innomaker-mount.stl | 2 | large plane facing down | none | normal | 25 % | 0.2 | 3 | 7 | ? |
| 6 | P1 | pan-tilt_LED-mount.stl | 1 | large plane facing down | none | normal | 25 % | 0.2 | 3 | 7 | ? |
| 7 | D1 | IMX296-MPI_Eyeball_2p8mm.stl | 2 | back ring face | none | normal - touching buildplate | 25 % | 0.2 | 3 | 7 | ? |
| 8 | A1 | Pi5_Bagpack.stl | 1 | standing | none | normal - everywhere | 25 % | 0.2 | 3 | 7 | 40g |
| 9 | A1 | Pi5_Bagpack_bottom.stl | 1 | flat side down | none | normal - everywhere | 25 % | 0.2 | 3 | 7 | 12g |
| 10 | A1 | Pi5_Bagpack_top.stl | 1 | flat side down | none | normal - everywhere | 25 % | 0.2 | 3 | 7 | 13g |
| 11 | D1 | Stack_Module_Cover_light.stl | 1 | bottom face | brim | tree - everywhere | 25 % | 0.3 | 3 | 7 | 120 g |
| 12 | A1 | Pi5_Carrier_vertical_0p2mmTroughHole.stl | 1 | flat face | none | none | 25 % | 0.2 | 3 | 7 | ? |
| 13 | A1 | Back_Interface_Plate.FCStd | 1 | flat face | none | normal - everywhere | 25 % | 0.2 | 3 | 7 | ? |
| 14 | F2 | Stack_Module_PSU.stl | 1 | bottom face | brim | tree - everywhere | 25 % | 0.3 | 3 | 7 | 150 g |
| 15 | F2 | IMX296-MPI_Eyeball_6mm.stl | 2 | back ring face | none | tree - touching buildplate | 25 % | 0.2 | 3 | 7 | 65 g |
| 16 | D1 | IMX296-MPI_Eyeball_2p8mm_camfered.stl | 2 | back ring face | none | normal - touching buildplate | 25 % | 0.2 | 3 | 7 | ? |
| 17 | F2 | Stack_Module_Cover.stl | 1 | bottom face | brim | tree - everywhere | 25 % | 0.3 | 3 | 7 | 200 g |
| 18 | F2 | Pi5_Carrier_3mm.stl | 1 | plane face | none | none | 25 % | 0.2 | 3 | 7 | 13 g |
| 19 | P1 | Back_Interface_Plate_Type_D_Bulkhead.stl | 1 | flat, wider face | none | none | 15 % | 0.2 | 3 | 7 | 12g |

## Legacy Parts List

| Number | Maturity | Part | Amount | Build Plate Face | Build Plate Adhesion | Support | Infill | Layer height | Wall Line Count |  Top/Bottom Line Count | Mass Per Part |
|---|---|---|---|---|---|---|---|---|---|---|---|
| 1 | D1 | ConnectorBoardv0p2_Carrier.stl | 1 | plane face | none | none | 25 % | 0.2 | 3 | 7 | ? |
| 2 | D1 | PiCam_Eyeball_6mm.stl | 1 | back ring face | none | normal - touching buildplate | 25 % | 0.2 | 3 | 7 | ? |
| 3 | D1 | PiCam_Eyeball_2p8mm.stl | 1 | back ring face | none | normal - touching buildplate | 25 % | 0.2 | 3 | 7 | ? |
| 4 | F2 | LED_Eyeball.stl | 1 | frontal ring face | none | none | 25 % | 0.2 | 3 | 7 | 32 g |
| 5 | F2 | LED_Clamp.stl | 1 | back face | none | normal - touching buildplate | 25 % | 0.2 | 3 | 7 | 8 g |
| 6 | F2 | ConnectorBoardv2-mod_Carrier.stl | 1 | plane face | none | none | 25 % | 0.2 | 3 | 7 | ? |
| 7 | P1 | ConnectorBoardv2.stl | 1 | plane face | none | none | 25 % | 0.2 | 3 | 7 | ? |
| 8 | D1 | PiCam_Eyeball_6mm_camfered.stl | 1 | back ring face | none | normal - touching buildplate | 25 % | 0.2 | 3 | 7 | ? |

---

## Notes

- **Build Plate Face:** The surface that should be placed on the print bed.  In doubt refer to ```...\PiTrac\3D Printed Parts\Enclosure Version 3\Assets\Part pictures```
- **Build Plate Adhesion:** e.g., *None*, *Skirt*, *Brim*, *Raft*.  Only use if necessary, avoid if possible. Heavily depends on filament choice and printer.
- **Support:** e.g., *None*, *Tree*, *Normal*, *Touching Buildplate*, *Everywhere*. Tree-style seemingly is easier to remove.
- **Amount:** Number of required copies.
- **Material:** It is advised to use UL94 V-0 compliant filament. PETG preferred for toughness/impact resistance. PLA will work as a cheaper alternative. (UL94 V-0 Options: Prusament PETG V0, Sunlu ABS FR, Form Futura ABSpro - Flame Retardant, Fiberlogy PETG-V0, Spectrum Filaments FlameGuard PLA)
- **Stack_Module:** The stack module can be sectioned into three pieces if print duration per part is an issue. One horizontal cut 3mm above bottom, and one vertical cut in the center plane.

## Part Maturity Levels

Maturity classification for all 3D printed parts:

| Level | Name | Description |
|---|---|---|
| D0 | Concept | Initial idea or early design draft. Not finalized. |
| D1 | Designed | CAD model completed but not yet physically printed. |
| P1 | Print Verified | Successfully printed. Geometry confirmed. |
| A1 | Assembly Verified | Installed in assembly. Mechanical fit confirmed. |
| F1 | Function Tested | Tested under intended operating conditions. |
| F2 | Field Validated | Proven in real-world / extended use. |
| R1 | Release Stable | Considered stable, fully documented, and community proven. |
