jeshernandez/PiTrac/3D Printed Parts/Enclosure Version 3/Assets/Part pictures/Back_Interface_Plate_Type_D_Bulkhead_Printed_Part.jpeg

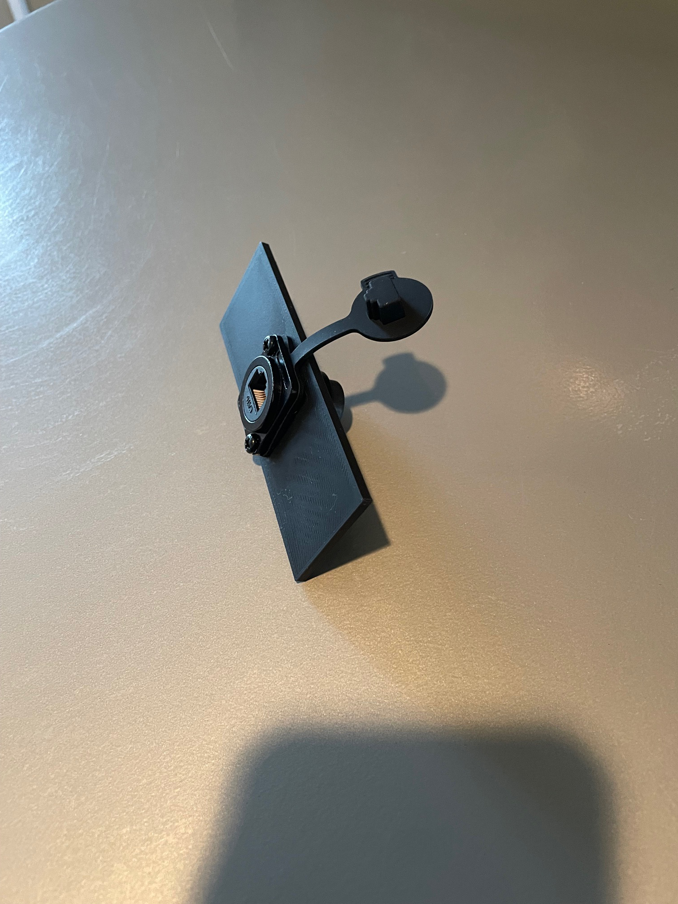
3D Printed Parts/Enclosure Version 3/Assets/Part pictures/Back_Interface_Plate_Type_D_Bulkhead_Printed_Part.jpeg
