jeshernandez/PiTrac/Dev/img/install_menu.png

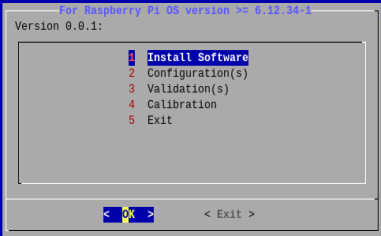
Dev/img/install_menu.png
