jeshernandez/PiTrac/docs/assets/PiTrac-Camera-Calibration-Worksheet.xlsx

See the Calibration Instructions here: https://github.com/jamespilgrim/PiTrac/tree/main/Documentation for how to use this worksheet.
Camera 1
X | 0.6 |  | X_Degrees: | 46.97
Y | 0.275 |  |  |  | Alternative calculation - Y_Degrees
Z | 0.56 |  | Y_Degrees | -18.33 |  | -17.44
H | 0.87
R | 0.83
Camera 2
X | 0 |  | X_Degrees: | 0.00
Y | 0.109 |  | Y_Degrees | 5.30
Z | 0.55
H | 0.56
E1 | 0.16
E2 | 0.051 | (calculated)
