jeshernandez/PiTrac/docs/assets/images/enclosure_assembly/AutoCalibration_Rig_Type_Selection.png

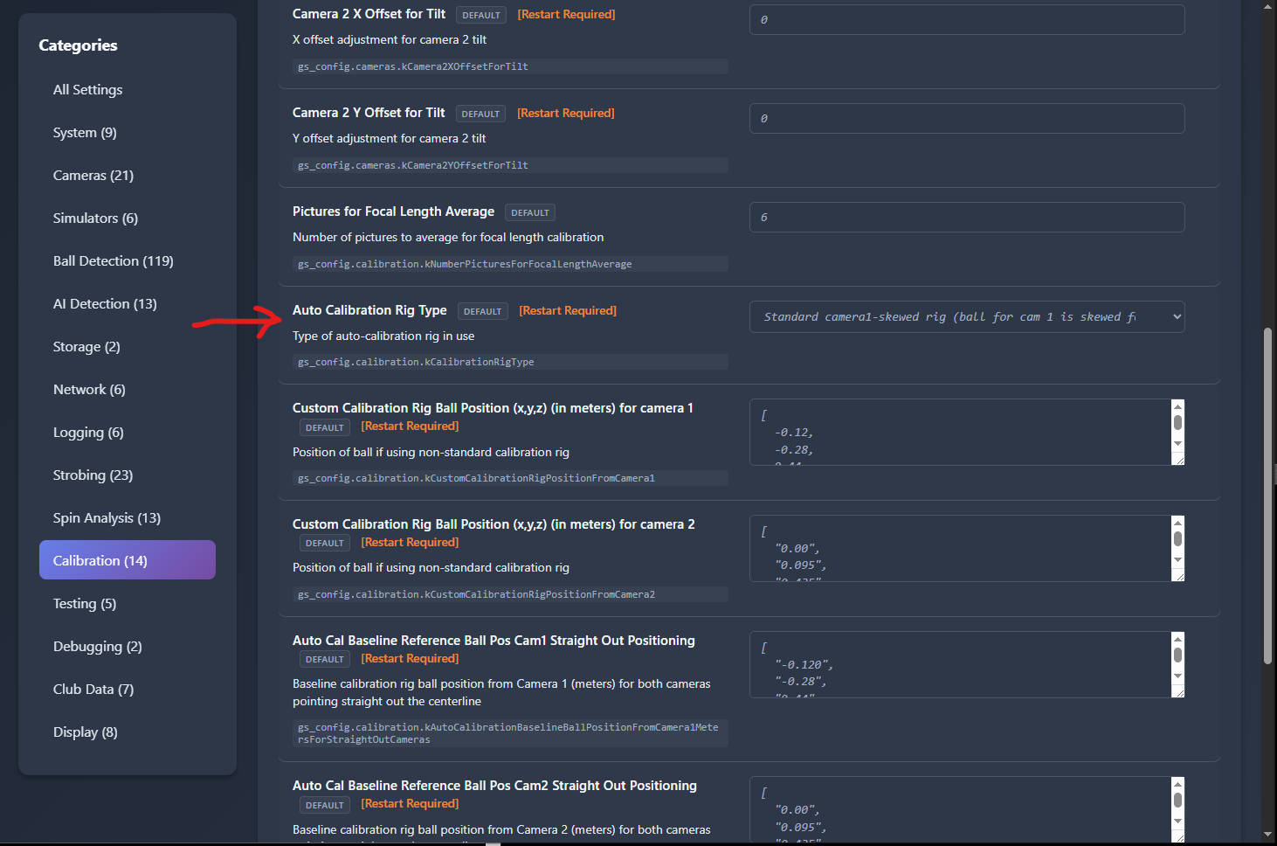
docs/assets/images/enclosure_assembly/AutoCalibration_Rig_Type_Selection.png
