jeshernandez/PiTrac/Hardware/Schematic/V3 Connector + IRLED2 Schematic.pdf

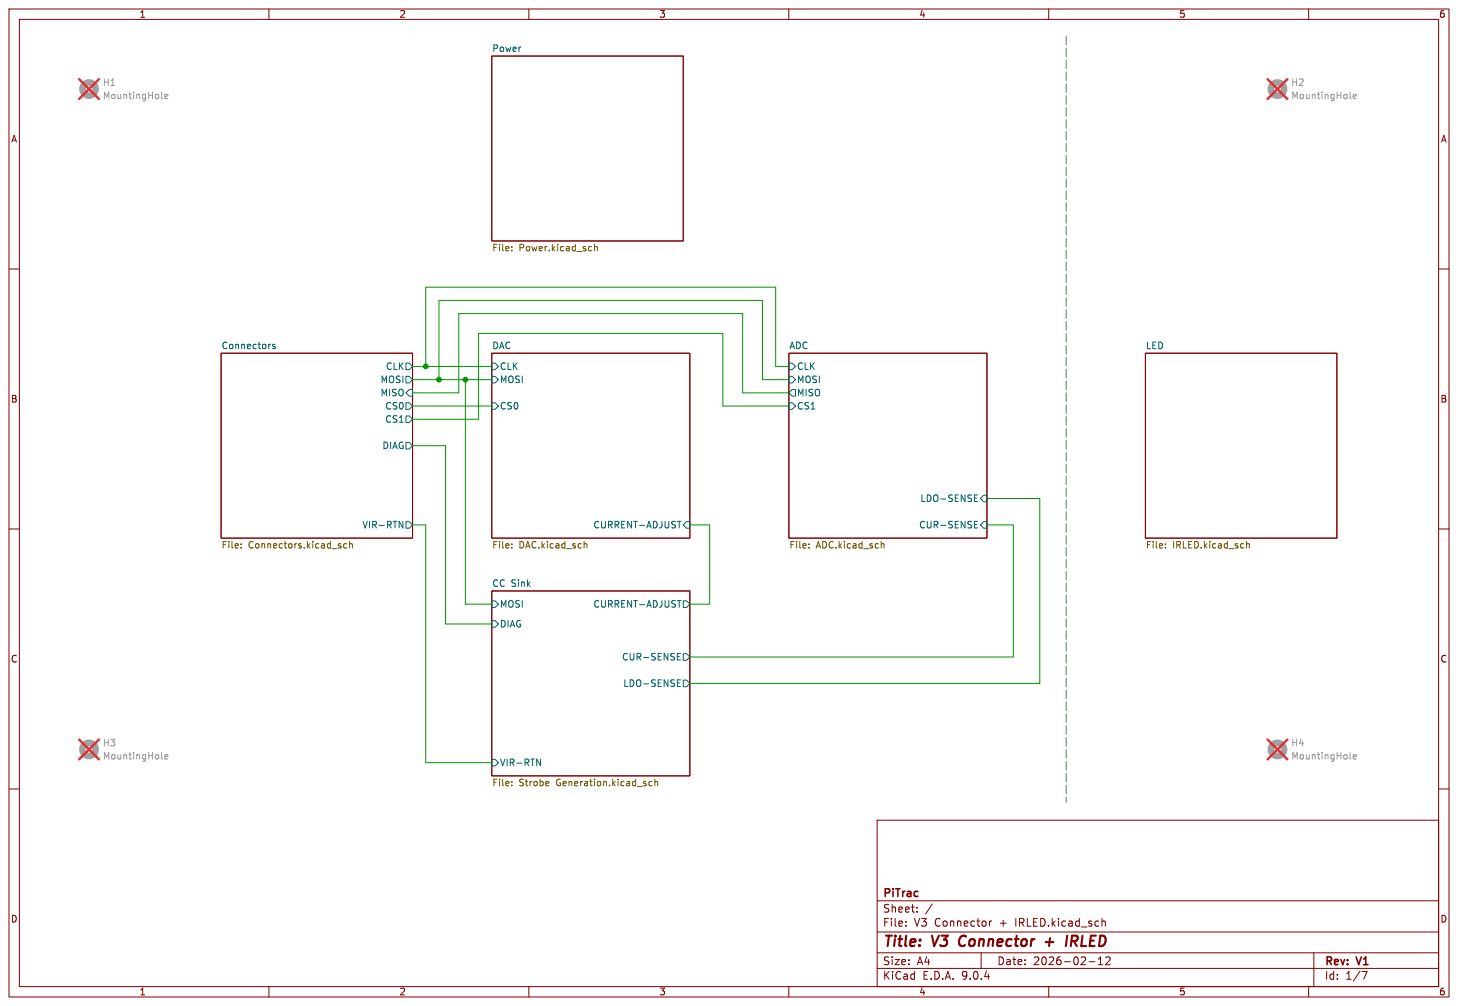
[picture p152: page 1]

CLK MOSI DIAG MISO

File: IRLED.kicad_sch VIR-RTN

LDO-SENSE CUR-SENSE CC Sink File: Strobe Generation.kicad_sch

Id: 1/7 Title: V3 Connector + IRLED

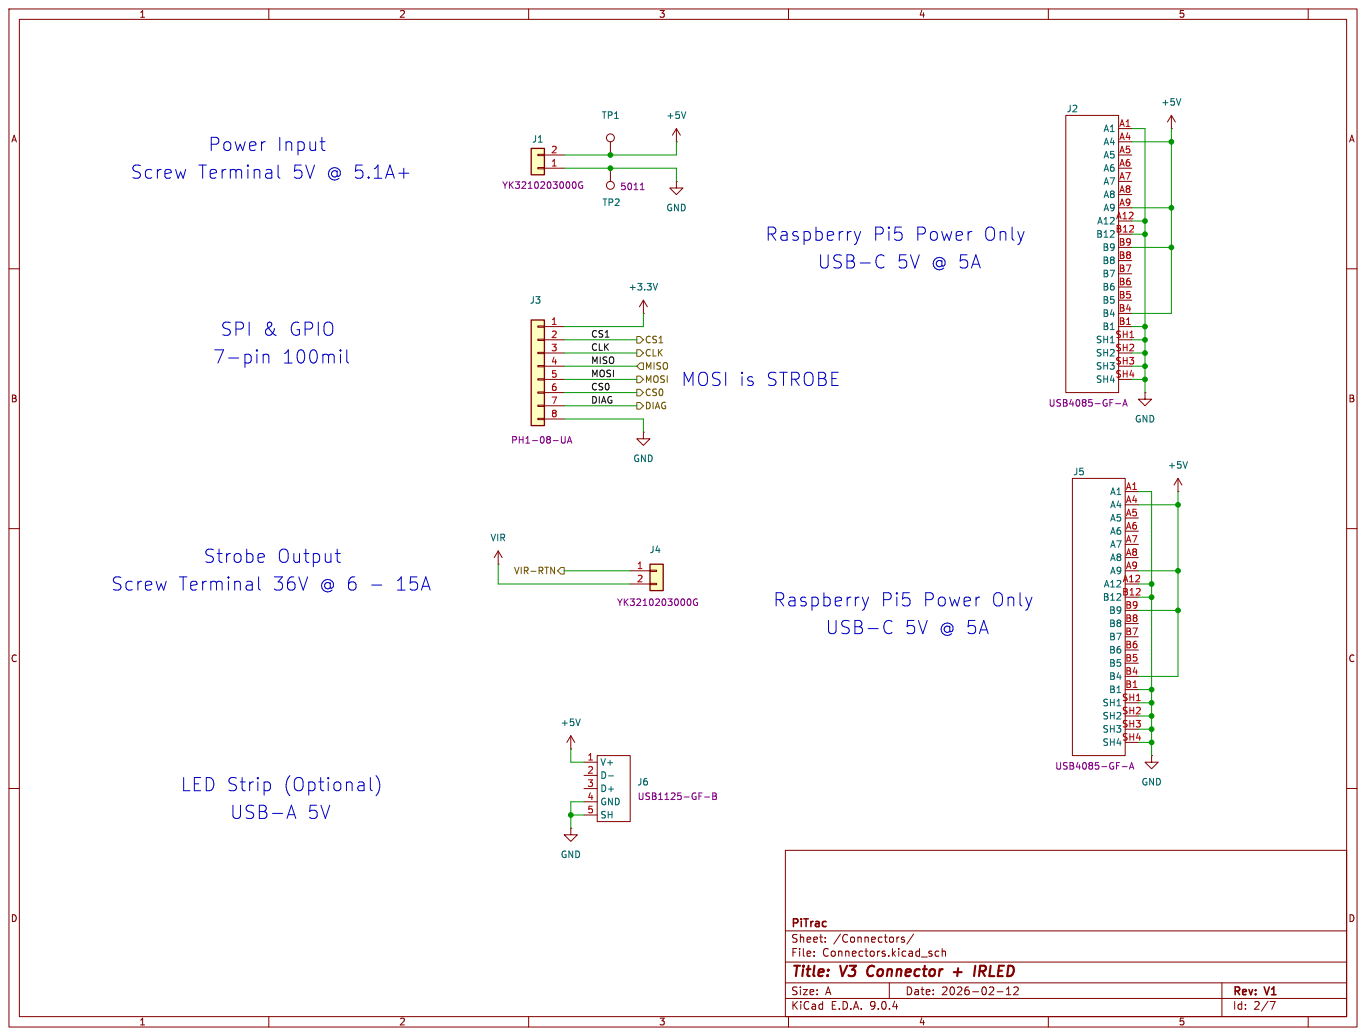
[picture p153: page 2]

SPI & GPIO
CLK DIAG MOSI CS0 CS1 Strobe Output

File: Connectors.kicad_sch Sheet: /Connectors/ PiTrac

Id: 2/7 Title: V3 Connector + IRLED

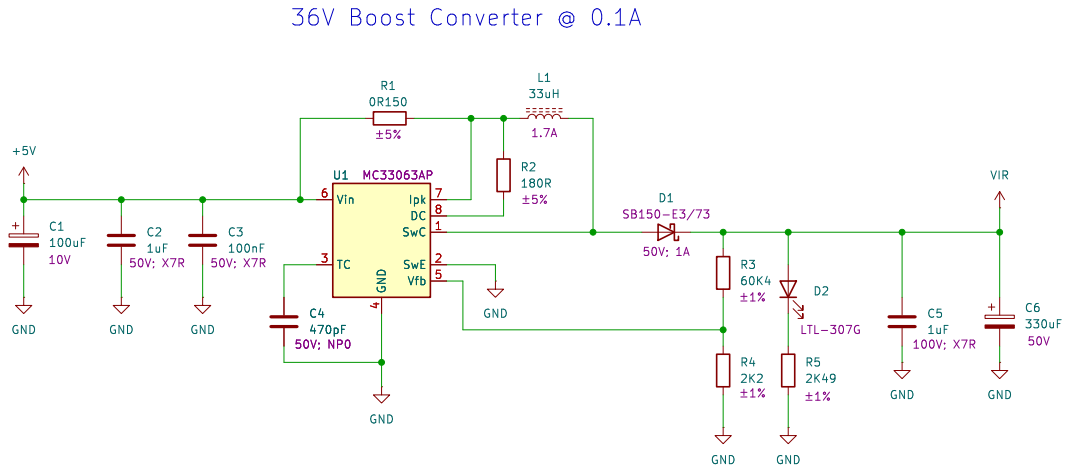
[picture p154: page 3]

File: Power.kicad_sch Sheet: /Power/ PiTrac

Id: 3/7 Title: V3 Connector + IRLED

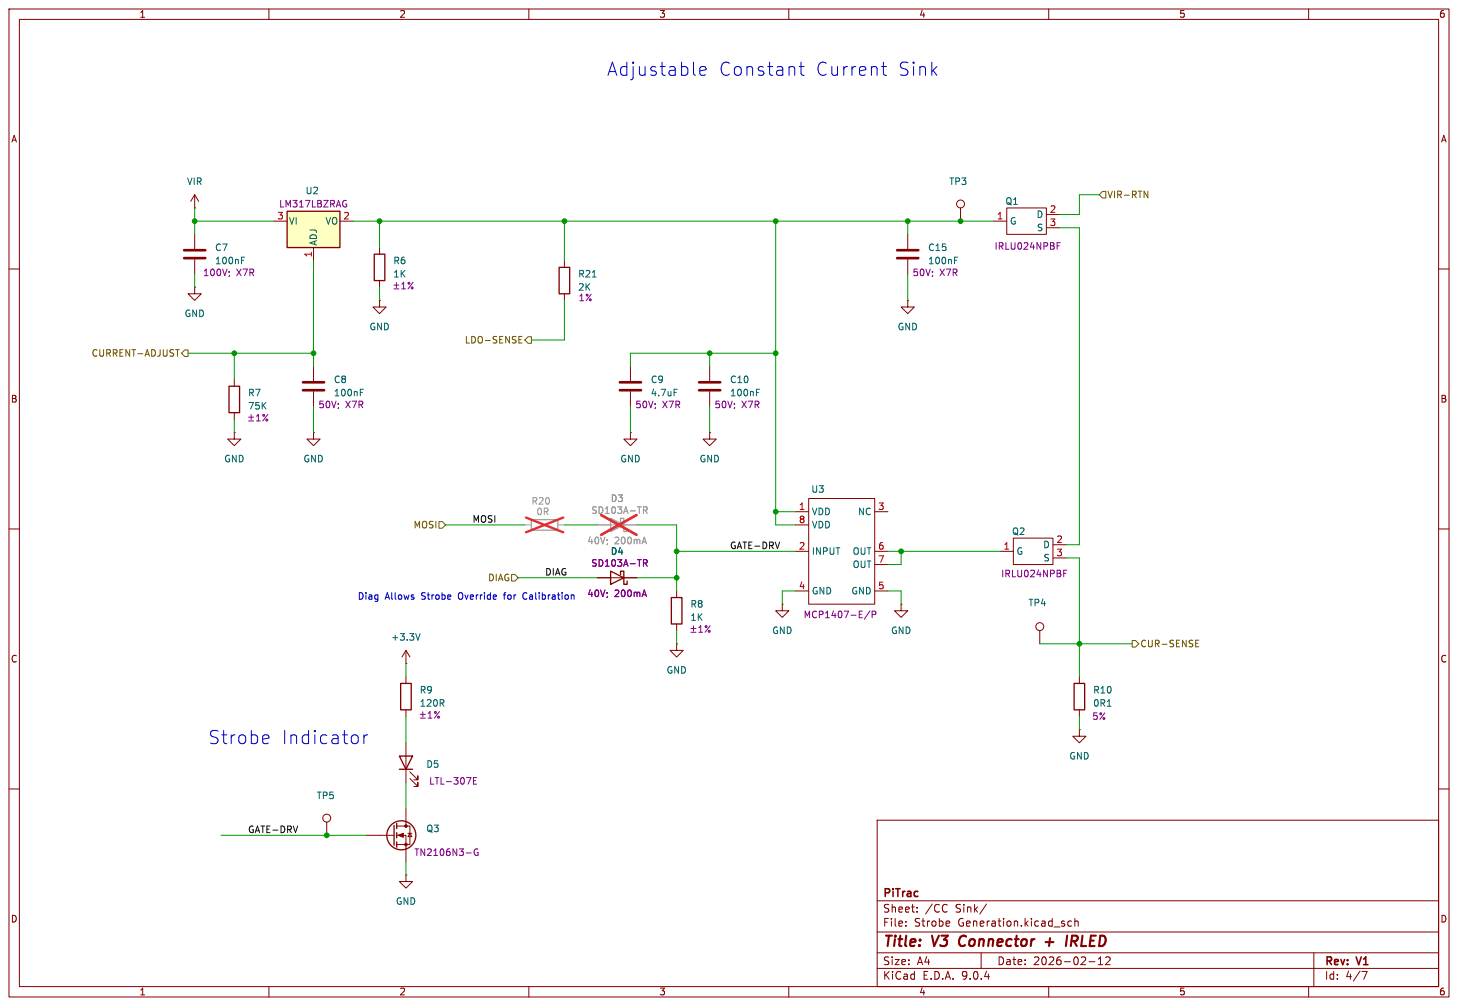
[picture p155: page 4]

GATE-DRV Strobe Indicator

File: Strobe Generation.kicad_sch Sheet: /CC Sink/ PiTrac

Id: 4/7 Title: V3 Connector + IRLED

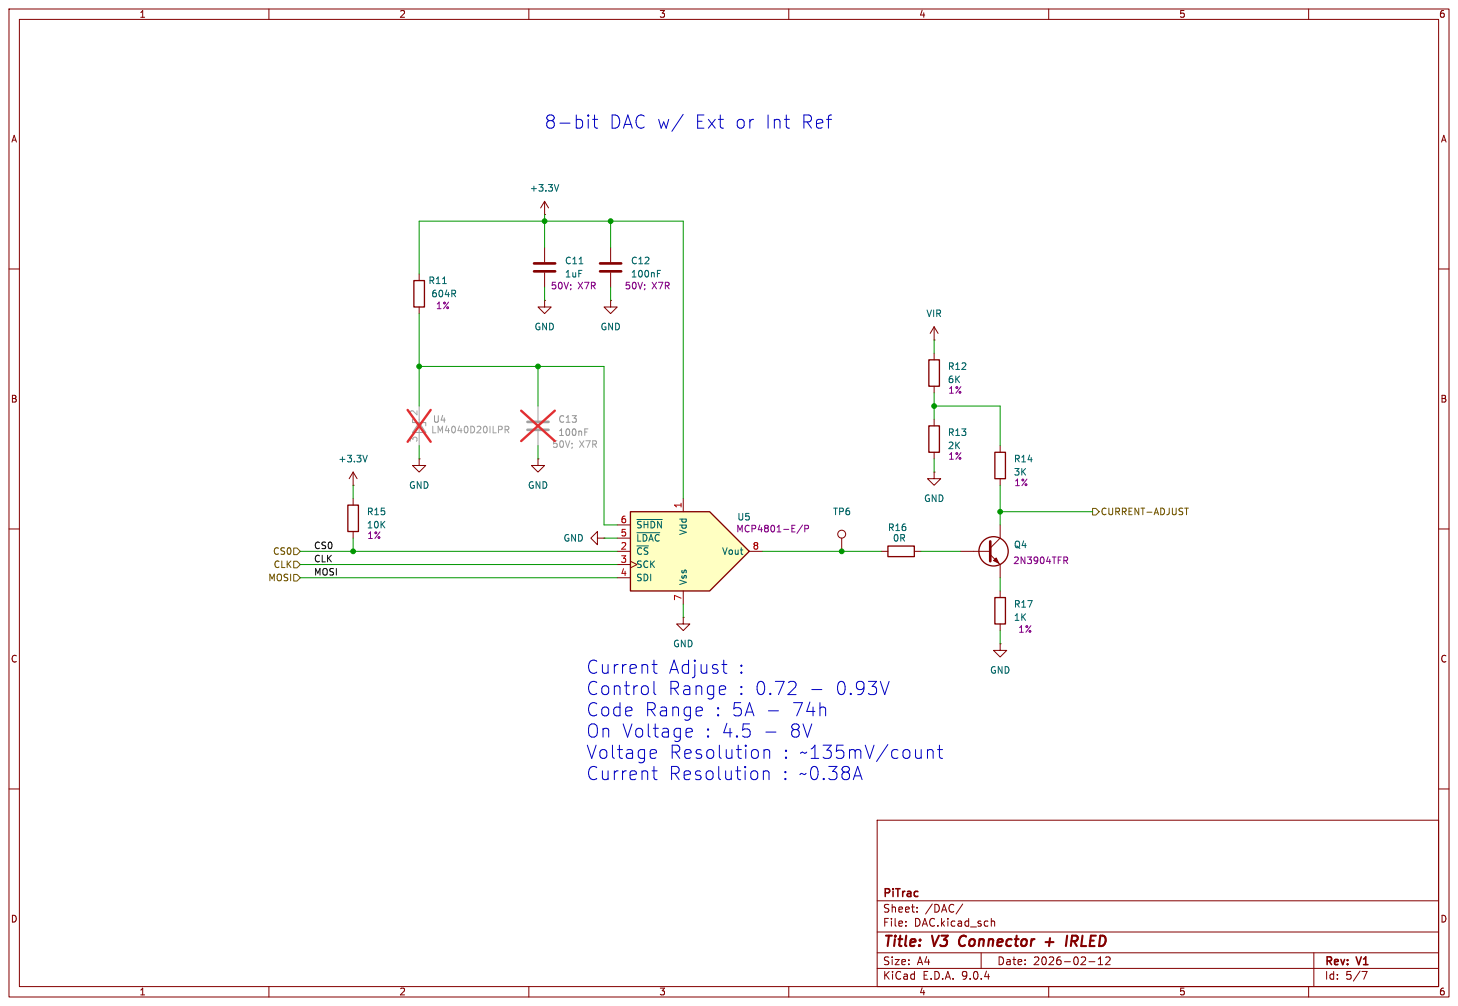
[picture p156: page 5]

Id: 5/7 Title: V3 Connector + IRLED

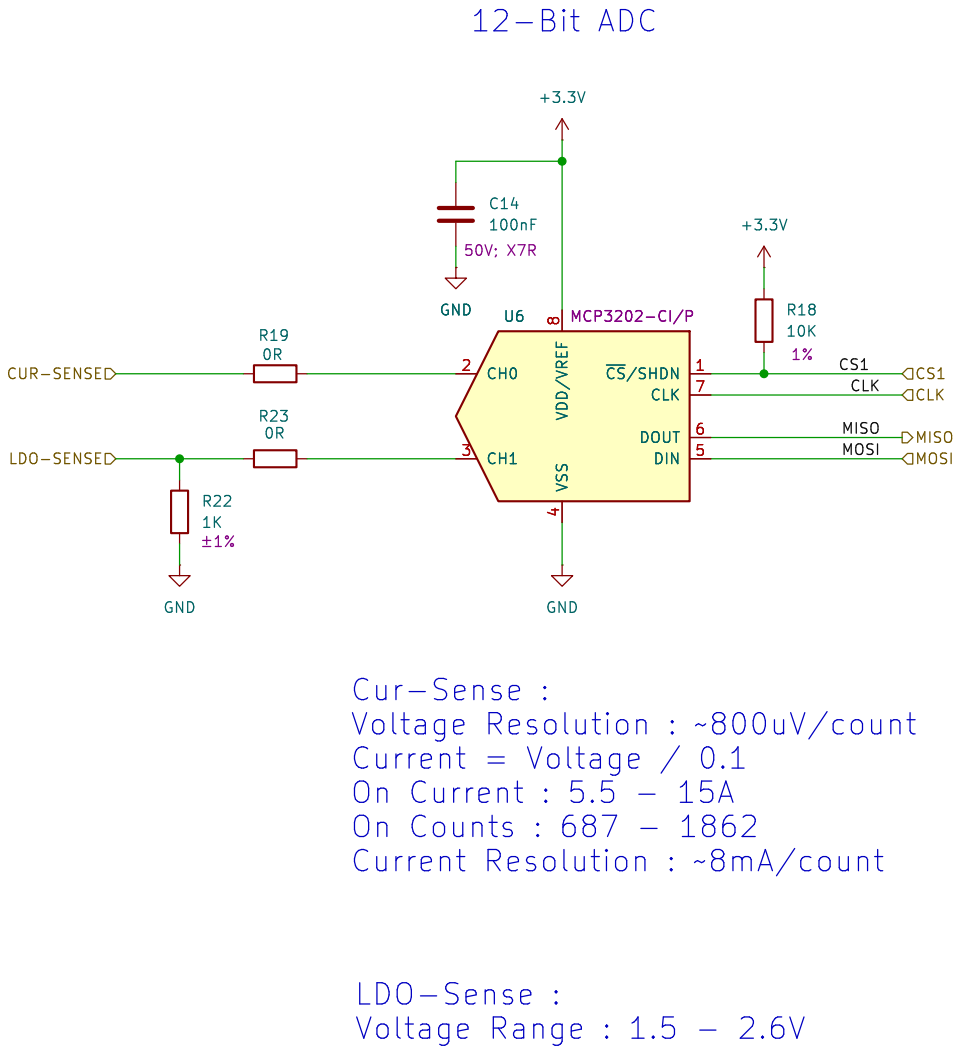
[picture p157: page 6]

4 ~{CS}/SHDN 1 CLK 7 DOUT 6 DIN 5 GND

4 ~{CS}/SHDN 1 CLK 7 DOUT 6 DIN 5 U6 MCP3202-CI/P R19

File: ADC.kicad_sch Sheet: /ADC/ PiTrac

Id: 6/7 Title: V3 Connector + IRLED

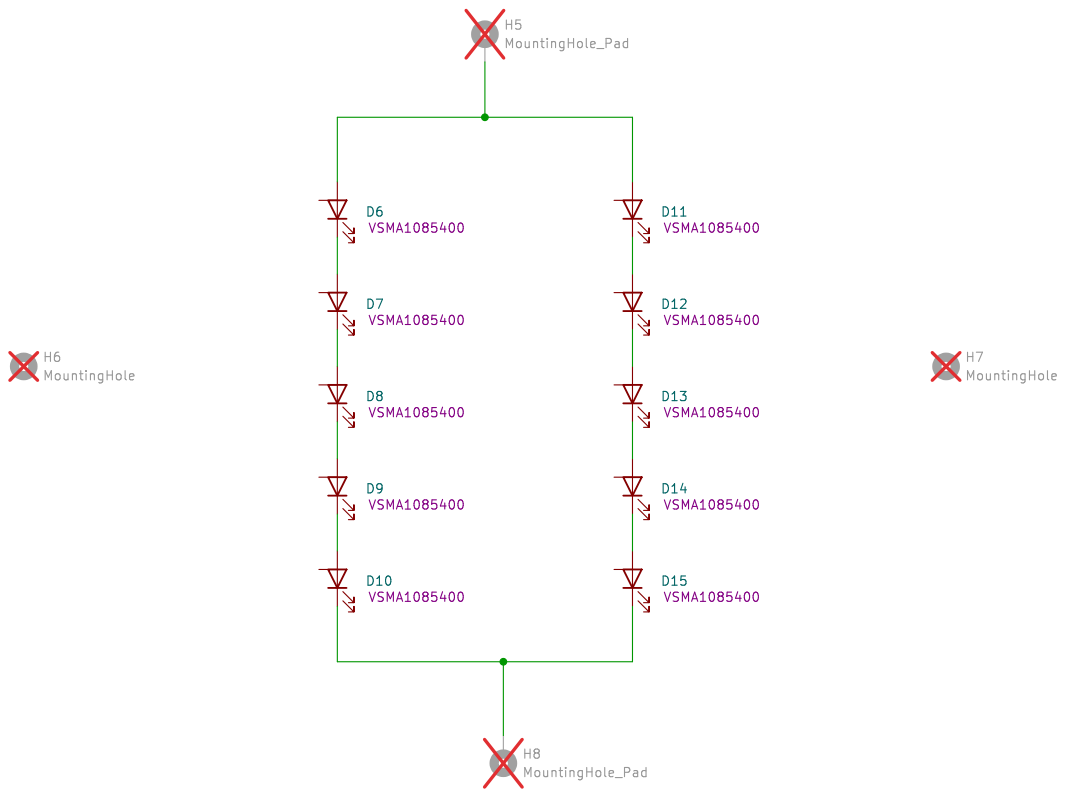
[picture p158: page 7]

Id: 7/7 Title: V3 Connector + IRLED
