jeshernandez/PiTrac/Hardware/Connector Board v2/Design/Constant Current Sink IR LED.asc

C1: cap; 470p
M1: nmos; AOUS66416
R1: res; 2
R2: res; 0.033
R3: res; 5
R4: res; 50
U1: LT6202
V1: voltage; 5
V2: voltage; PULSE(0.1 0 0 100n 100n 900n 2000n)
V3: voltage; 36
Named nets: 0
.tran 32000n
