jeshernandez/PiTrac/Hardware/Connector Board v2/PiTrac Pi Connector.kicad_pcb

## KiCad design Hardware/Connector Board v2/PiTrac Pi Connector.kicad_pcb (2025-09-07)

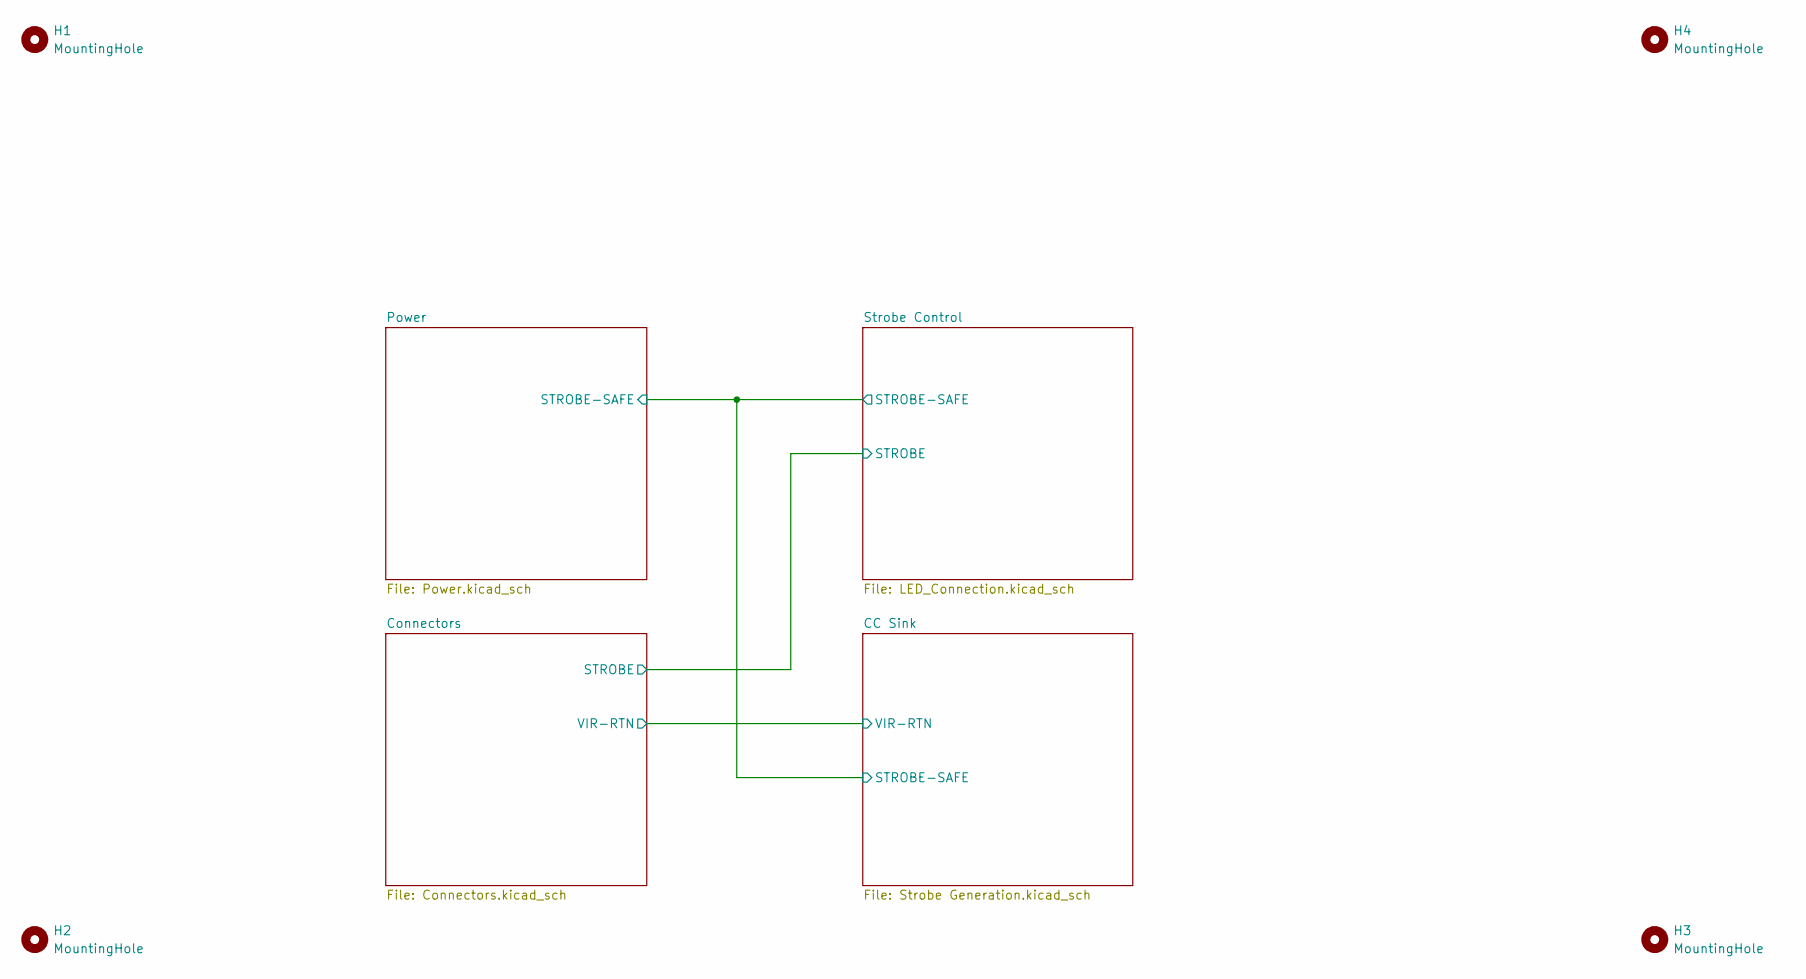
[picture p167: schematic PiTrac Pi Connector.kicad_sch, Dual RPi5 Connector Board]

Parts:
H1, H2, H3, H4: MountingHole; MountingHole_3.5mm

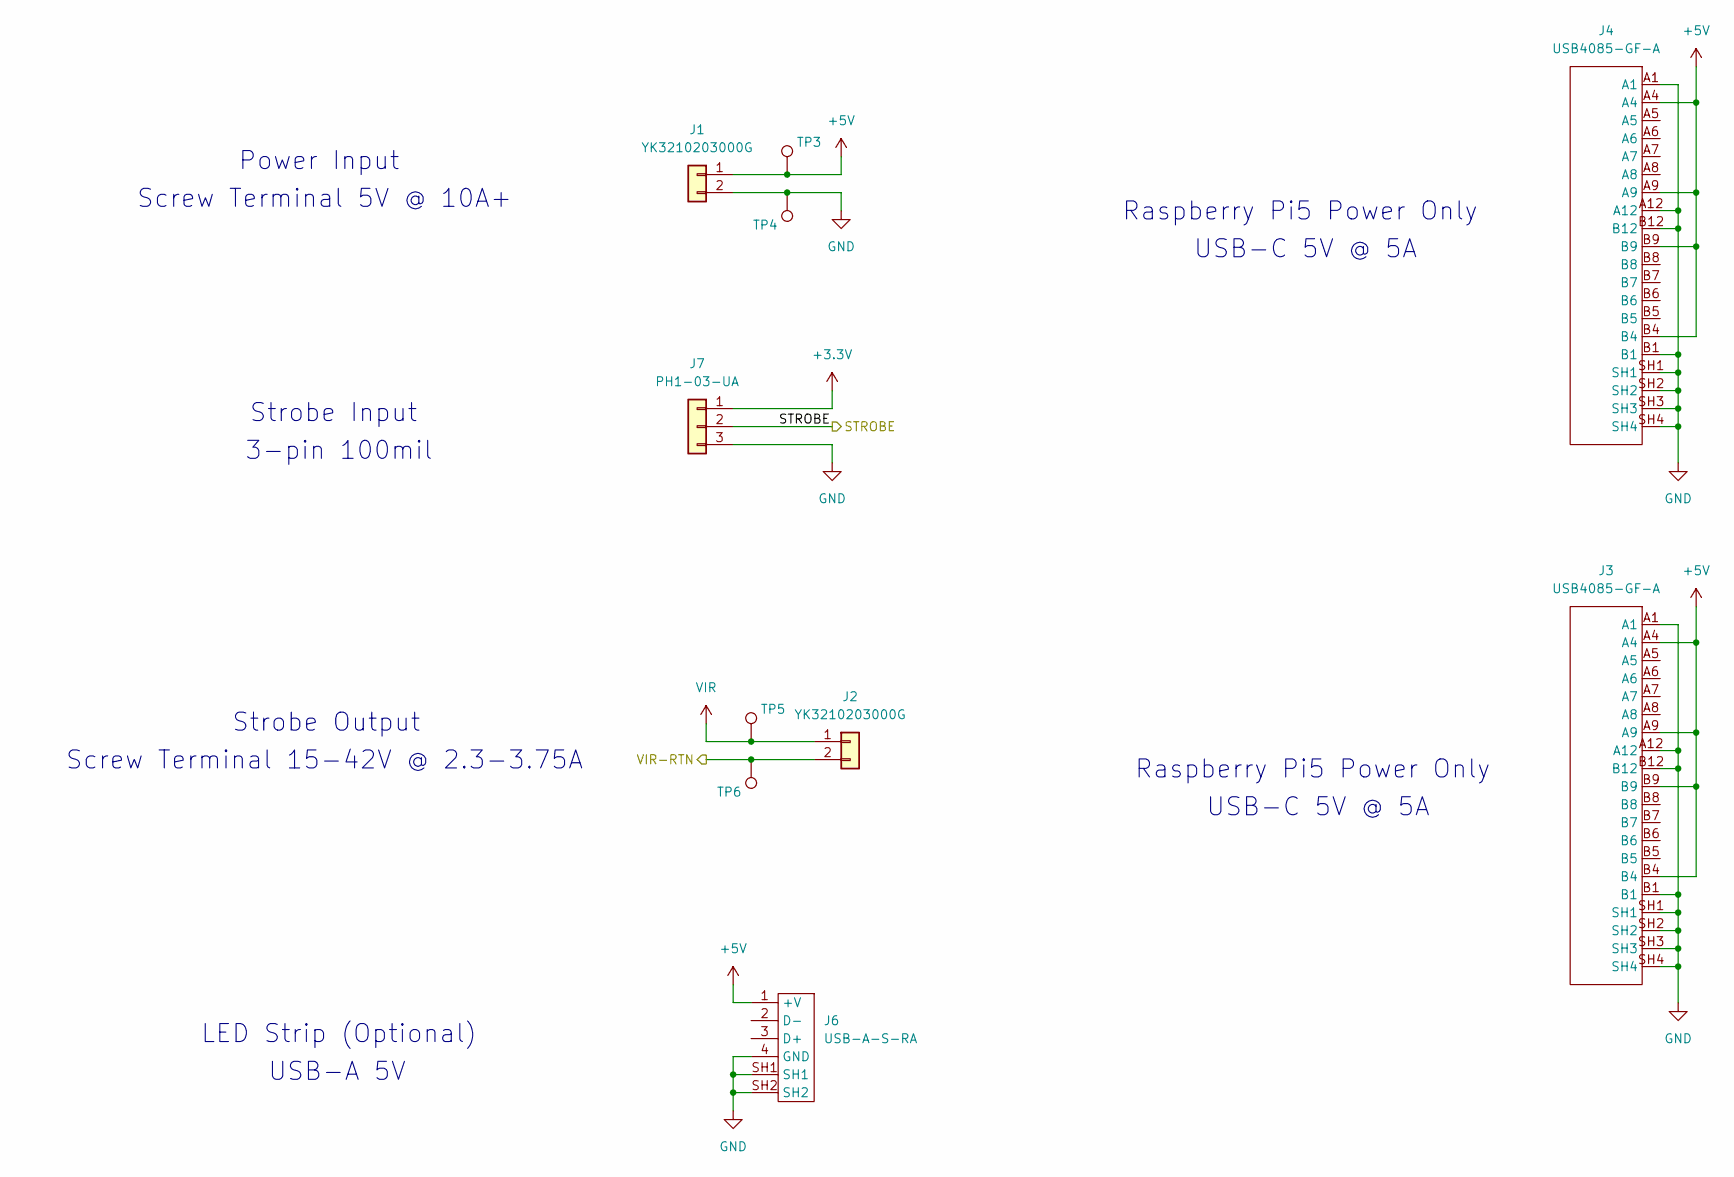
[picture p168: schematic Connectors.kicad_sch, Dual RPi5 Connector Board]

Parts:
J1, J2: YK3210203000G
J3, J4: USB4085-GF-A
J6: USB-A-S-RA
J7: PH1-03-UA; PinHeader_1x03_P2.54mm_Vertical
TP3, TP4, TP5, TP6: TestPoint; TestPoint_Pad_D1.0mm

Connections:
+3.3V: J7.1; also elsewhere on the board
+5V: J1.1, J3.A4, J3.A9, J3.B4, J3.B9, J4.A4, J4.A9, J4.B4, J4.B9, J6.1 (+V), TP3.1; also elsewhere on the board
/CC Sink/VIR-RTN: J2.2, TP6.1; also elsewhere on the board
/Connectors/STROBE: J7.2; also elsewhere on the board
GND: J1.2, J3.A1, J3.A12, J3.B1, J3.B12, J3.SH1, J3.SH2, J3.SH3, J3.SH4, J4.A1, J4.A12, J4.B1, J4.B12, J4.SH1, J4.SH2, J4.SH3, J4.SH4, J6.4 (GND), J6.SH1, J6.SH2, J7.3, TP4.1; also elsewhere on the board
VIR: J2.1, TP5.1; also elsewhere on the board

Notes on the sheet:
Power Input
Raspberry Pi5 Power Only
LED Strip (Optional)
Screw Terminal 15-42V @ 2.3-3.75A
3-pin 100mil
USB-C 5V @ 5A
Screw Terminal 5V @ 10A+
USB-A 5V
Strobe Output
Strobe Input
