jeshernandez/PiTrac/Hardware/Connector Board v2/PiTrac Pi Connector.kicad_pcb

## KiCad design Hardware/Connector Board v2/PiTrac Pi Connector.kicad_pcb (continued)

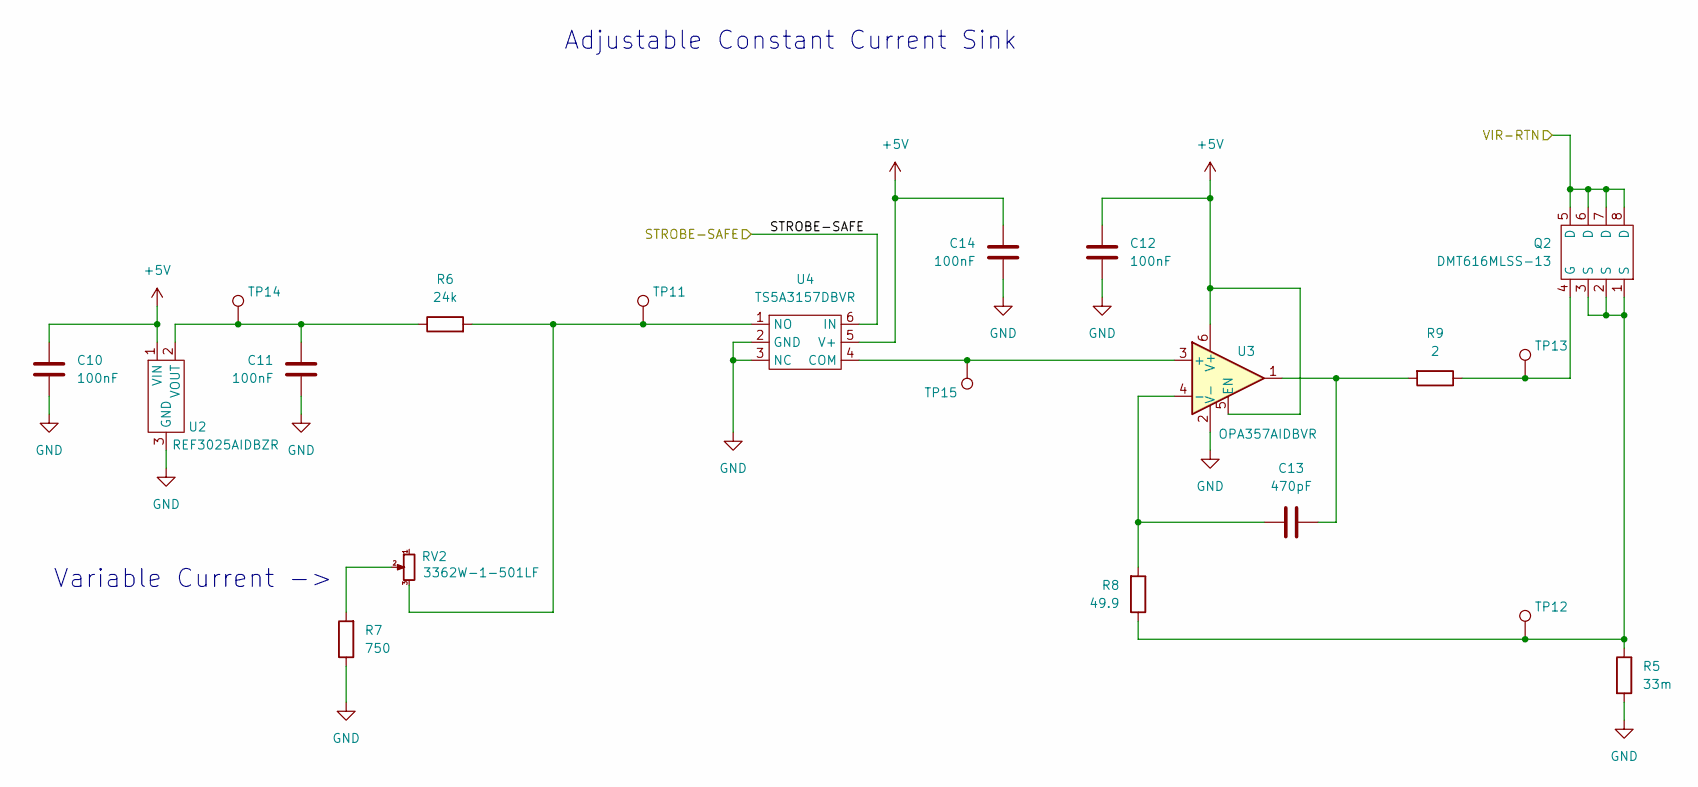
[picture p169: schematic Strobe Generation.kicad_sch, Dual RPi5 Connector Board]

Parts:
C10, C11, C12, C14: 100nF; C_0603_1608Metric_Pad1.08x0.95mm_HandSolder; Part Number GCJ188R71H104KA12D
C13: 470pF; C_0603_1608Metric_Pad1.08x0.95mm_HandSolder; Part Number GCM1885C1H471JA16J
Q2: DMT616MLSS-13; SOIC-8_3.9x4.9mm_P1.27mm_HandSolder
R5: 33m; R_1206_3216Metric_Pad1.30x1.75mm_HandSolder; Part Number RL1206FR-7W0R033L
R6: 24k; R_0603_1608Metric_Pad0.98x0.95mm_HandSolder; Part Number RC0603FR-1024KL
R7: 750; R_0603_1608Metric_Pad0.98x0.95mm_HandSolder; Part Number RC0603FR-10750RL
R8: 49.9; R_0603_1608Metric_Pad0.98x0.95mm_HandSolder; Part Number RC0603FR-1349R9L
R9: 2; R_0603_1608Metric_Pad0.98x0.95mm_HandSolder; Part Number RC0603JR-072RL
RV2: 3362W-1-501LF
TP11, TP12, TP13, TP14, TP15: TestPoint; TestPoint_Pad_D1.0mm
U2: REF3025AIDBZR; SOT-23-3
U3: OPA357AIDBVR; SOT-23-6_Handsoldering
U4: TS5A3157DBVR; SOT-23-6_Handsoldering

Connections:
+5V: C10.1, C12.1, C14.1, U2.1 (VIN), U3.5 (EN), U3.6 (V+), U4.5 (V+); also elsewhere on the board
/CC Sink/STROBE-SAFE: U4.6 (IN); also elsewhere on the board
/CC Sink/VIR-RTN: Q2.5 (D), Q2.6 (D), Q2.7 (D), Q2.8 (D); also elsewhere on the board
GND: C10.2, C11.2, C12.2, C14.2, R5.2, R7.1, U2.3 (GND), U3.2 (V-), U4.2 (GND), U4.3 (NC); also elsewhere on the board
unnamed: C13.2, R9.2, U3.1
unnamed: Q2.4 (G), R9.1, TP13.1
unnamed: Q2.1 (S), Q2.2 (S), Q2.3 (S), R5.1, R8.1, TP12.1
unnamed: R7.2, RV2.2
unnamed: C11.1, R6.1, TP14.1, U2.2 (VOUT)
unnamed: TP15.1, U3.3 (+), U4.4 (COM)
unnamed: C13.1, R8.2, U3.4 (-)
unnamed: R6.2, RV2.3, TP11.1, U4.1 (NO)

Notes on the sheet:
Variable Current ->
Adjustable Constant Current Sink

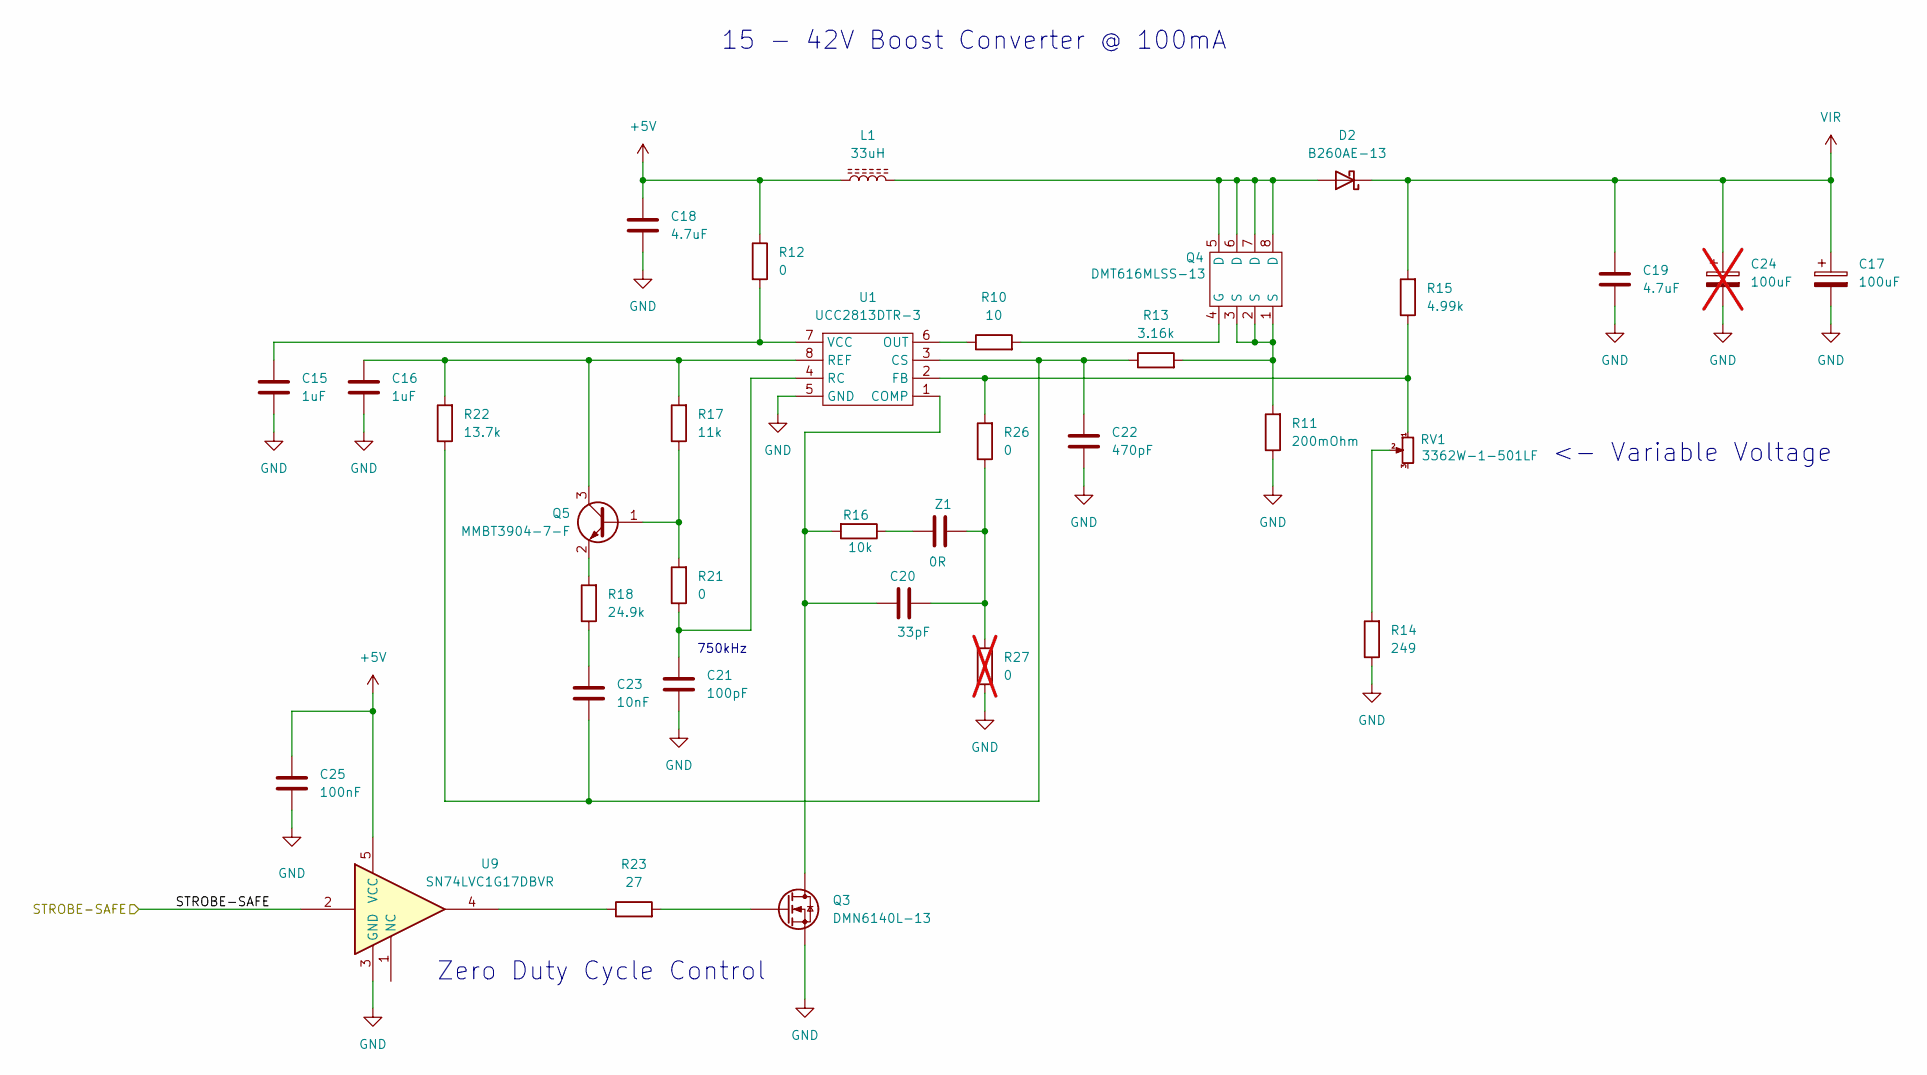
[picture p170: schematic Power.kicad_sch, Dual RPi5 Connector Board]

Parts:
C15, C16: 1uF; C_0603_1608Metric_Pad1.08x0.95mm_HandSolder; Part Number GCM188R71C105KA64J
C17: 100uF; CP_Radial_D10.0mm_P5.00mm; Part Number HHSE630ELL101MJC5S
C18: 4.7uF; C_0805_2012Metric_Pad1.18x1.45mm_HandSolder; Part Number GRM21BR71C475KE51L
C19: 4.7uF; C_1206_3216Metric_Pad1.33x1.80mm_HandSolder; Part Number GRM31CZ72A475KE11L
C20: 33pF; C_0603_1608Metric_Pad1.08x0.95mm_HandSolder; Part Number GCM1885C2A330JA16D
C21: 100pF; C_0603_1608Metric_Pad1.08x0.95mm_HandSolder; Part Number GCM1885C1H101JA16D
C22: 470pF; C_0603_1608Metric_Pad1.08x0.95mm_HandSolder; Part Number GCM1885C1H471JA16J
C23: 10nF; C_0603_1608Metric_Pad1.08x0.95mm_HandSolder; Part Number GRM188R72A103KA01D
C24: 100uF; CP_Radial_D10.0mm_P5.00mm; Part Number HHSE630ELL101MJC5S; not fitted
C25: 100nF; C_0603_1608Metric_Pad1.08x0.95mm_HandSolder; Part Number GCJ188R71H104KA12D
D2: B260AE-13; D_SMA_Handsoldering
L1: 33uH; L_Radial_D8.7mm_P5.00mm_Fastron_07HCP; Part Number RLB0914-330KL
Q3: DMN6140L-13; SOT-23-3
Q4: DMT616MLSS-13; SOIC-8_3.9x4.9mm_P1.27mm_HandSolder
Q5: MMBT3904-7-F; SOT-23
R10: 10; R_0603_1608Metric_Pad0.98x0.95mm_HandSolder; Part Number RC0603FR-1310RL
R11: 200mOhm; R_0805_2012Metric_Pad1.20x1.40mm_HandSolder; Part Number RL0805FR-7W0R2L
R12, R21, R26: 0; R_0603_1608Metric_Pad0.98x0.95mm_HandSolder; Part Number RC0603JR-070RL
R13: 3.16k; R_0603_1608Metric_Pad0.98x0.95mm_HandSolder; Part Number RC0603FR-073K16L
R14: 249; R_0603_1608Metric_Pad0.98x0.95mm_HandSolder; Part Number RC0603FR-07249RL
R15: 4.99k; R_0603_1608Metric_Pad0.98x0.95mm_HandSolder; Part Number RC0603FR-074K99L
R16: 10k; R_0603_1608Metric_Pad0.98x0.95mm_HandSolder; Part Number RC0603FR-0710KL
R17: 11k; R_0603_1608Metric_Pad0.98x0.95mm_HandSolder; Part Number RC0603FR-1311KL
R18: 24.9k; R_0603_1608Metric_Pad0.98x0.95mm_HandSolder; Part Number RC0603FR-0724K9L
R22: 13.7k; R_0603_1608Metric_Pad0.98x0.95mm_HandSolder; Part Number RC0603FR-0713K7L
R23: 27; R_0603_1608Metric_Pad0.98x0.95mm_HandSolder; Part Number RC0603FR-0727RL
R27: 0; R_0603_1608Metric_Pad0.98x0.95mm_HandSolder; Part Number RC0603JR-070RL; not fitted
RV1: 3362W-1-501LF
U1: UCC2813DTR-3; SOIC-8_3.9x4.9mm_P1.27mm_HandSolder
U9: SN74LVC1G17DBVR; SOT-23-5_HandSoldering
Z1: 0R; C_0603_1608Metric_Pad1.08x0.95mm_HandSolder; Part Number RC0603JR-070RL

Connections:
+5V: C18.1, C25.1, L1.1, R12.1, U9.5 (VCC); also elsewhere on the board
/CC Sink/STROBE-SAFE: U9.2; also elsewhere on the board
GND: C15.2, C16.2, C17.2, C18.2, C19.2, C21.2, C22.2, C24.2, C25.2, Q3.2, R11.1, R14.1, R27.1, U1.5 (GND), U9.3 (GND); also elsewhere on the board
unnamed: C20.2, R26.1, R27.2, Z1.2
unnamed: C23.1, R18.1
unnamed: D2.2 (A), L1.2, Q4.5 (D), Q4.6 (D), Q4.7 (D), Q4.8 (D)
unnamed: Q3.1, R23.2
unnamed: Q4.4 (G), R10.2
unnamed: Q4.1 (S), Q4.2 (S), Q4.3 (S), R11.2, R13.2
unnamed: Q5.1 (B), R17.1, R21.2
unnamed: C16.1, Q5.3 (C), R17.2, R22.2, U1.8 (REF)
unnamed: Q5.2 (E), R18.2
unnamed: R14.2, RV1.2
unnamed: R16.1, Z1.1
unnamed: R23.1, U9.4
unnamed: C20.1, Q3.3, R16.2, U1.1 (COMP)
unnamed: C22.1, C23.2, R13.1, R22.1, U1.3 (CS)
unnamed: R15.1, R26.2, RV1.1, U1.2 (FB)
unnamed: R10.1, U1.6 (OUT)
unnamed: C21.1, R21.1, U1.4 (RC)
unnamed: C15.1, R12.2, U1.7 (VCC)
VIR: C17.1, C19.1, C24.1, D2.1 (K), R15.2; also elsewhere on the board

Notes on the sheet:
Zero Duty Cycle Control
<- Variable Voltage
750kHz
15 - 42V Boost Converter @ 100mA

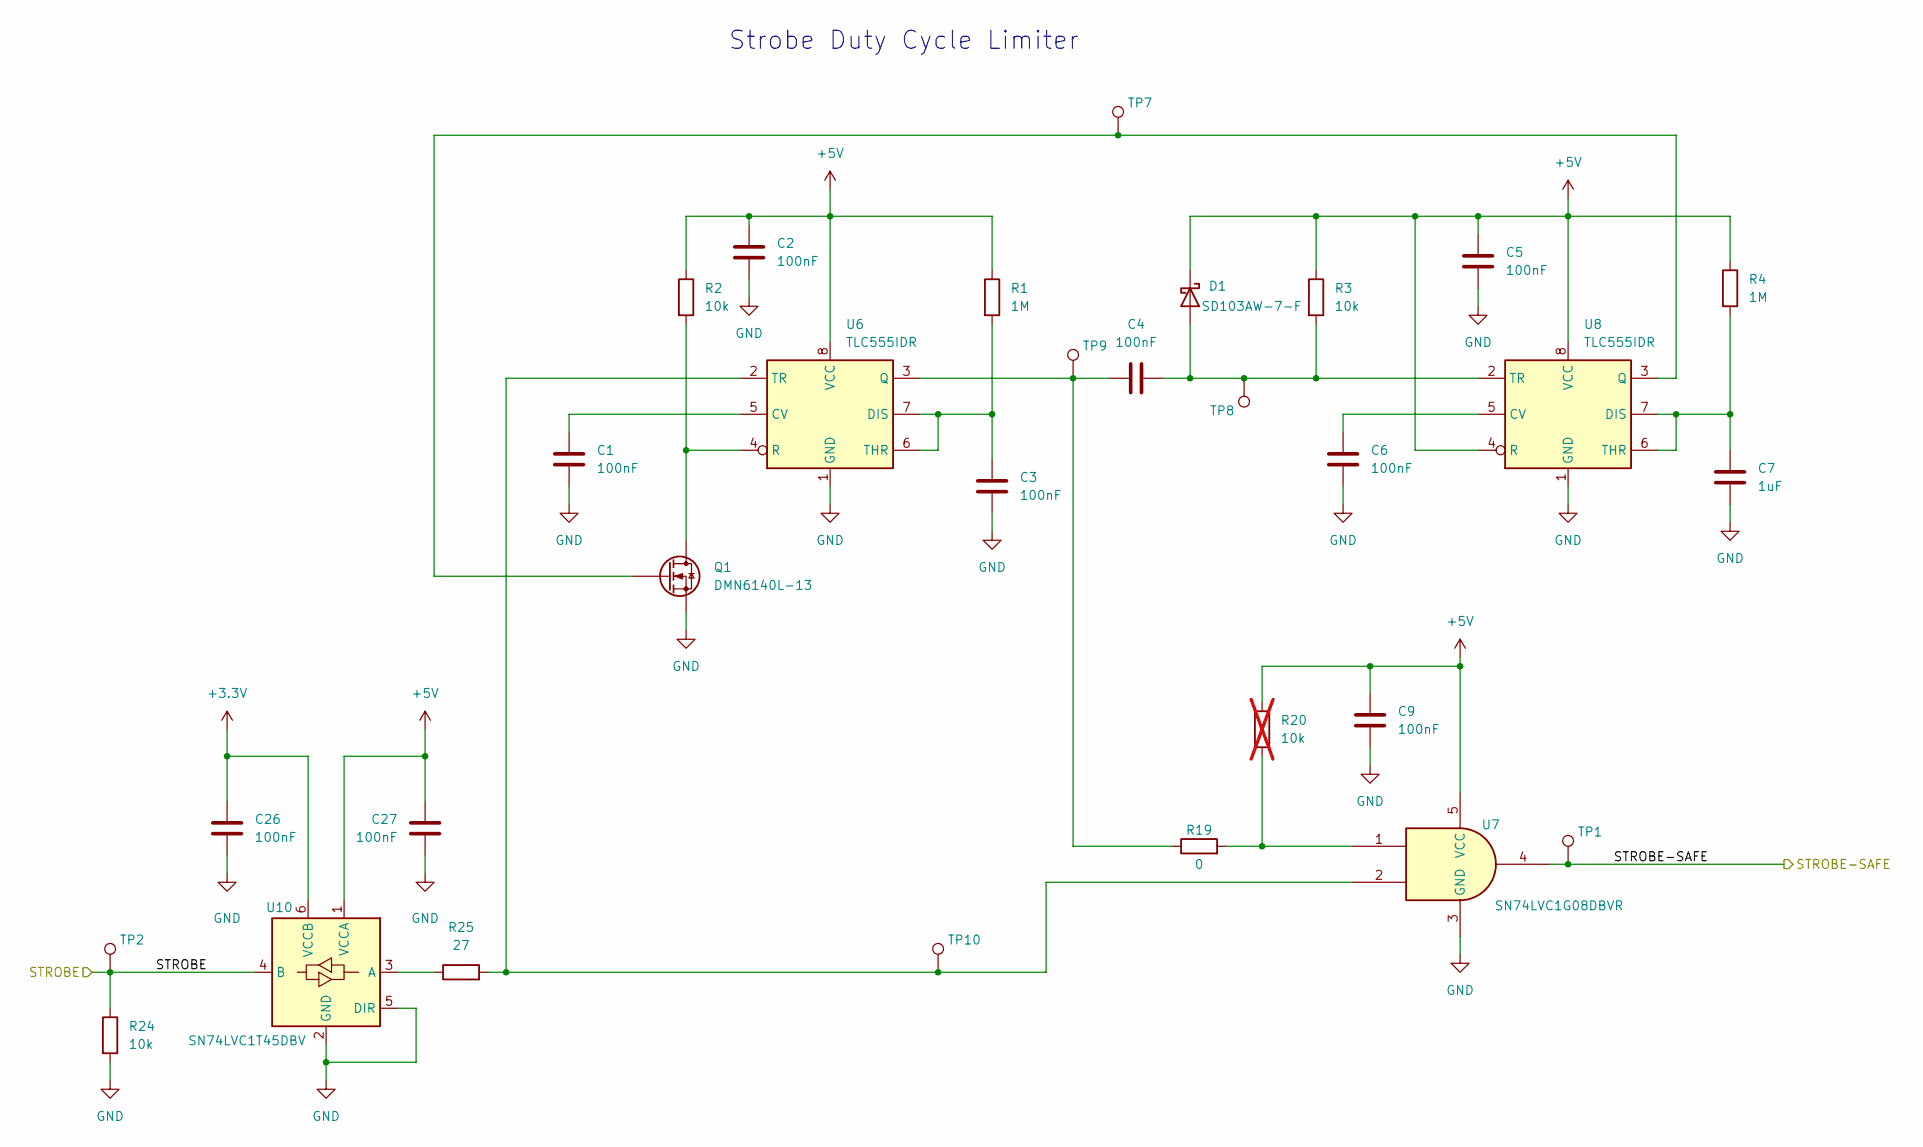
[picture p171: schematic LED_Connection.kicad_sch, Dual RPi5 Connector Board]

Parts:
C1, C2, C3, C4, C5, C6, C9, C26, C27: 100nF; C_0603_1608Metric_Pad1.08x0.95mm_HandSolder; Part Number GCJ188R71H104KA12D
C7: 1uF; C_0603_1608Metric_Pad1.08x0.95mm_HandSolder; Part Number GCM188R71C105KA64J
D1: SD103AW-7-F; D_SOD-123_HandSolder
Q1: DMN6140L-13; SOT-23-3
R1, R4: 1M; R_0603_1608Metric_Pad0.98x0.95mm_HandSolder; Part Number RC0603FR-071ML
R2, R3, R24: 10k; R_0603_1608Metric_Pad0.98x0.95mm_HandSolder; Part Number RC0603FR-0710KL
R19: 0; R_0603_1608Metric_Pad0.98x0.95mm_HandSolder; Part Number RC0603JR-070RL
R20: 10k; R_0603_1608Metric_Pad0.98x0.95mm_HandSolder; Part Number RC0603FR-0710KL; not fitted
R25: 27; R_0603_1608Metric_Pad0.98x0.95mm_HandSolder; Part Number RC0603FR-0727RL
TP1, TP2, TP7, TP8, TP9, TP10: TestPoint; TestPoint_Pad_D1.0mm
U6, U8: TLC555IDR; SOIC-8_3.9x4.9mm_P1.27mm_HandSolder
U7: SN74LVC1G08DBVR; SOT-23-5_HandSoldering
U10: SN74LVC1T45DBV; SOT-23-6

Connections:
+3.3V: C26.1, U10.6 (VCCB); also elsewhere on the board
+5V: C2.1, C5.1, C9.1, C27.1, D1.1 (K), R1.1, R2.1, R3.1, R4.1, R20.1, U6.8 (VCC), U7.5 (VCC), U8.4 (R), U8.8 (VCC), U10.1 (VCCA); also elsewhere on the board
/CC Sink/STROBE-SAFE: TP1.1, U7.4; also elsewhere on the board
/Connectors/STROBE: R24.1, TP2.1, U10.4 (B); also elsewhere on the board
GND: C1.2, C2.2, C3.2, C5.2, C6.2, C7.2, C9.2, C26.2, C27.2, Q1.2, R24.2, U6.1 (GND), U7.3 (GND), U8.1 (GND), U10.2 (GND), U10.5 (DIR); also elsewhere on the board
unnamed: C4.2, D1.2 (A), R3.2, TP8.1, U8.2 (TR)
unnamed: R19.2, R20.2, U7.1
unnamed: C1.1, U6.5 (CV)
unnamed: C3.1, R1.2, U6.6 (THR), U6.7 (DIS)
unnamed: C4.1, R19.1, TP9.1, U6.3 (Q)
unnamed: Q1.3, R2.2, U6.4 (R)
unnamed: R25.2, TP10.1, U6.2 (TR), U7.2
unnamed: C6.1, U8.5 (CV)
unnamed: C7.1, R4.2, U8.6 (THR), U8.7 (DIS)
unnamed: Q1.1, TP7.1, U8.3 (Q)
unnamed: R25.1, U10.3 (A)

Notes on the sheet:
Strobe Duty Cycle Limiter

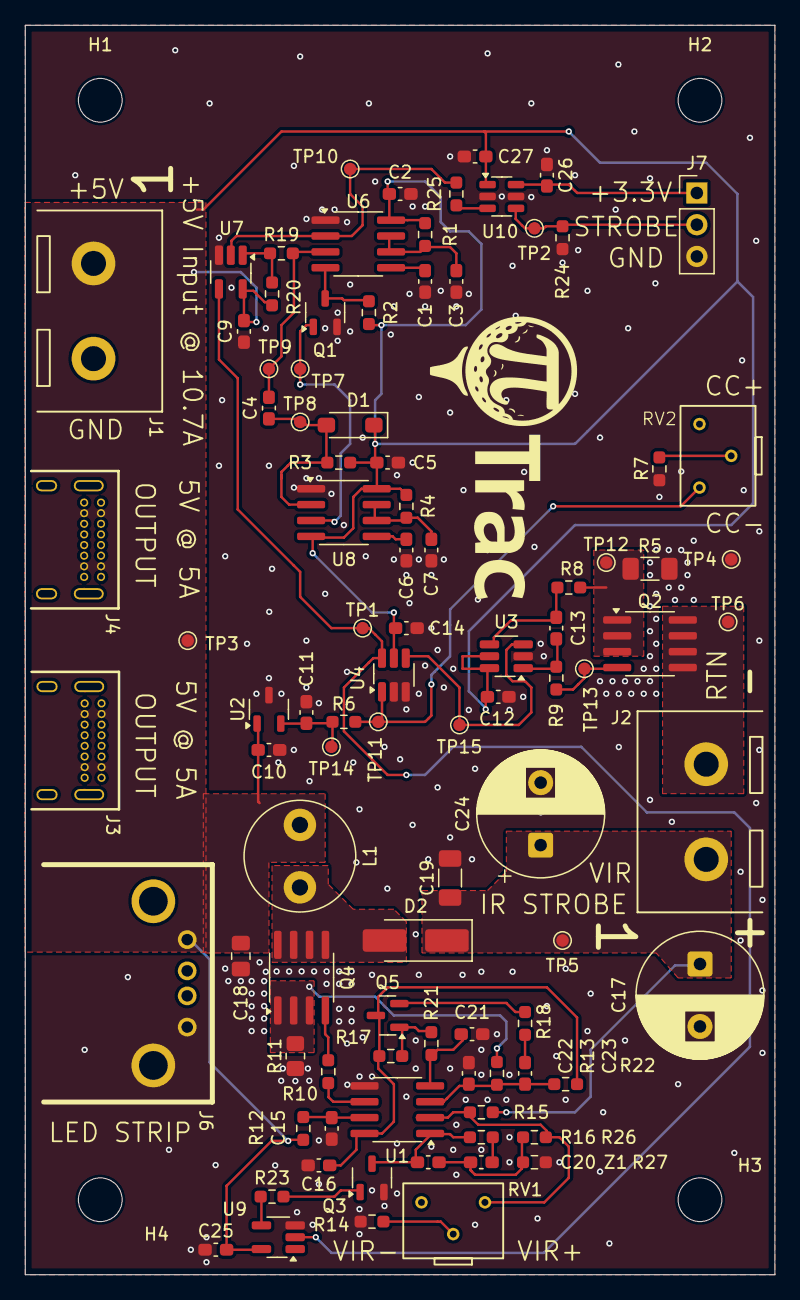
[picture p172: board PiTrac Pi Connector.kicad_pcb from above]

Board: 2 copper layers, 60.0 x 100.0 mm, 98 parts (0 on the bottom side), 44 nets.
