jeshernandez/PiTrac/(commit log)

2025-07-16 Organizing the documentation a bit before we move to a new platform.
    [PiTrac - Camera Calibration Worksheet.xlsx]
2025-07-16 Update PiTrac – START HERE.md
2025-07-17 Correct trace log.
2025-07-17 Shortened the time by one-third that the Cam 1 process waits for the Cam 2 process to arm.
2025-07-24 Added test case for InnoMaker.
2025-07-29 Added additional test case support for InnoMaker.
2025-07-30 Added additional test case support for InnoMaker.
2025-07-30 Fixed potential crash when no balls found. Added test code for InnoMaker cameras. Tweaked image processing for externally-strobed (e.g., Uneekor) test environments.
2025-07-30 Removed InnoMaker experimental code (which was breaking images for Pi cameras).
    [spin_analysis_coarse.csv, spin_analysis_fine.csv]
2025-07-31 Synchronizing local build with github.
    [spin_analysis_coarse.csv, spin_analysis_fine.csv]
2025-08-05 Added code to accomodate the InnoMaker IMX296 camera. Fixed a compile warning in ball_image_proc.cpp.
    [lm_main.cpp]
2025-08-05 Update PiTrac - DIY LM Parts List.md
    Clarified the necessary visible-light-cut filter and changed the camera recommendation to be the InnoMaker cameras.
2025-08-11 Migrate old documentation (#102)
    [PiTrac-Camera-Calibration-Worksheet.xlsx]
2025-08-20 Update docs to include links to new docs and fix a couple final dead … (#110)
    * Update docs to include links to new docs and fix a couple final dead links
    * resolve build issues
    * Update all image path to use relative path helper from Jekyll
2025-08-21 YOLO Ball Detection (#104)
    * LMSource integration for YOLO
    * Add Trained Models, Training Data, CLI Interface, and Configs
    * preload yolo and do not load every frame
    * Single class NMS
    * Use YOLO for ball detection too
    [results.csv]
2025-08-22 Created scripts to run PiTrac in a mode where it simply processes one simulate shot from kTwoImageTestTeedBallImage and kTwoImageTestTeedBallImage settings in the golf_config_sim.json testing section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
    [spin_analysis_coarse.csv, spin_analysis_fine.csv]
2025-08-22 Now using PITRAC_ROOT to determine the absolute paths to the YOLO data. Downgraded a few info logging statements to be trace instead (trying to keep the info statements to things that an end user wou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
2025-08-25 Only run camera and images tests when chages are made to certain places
2025-08-26 fix expectations around camera configs for testing
2025-08-26 give lens fallback to fix test issue
2025-08-27 Update to include new YAML base d CLI Configuration tooling with backwards compatibilty.
    [configuration_manager.h]
2025-08-27 Fix backwards compatibility + Overwriting
    [configuration_manager.h]
2025-09-01 Fix deps as well as mq +camera configuration handling (#129)
    * Fix deps as well as mq +camera configuration handling
    * Restart services
2025-09-03 Added check for single-pi operation (2 cameras on one pi) and if so, the postinst and pitrac setup code will add the appropriate kernl dtoverlays to the config.txt boot file, or otherwise tell the us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
2025-09-05 Add new connector board files from Mark (#135)
    [Connectors.kicad_sch, LED_Connection.kicad_sch, Pi Connector Adjustable Constant Current.xlsx, Pi Connector Adjustable Strobe Voltage.xlsx, Pi Connector Boost Converter.xlsx, Pi Connector Strobe Capacitance.xlsx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]
2025-09-07 Update hardware documentation to correct some errors and further elaborate on some other points.
    [PiTrac Pi Connector.kicad_pcb]
2025-09-16 WIP Feature/python webserver (#130)
    * Remove Tomee and Implement fresh Python GUI
    * Archive Dev Folder
    * change camera startup order
    * Start cleaning up old docs
    * Log viewing
    * Logs styling
    * pi detection
    * add error display
    * Logging for web server
    * deps + pi detect fix
    * add fallbacks + more logging
    * Lint
    * Lint + update tests
    * more linting
    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
    [lm_main.cpp]
2025-09-17 Temporary fix for strobe synchronization
    The PulseStrobe::kPrimingPulseFPS constant should be being picked up from the config environment in the camera 2 processs, but it not currently. So, this is a temporary fix to ensure that the constants is the same for both processes. The difference (15 versus 30 FPS) was causing the strobe pulses to be un-synchronized with the camera shutter.
2025-09-18 Added a new tower model for a Single Pi and the new V2 Connector Board
    [ConnectorBoard_V2.FCStd, PiTrac Pi Connector.step, Tower-Backplate - Pieces Separated For Printing.stl, Tower-Backplate.3mf, Tower-Backplate.stl, Tower-Frontplate - Pieces Separated For Printing.stl, Tower-Frontplate.3mf, Tower-Frontplate.stl]
2025-09-19 Fixed a strobe-camera synchronization problem by ensuring that the pulse-strobing constants are consistently set in both camera 1 and camera 2 processes.
2025-09-24 Release latest model, remove old models and old ml code
    [results.csv]
2025-09-25 Fixed problem with latest InnoMaker camera driver that requires the denoise option to be set to auto, not cdn_off.
2025-10-02 Rename Connector Board Folders (#149)
    * Rename Connector Board Folders
    * Add file from Mark
    [Connectors.kicad_sch, LED_Connection.kicad_sch, Pi Connector Adjustable Constant Current.xlsx, Pi Connector Adjustable Strobe Voltage.xlsx, Pi Connector Boost Converter.xlsx, Pi Connector Strobe Capacitance.xlsx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]
2025-10-03 Update DEB installs with optimized versions and fix calibration (#148)
    - Use DEB packages instead of Tar
    - Quiet down logging
    - Various Bugfixes
    - Rework UI based calibration
    [lm_main.cpp]
2025-10-09 Rewrite Docs (#151)
    * WIP
    * Rename Connector Board Folders (#149)
    * Update DEB installs with optimized versions and fix calibration (#148)
    * add screenshots for new UI to be used in docs (#150)
    * Software Updates
    * Camera + Calibration Docs
    * Hardware Docs + update readme
    * errata update
    * HW docs changes from Mark
    * Quickstart + updates around OS version support
    * Final Mark Changes
    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
2025-10-28 Widened the threaded-insert diameter value for the Pi mounting risers to better fit the inserts.
    [Master Document.FCStd]
2025-10-28 Update assembly notes with insert and screw specifications
    Added specific insert and screw details for assembly.
2025-10-28 Revise parts list for Version 2 enclosure hardware
    Updated hardware parts list to reflect Version 2 enclosure changes and deprecated Version 1 hardware.
2025-10-29 Modified basebox to accept new, smaller, Meanwell LRS-75 power supply.
    [BaseBox- Light Shield Body.3mf, BaseBox- Light Shield Body.stl, BaseBox- Main Body.3mf, BaseBox- Main Body.stl, BaseBox-End Cap.3mf, BaseBox-End Cap.stl, BaseBox.FCStd, C14 Panel Mount Power Plug Adapter w Fuse - JR-101-1F.FCStd]
2025-11-06 Added configuration option to set which version of the Connector Board is in use. The system then takes the version to determine whether or not the external trigger for the camera 2 shutter will be i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
2025-11-08 Fixed calibration testing so that the tests are run with the currently selected logging level.
2025-11-15 Added processing to flip the cmaera images of either or both cameras so that the cameras can be mounted either upside-up or upside-down. This makes it easier to not have to flip the MIPI cables. The 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
    [lm_main.cpp]
2025-11-20 Updating main index page PiTrac picture with version 2 enclosure.
2025-11-20 Switching Visual Studio project version of PiTrac to the latest Microsoft toolset.
    [BaseBox- Main Body.3mf, BaseBox- Main Body.stl, BaseBox.FCStd, C14 Panel Mount Power Plug Adapter w Fuse - JR-101-1F.FCStd, LRS-150 Meanwell.FCStd, Master Document.FCStd, Meanwell LRS-75.FCStd, Tower.FCStd]
2025-11-26 Calibration improvements generally. Specifically, now re-generating generated_golf_sim_config.json whenever the user saves changes to the configuration parameters (e.g., to ensure that calibration.js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
    [gs_calibration.cpp]
2025-11-26 Fixed problem where if calibration was run before ever starting PiTrac normally, the generated_golf_sim_config.json file had not been generated. Now, it's re-generated everytime calibration is run.
2025-11-26 Starting to update auto-calibration documentation.
2025-12-09 Fix for first payload setting ball ready to false.
    [gs_gspro_results.cpp, gs_results.cpp, gs_sim_interface.cpp, gs_sim_interface.h]
2025-12-27 Added documentation on how to fix the slow-pulse-shutdown problem on the V2 Connector Board, along with associated assets.
2025-12-27 Correcting modification document to add missing information about resistors R19 and R20.
2026-01-02 Various changes - added a custom lens selection with an editable default focal length; fixed bug where use of YOLO could not be set differently for the placed-ball and strobed-ball detectionmethods; 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
    [gs_calibration.cpp, lm_main.cpp]
2026-01-22 Various changes - changed default camera 2 gain to less (3). Changed number of pulses for putting to be 1, not 8 because things for putting were too bright. Changed motion detection to be more sensit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
2026-01-25 Added HLA and VLA offsets. Added new enclosure-version setting that is used to help determine which set of auto-calibration ball-positioning constants are to be used.
2026-02-13 Updated files related to camera processing with libcamera library to reflect recent changes in libcamera. These updates largely just mirror the also-recent changes in the rpicam-apps source code that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
2026-02-20 Improvements HLA accuracy. Also fixed bug in HLA and VLA offset processing. Also made a few changes to make it easier to compile and test in Visul Studio on Windows.
    [configuration_manager.h]
2026-02-22 Archive V2 Connector, Added V3 Connector and IRLED boards and assemblies. Update documentation to reflect new parts list.
    [ADC.kicad_sch, Connectors.kicad_sch, DAC.kicad_sch, IRLED Bill of Materials.csv, IRLED Centroid.csv, IRLED Only Bill of Materials.csv, IRLED Only Centroid.csv, IRLED Only.kicad_pcb]
2026-03-05 Added a new enumerated value for Version 3 Connector Boards and a check before start-up to ensure such boards are calibrated.
2026-03-05 Added a new enumerated value in UI for Version 3 Connector Board.
2026-03-05 Replace IRLED1 [Original] with IRLED2. Fixes problem supporting cheap IRLED we found right before heading to fabrication.
    [IRLED Only.kicad_pcb, IRLED.kicad_sch, IRLED2 Bill of Materials.csv, IRLED2 Centroid.csv, IRLED2 Only Bill of Materials.csv, IRLED2 Only Centroid.csv, V3 Connector + IRLED.kicad_pcb, V3 Connector + IRLED2 Bill of Materials.csv]
2026-03-10 Remove R6 from BOM and Centroid files.
    [Connectors.kicad_sch, Strobe Generation.kicad_sch, V3 Connector + IRLED.kicad_pcb, V3 Connector + IRLED2 Bill of Materials.csv, V3 Connector + IRLED2 Centroid.csv, V3 Connector Only Bill of Materials.csv, V3 Connector Only Centroid.csv, V3 Connector Only.kicad_pcb]
2026-03-18 Finalized V3 Connector BOM based on testing on hardware.
    [Connectors.kicad_sch, DAC.kicad_sch, Strobe Generation.kicad_sch, V3 Connector + IRLED.kicad_pcb, V3 Connector + IRLED2 Bill of Materials.csv, V3 Connector + IRLED2 Centroid.csv, V3 Connector Only Bill of Materials.csv, V3 Connector Only Centroid.csv]
2026-03-18 Fixed the camera-flip-upside-down code so that the image is flipped not only vertically, but also horizontally. This supports mounting cameras upside down in the enclosure, for exampl for better cabl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
2026-03-20 Changed connection board default to Version 3
2026-03-25 Update parts list with filter settings to help find alternate components when mainline component goes out of stock.
2026-03-25 Add V3 Enclosure design
    [5x2IRLED_Eyeball.FCStd, 5x2IRLED_Eyeball.step, 5x2IRLED_Eyeball.stl, Acrylic_Backplate.FCStd, Ambient_LED_Screen.FCStd, Ambient_LED_Screen.stl, Ambient_LED_Screen.stp, Ambient_LED_Visor.FCStd]
2026-03-30 [Feature] V3 Board Calibration GUI (#186)
2026-04-01 [Feature] - New ML Model, greatly improved spin processing (#191)
    [best.ncnn.param]
2026-04-01 v2 board: moved mosfet board to the left for ethernet cable clearance
    [ConnectorBoardv2-Mod_Carrier.FCStd, ConnectorBoardv2-Mod_Carrier.step, ConnectorBoardv2-Mod_Carrier.stl]
2026-04-01 Feature/calibration safety (#192)
2026-04-06 fix calibration hang from single-process pulse timing race
2026-04-06 delay between priming and trigger so camera produces separate frame events
2026-04-08 Add ML Based Spin Detection (#194)
    [best.ncnn.param]
2026-04-09 restore GPIO10 after strobe calibration
2026-04-09 update models
    [best.ncnn.param]
2026-04-14 [FEATURE] - Auto lens distortion calibration (#195)
