jeshernandez/PiTrac/docs/assets/images/hardware/V2_Connector_Board_MOSFET_module_addition.jpeg

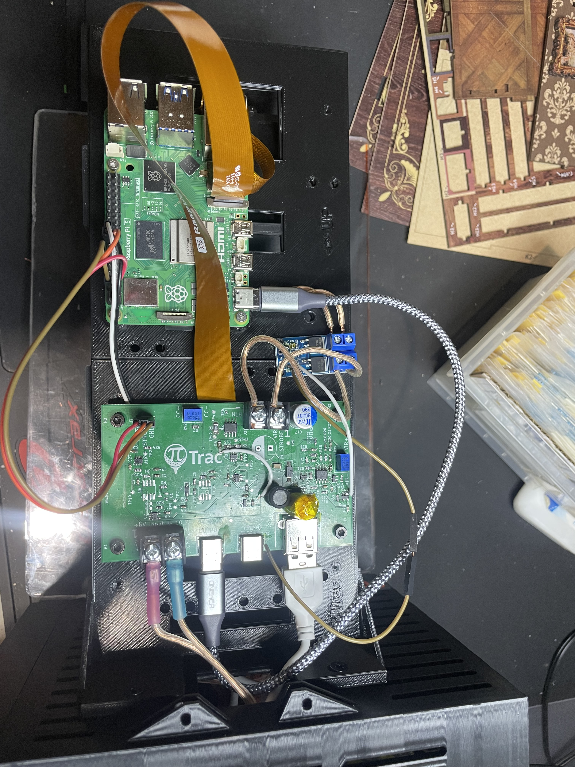
[picture p8: docs/assets/images/hardware/V2_Connector_Board_MOSFET_module_addition.jpeg]
docs/assets/images/hardware/V2_Connector_Board_MOSFET_module_addition.jpeg
